VitomirDragan/TemperatureManagement-IOT-/Documentatie/DiplomaProject/interfata utilizator.tex

\chapter{Ghidul utilizatorului}\label{ch:5interfataUtilizator}

	În acest capitol voi descrie felul în care utilizatorul poate să interacționeze cu aplicația web și cu macheta ce simulează circuitul de încălzire dintr-un imobil, iar în cele din urmă voi prezenta una dintre optimizările esențiale aduse sistemului.

\section{Interfața cu utilizatorul}

	Toate paginile au aceeasi structură: antet, meniu de navigare și secțiune pentru afișarea conținutului.
	Antetul conține o imagine și un logo.
	Bara de navigare se adaptează în funcție de rolul utilizatorului, unele butoane devin, sau nu, disponibile.
	Secțiunea de conținut este diferită la fiecare pagină în parte.
	
\vspace{0.5em}

	Pagina \textit{Login} – structura acestei pagini este diferită față de celelalte. Conține un div cu imagine de fundal și un formular care face posibilă conectarea la aplicația web. Se vor introduce credențialele în câmpurile puse la dispoziție, iar după validarea acestora, se face redirecționarea la pagina principală.

\begin{figure}[H]
   	\centering
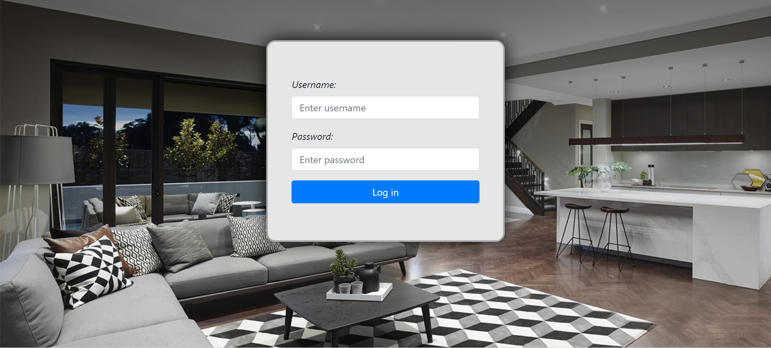
[picture p15: Documentatie/DiplomaProject/fig/Login.PNG]
    	
	\caption{Pagina de conectare}
\end{figure}

	Pagina \textit{Home} – este accesibilă pentru toți utilizatorii și permite monitorizarea si setarea temperaturii. Modificarea valorii temperaturii se face prin intermediul cursoarelor prezente pe pagină. Butonul \textit{Set temperature} va determina actualizarea valorilor în baza de date. Pentru a putea modifica modul de operare al sistemului, se actionează butonul din dreptul etichetei \textit{Switch intervals on/off}. Dacă modul de operare pe intervale orare este activat, alăturat butonului \textit{on/off}, va mai apărea un buton ce va permite redirecționarea la o nouă pagină unde se pot seta intervalele orare și temperaturile.

\begin{figure}[H]
   	\centering
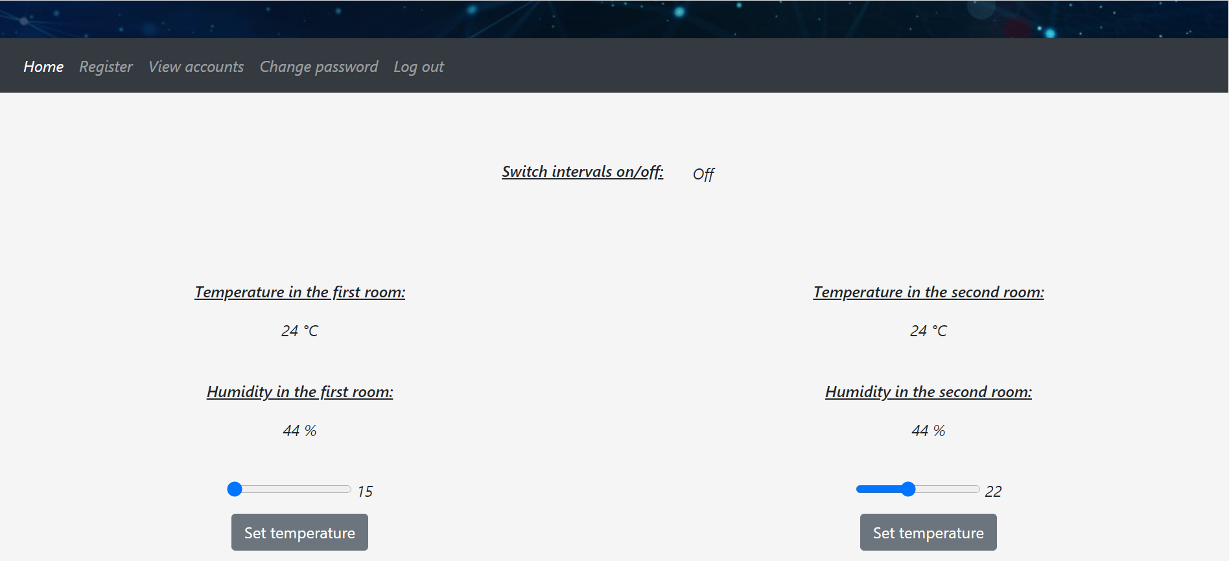
[picture p16: Documentatie/DiplomaProject/fig/Home.PNG]
    	
	\caption{Pagina de setare a temperaturilor}
\end{figure}

	Pagina pentru setarea unui program de funcționare este disponibilă doar în modul automat. Fiecare câmp creat pentru introducerea valorii temperaturii conține o etichetă ce indică intervalul pentru care este valabilă temperatura setată. De exemplu, câmpul cu eticheta \textit{Temperature 1} va conține valoarea temperaturii ce se aplică primului interval orar. Un interval orar are ca și capete două valori de timp setate în câmpuri consecutive.  

\begin{figure}[H]
   	\centering
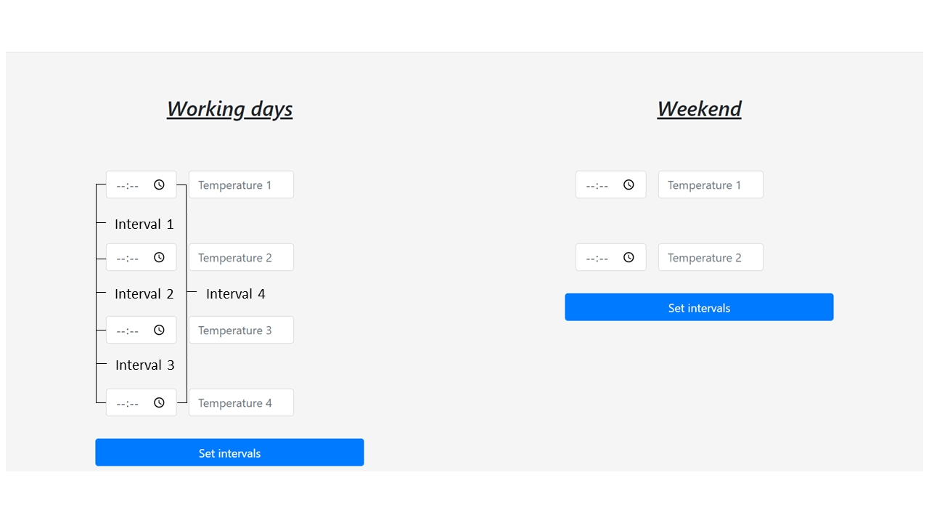
[picture p17: Documentatie/DiplomaProject/fig/SetIntervals.png]
    	
	\caption{Pagina de setare a programului de funcționare}
\end{figure}

	Pagina \textit{Register} – accesibilă doar pentru administrator și face posibilă crearea de noi conturi. Formularul permite introducerea credențialelor pentru contul creat, iar câmpul \textit{Give admin privileges?} este utilizat pentru setarea drepturilor.

\begin{figure}[H]
   	\centering
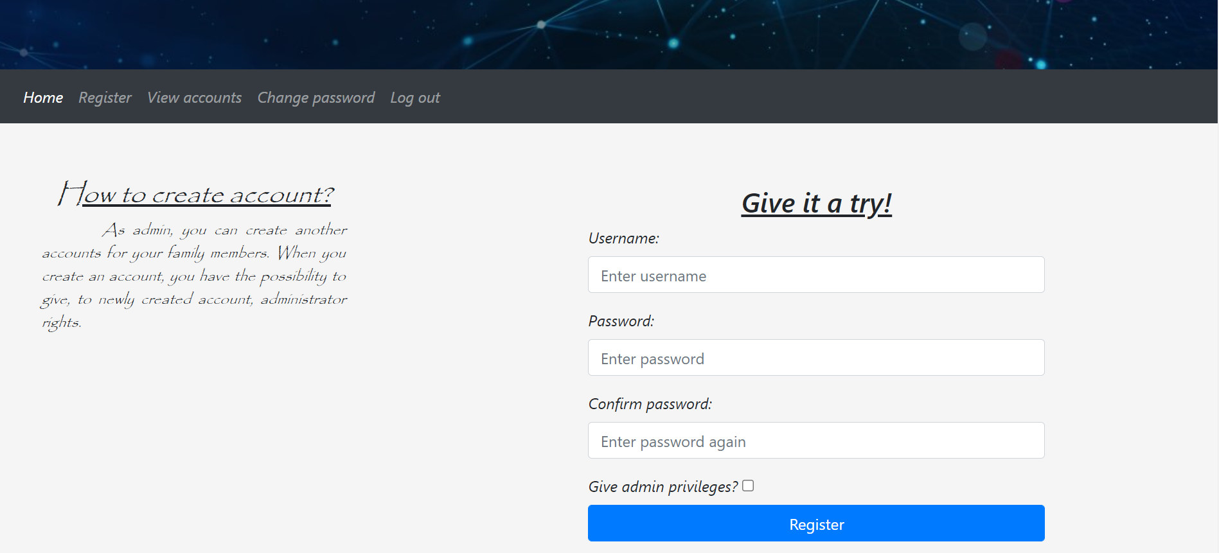
[picture p18: Documentatie/DiplomaProject/fig/Register.PNG]
    	
	\caption{Pagina creare cont}
\end{figure}

	Pagina \textit{View accounts} – este accesibilă doar de către administratori, oferind posibilitatea de a modifica drepturile utilizatorilor și de a șterge alte conturi. De asemenea, se afișează o listă cu toți utilizatorii, împreună cu drepturile acestora.

\begin{figure}[H]
   	\centering
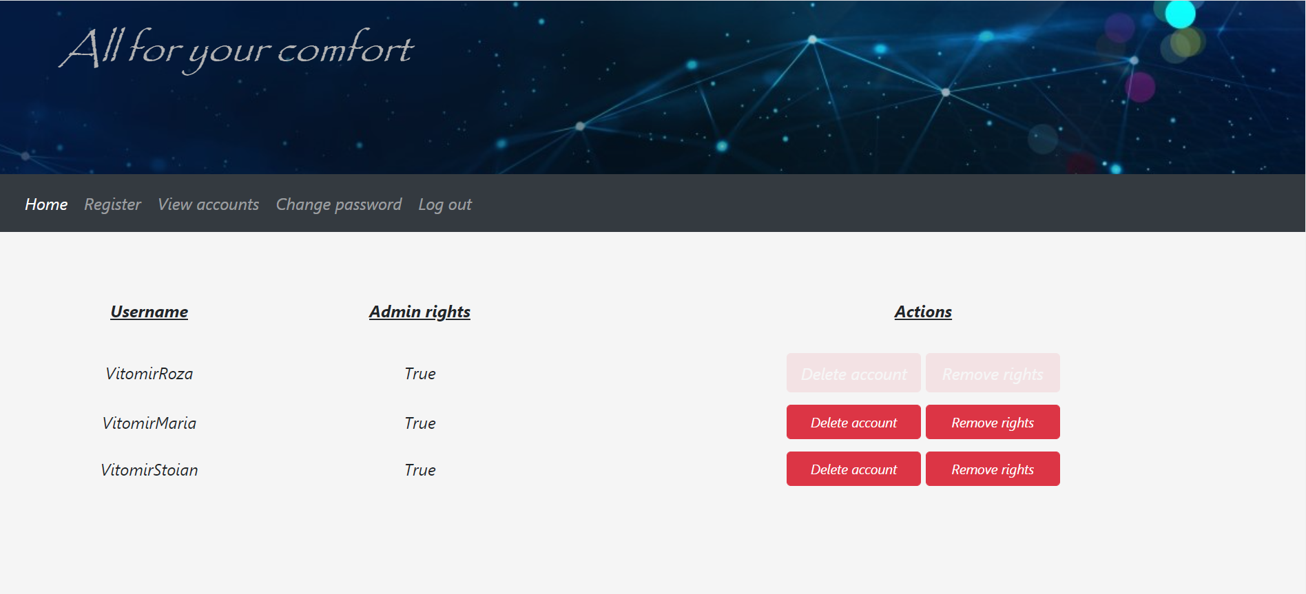
[picture p19: Documentatie/DiplomaProject/fig/ViewAccounts.PNG]
    	
	\caption{Pagina vizualizare conturi}
\end{figure}

	Pagina \textit{Change password} – permite modificarea parolei pentru fiecare utilizator. Câmpul \textit{Current password} trebuie completat cu parola actuală a contului curent, iar câmpurile \textit{New password} și \textit{Confirm new password} vor conține noua parolă, respectiv confirmarea noii parole.

\begin{figure}[H]
   	\centering
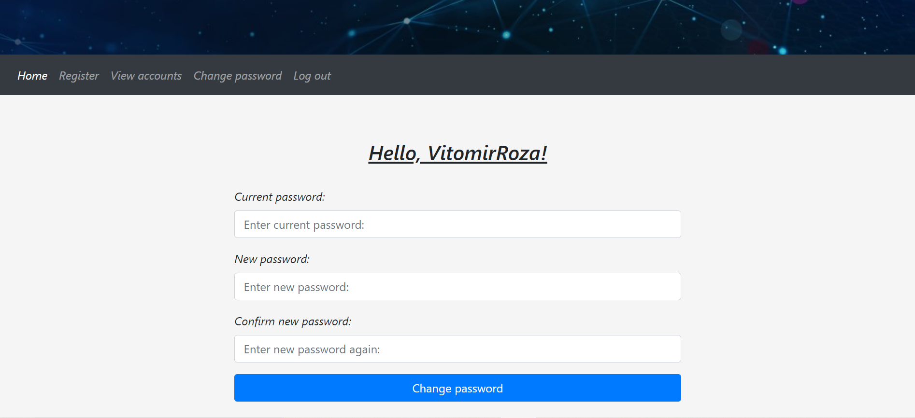
[picture p20: Documentatie/DiplomaProject/fig/changePassword.PNG]
    	
	\caption{Pagina schimbare parolă}
\end{figure}

\vspace{5em}

\section{Descriere și utilizare sistem}

	Pentru fiecare cameră în parte există un LCD ce va afișa, pe primul rând, temperatura ambientală, iar pe cel de-al doilea, temperatura setată de utilizator. Setarea temperaturii se face prin intermediul butoanelor situate în dreptul LCD-ului. Butonul poziționat în partea de sus este responsabil cu creșterea valorii temperaturii, pe când cel de jos va decrementa temperatura setată.

	Pompa de apă simulează funcționalitatea centralei termice, iar electrovalvele închid sau deschid circuitul de apă prin calorifer.
	
	Pentru a putea umple circuitul cu apă, se va utiliza aerisitorul. Acesta este montat în cel mai înalt punct al instalației.  

\begin{figure}[H]
   	\centering
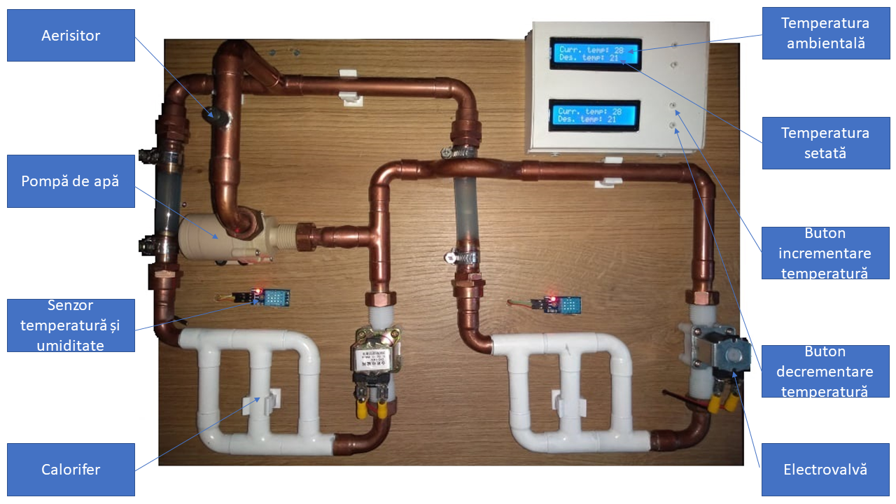
[picture p21: Documentatie/DiplomaProject/fig/Macheta-instalatie.png]
    	
	\caption{Circuitul de apă al machetei}
\end{figure}

	În interiorul machetei se află plăcuțele cu microcontroler. Acestea îndeplinesc diverse funcționalități și transmit informații între ele pentru a face posibil managementul temperaturii. 

	Transferul informațiilor cu baza de date se realizează prin intermediul modulului ESP8266. 
	
	Arduino Uno controlează pompa de apă în funcție de comenzile primite de la modulele wireless. Comunicația între modulele WiFi și plăcuța Arduino este posibilă datorită transmițătoarelor și receptorului ce funcționează prin radio - frecvență.

	Sunt utilizate transformatoare de 12 volți pentru alimentarea componentelor electronice.

\begin{figure}[H]
   	\centering
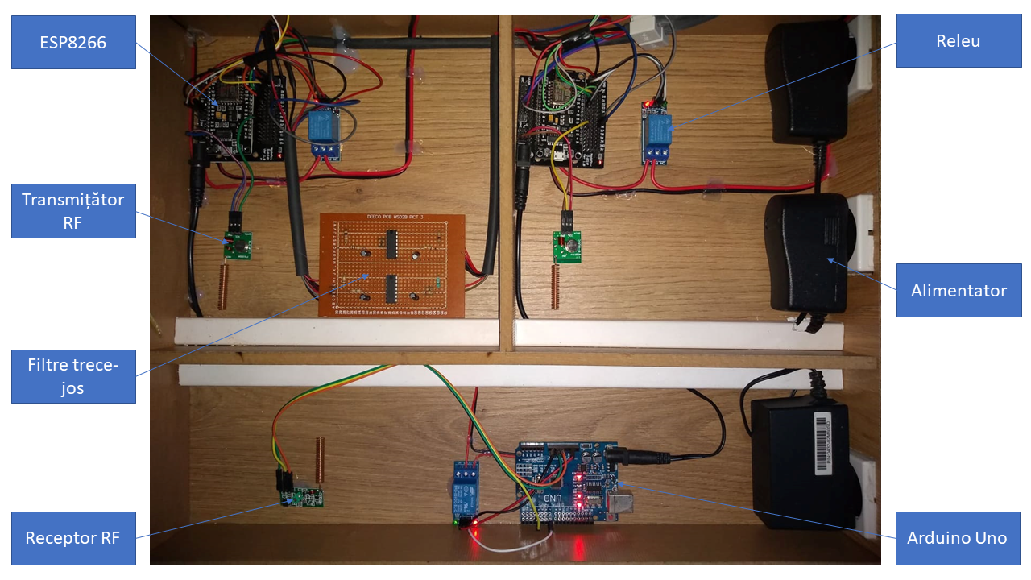
[picture p22: Documentatie/DiplomaProject/fig/Macheta-hardware.png]
    	
	\caption{Partea hardware a machetei}
\end{figure}

\section{Optimizare}

	În acest subcapitol voi prezenta una din optimizările pe care a fost necesar să o implementez pentru a reduce consumul de date. Resursele pe care baza de date le pune la dispoziție sunt limitate. Prin urmare, există și o limitare în ceea ce privește capacitatea datelor descărcate.

	Primele versiuni de cod pentru modulul WiFi făceau ca la fiecare iterație a instrucțiunii repetitive \textit{loop} să se citească valorile temperaturilor și intervalelor din baza de date. Motiv pentru care, consumul de date era mare.  În figura următoare, este ilustrată cantitatea de date citite în decursul a unei jumătăți de oră de funcționare.
 
\begin{figure}[H]
   	\centering
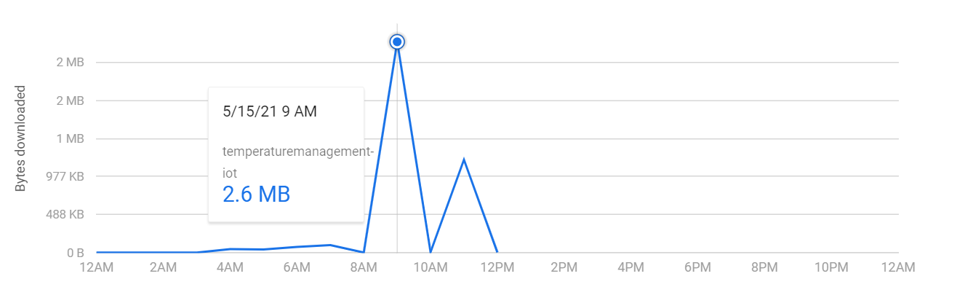
[picture p23: Documentatie/DiplomaProject/fig/FaraOptimizare.PNG]
    	
	\caption{Versiunea de cod neoptimizată}
\end{figure}

	Pentru a renunța la acest comportament, a fost necesară modificarea implementării codului. Astfel, citirile se vor realiza doar în momentul în care se modifică valorile din baza de date. În figura atașată, se ilustrează consumul de date în urma funcționării timp de jumătate de oră cu noul cod. În acest timp, pentru a face o simulare cât mai complexă, am setat diferite valori ale temperaturii prin intermediul aplicației web. 

\begin{figure}[H]
   	\centering
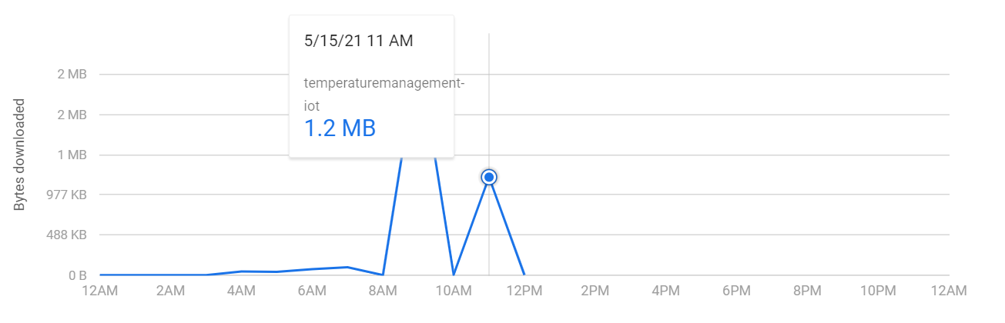
[picture p24: Documentatie/DiplomaProject/fig/CuOptimizare.png]
    	
	\caption{Versiunea de cod optimizată}
\end{figure}

	În urma acestui experiment, se poate observa o scădere considerabilă a consumului de date, fapt ce face posibilă funcționarea sistemului în mod continuu.
