VitomirDragan/TemperatureManagement-IOT-/Documentatie/DiplomaProject/state of the art.tex

\chapter{Prezentarea sistemelor similare}\label{ch:2sistemeSimilare}

	In momentul de față, acest subdomeniu se află la un nivel mare de răspândire. Există o serie de producători care comercializează sisteme ce permit controlul la distanță al temperaturii, însă au o deficență majoră și anume prețul ridicat. Voi prezenta mai multe astfel de sisteme, împreună cu detaliile tehnice ale acestora. 	

\section{Torelectric}
	Termostatul produs de firma Torelectric oferă mai multe modalități de reglare a temperaturii \cite{torelectric}:
	\begin{itemize}
  	\setlength{\itemindent}{2em}
		\itemsep0em
		\item Prin aplicație mobilă;
		\item Fizic, utilizând interfața termostatului;
		\item Prin comenzi vocale, utilizând Google Home și Alexa.
	\end{itemize}

	\begin{figure}[H]
    		\centering
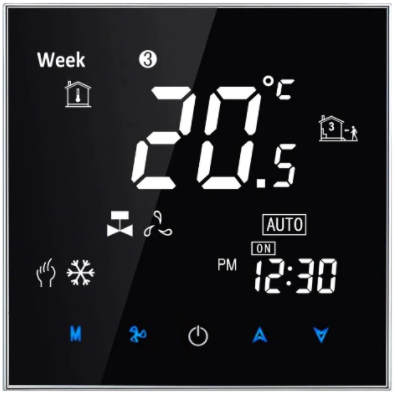
[picture p25: Documentatie/DiplomaProject/fig/Torelectric.PNG]
    		
		\caption{Termostat \textit{Torelectric} (sursa: \cite{torelectric})}
	\end{figure}

\vspace{2em}

	Ca și caracteristici principale se pot remarca \cite{torelectric}:
	\begin{itemize}
	\setlength{\itemindent}{2em}
		\itemsep0em
		\item Se conectează prin WiFi;
		\item Se alimentează la 220 de volți;
		\item Intervalul de setare al temperaturii este între 5 și 35 \textdegree{}C;
		\item Poate detecta valoarea temperaturii ambientale într-un interval între 0 și 45 \textdegree{}C.
	\end{itemize}

\section{Honeywell}

\begin{wrapfigure}{l}{0.55\textwidth} 
	\centering
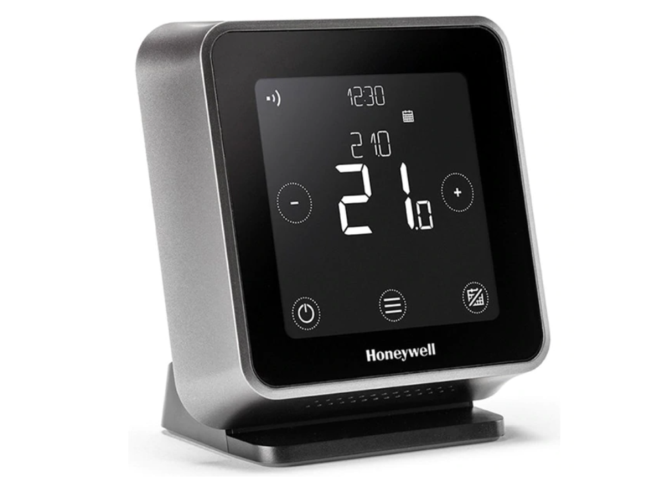
[picture p26: Documentatie/DiplomaProject/fig/Honeywell.PNG]
	
	\caption{Termostat \textit{Honeywell} (sursa: \cite{honeywell})}
\end{wrapfigure}

	Termostatul produs de Honeywell se diferențiază față de cel produs de Torelectric prin prezența unor funcționalități inovatoare. Printre particularitățile acestui dispozitiv se remarcă \cite{honeywell}:
	\begin{itemize}
	\setlength{\itemindent}{2em}
		\itemsep0em
		\item Adaptarea temperaturii în funcție de prezența sau absența unor persoane în locuință; 
		\item Programarea temperaturilor pentru șapte zile;
		\item Controlul de la distanță, oferit de aplicația mobilă;
		\item Setarea temperaturii prin comenzi vocale.
	\end{itemize}

	Comparativ cu primul sistem prezentat, cel de la Honeywell se deosebește prin tehnologia Geofencing. Acesta știe când imobilul nu este locuit, iar ca urmare, va dezactiva încălzirea. De asemenea, este capabil să detecteze momentul în care locuitorii sunt în apropierea casei, reușind să încălzească până la temperatura setată \cite{honeywell}.
	Un alt avantaj adus de cei de la Honeywell este posibilitatea de a seta temperatura pe decursul a șapte zile, fapt ce asigură un confort sporit, prin adaptarea temperaturii în funcție de diverse intervale orare \cite{honeywell}.

	Caracteristicile tehnice ale acestuia sunt \cite{honeywell}:
	\begin{itemize}
	\setlength{\itemindent}{2em}
		\itemsep0em
		\item Se folosește pentru centrale termice;
		\item Se alimentează la 220 de volți;
		\item Conexiunea la internet se realizează prin WiFi.
	\end{itemize}

	În continuare, voi prezenta două sisteme care reprezintă apogeul evoluției în acest domeniu. Acestea sunt produse de firme cunoscute precum: Google si Ecobee.

\section{Nest}
	Este un termostat inteligent produs de cei de la Google. Acesta oferă funcționalități avansate pentru un management cât mai eficient al temperaturii din imobil. 

	Spre deosebire de sistemele prezentate anterior, termostatele produse de Google Nest integrează tehnologii revoluționare pentru a obține un randament cât mai mare.

\vspace{2em}

	Principalele particularități ale acestuia sunt \cite{nest}:
	\begin{itemize}
	\setlength{\itemindent}{2em}
		\itemsep0em
		\item Capacitatea de a se programa automat, în funcție de rutina locuitorilor;
		\item Menține temperatura setată doar dacă există persoane în imobil, altfel trece automat la o temperatură ce asigură un consum cât mai mic de energie;
		\item Control de la distanță de pe laptop, tabletă și telefon;
		\item Salvarea unui istoric al consumului de energie;
		\item Tehnologie Geofencing;
		\item Se pot adăuga senzori pentru mai multe zone.
	\end{itemize}

\vspace{1em}

\begin{wrapfigure}[5]{l}{0.5\textwidth}
	\centering
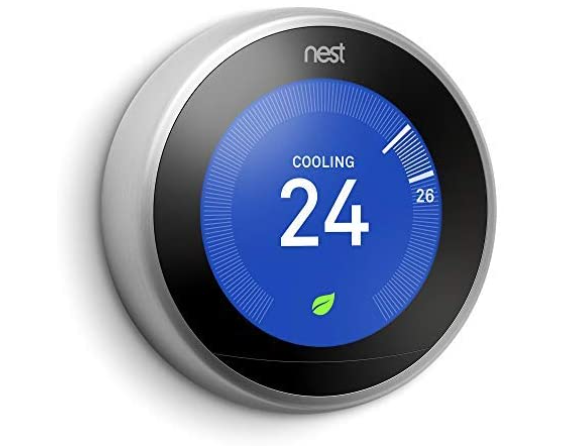
[picture p27: Documentatie/DiplomaProject/fig/Nest.PNG]
	
	\caption{Termostat \textit{Nest} (sursa: \cite{nest})}
\end{wrapfigure}

	Date tehnice \cite{nest}:
	\begin{itemize}
	\setlength{\itemindent}{2em}
		\itemsep0em
		\item Sursă de energie: baterii;
		\item Tensiune de funcționare: 24 volți;
		\item Afișaj digital;
		\item Conectivitate: WiFi.
	\end{itemize}

\vspace{3em}

\section{Ecobee}
	 Termostatul produs de firma Ecobee concurează cu Google Nest. Acesta oferă, pe lângă funcțiile complexe, posibilitatea de monitorizare detaliată a consumului de energie \cite{ecobee}.
	
\vspace{2em}

	Particularități \cite{ecobee}:
	\begin{itemize}
	\setlength{\itemindent}{2em}
		\itemsep0em
		\item Poate fi controlat prin intermediul unor aplicații precum: Apple HomeKit, Alexa built-in, Google Assistant și SmartThings. De asemenea, oferă posibilitatea de a seta temperatura de pe Android, dar si de pe iOS;
		\item Implementează un algoritm ce permite controlul temperaturii în diverse locuri din imobil. Se pot conecta mai mulți senzori de temperatura la termostat, iar în funcție de informațiile primite de la aceștia, menține o temperatură constantă în locuință;
		\item Ecranul se aprinde atunci când detectează o persoană în apropiere, iar pe lângă informațiile legate de temperatură si umiditate, se afișează și vremea pe decursul a cinci zile;
		\item Este prezentă tehnologia Geofencing.
	\end{itemize}

\vspace{2em}

\begin{wrapfigure}[5]{r}{0.5\textwidth}
	\centering
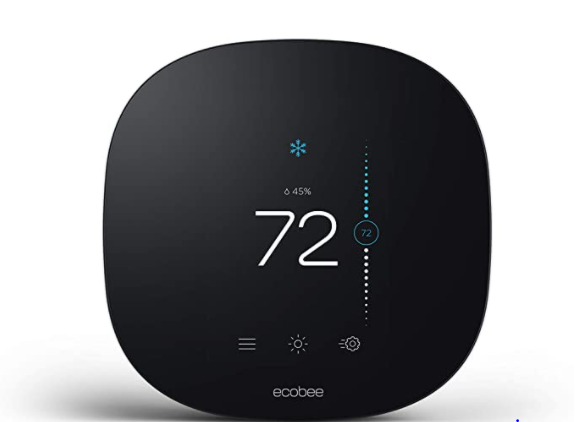
[picture p28: Documentatie/DiplomaProject/fig/Ecobee.PNG]
	
	\caption{Termostat \textit{Ecobee} (sursa: \cite{ecobee})}
\end{wrapfigure}

	Date tehnice \cite{ecobee}:
	\begin{itemize}
	\setlength{\itemindent}{2em}
		\itemsep0em
		\item Sursă de energie: baterii sau rețea;
		\item Tensiune de funcționare: 24 volți;
		\item Ecran tactil;
		\item Conectivitate: WiFi.
	\end{itemize}
\vspace{0.5em}

\section{Abordare comparativă a sistemelor prezentate}
	Dacă primele două sisteme prezentate reprezentau soluții mai ieftine, ultimele două sunt recunoscute ca fiind cele mai evoluate termostate existente pe piață. Diferențele esențiale sunt vizibile la nivelul funcționalităților oferite, dar și al calității.

	Lipsa posibilității de a programa în avans temperaturi pe mai multe intervale orare și zile, de a monitoriza temperatura în mai multe camere, de a stoca un istoric al consumului de energie și de a adapta temperaturile în funcție de rutina locuitorilor, sunt câteva din minusurile termostatelor Torelectric și Honeywell. Google Nest și Ecobee, pe lângă faptul că rezolvă aceste probleme, oferă și o experiență mult mai bună a utilizatorului. Interfețele sunt proiectate în așa fel încât să permită o navigare facilă prin meniurile sistemelor.  

	În continuare, cu ajutorul datelor preluate din \cite{ecobeeVSnest}, voi prezenta o analiză comparativă a sistemelor oferite de Google Nest și Ecobee. 

	Termostatul Nest înregistrează fiecare modificare de temperatură pe care utilizatorul o face. După o perioadă de timp, acesta va programa automat temperaturile din imobil în funcție de istoricul de temperaturi setate de utilizator. Ecobee nu prezintă această funcționalitate, dar oferă posibilitatea de a seta temperaturi diferite pe intervale orare diferite. 

	In ceea ce privește controlul prin comenzi vocale, Nest este compatibil cu un număr mai mic de asistenți virtuali(Google Assistant si Alexa). Ecobee este compatibil și cu Siri, fapt ce reprezintă un avantaj datorită numărului mai mare de potențiali clienți. 

	Tehnologia Geofencing constă în detecția momentului în care imobilul este gol și setarea unei temperaturi ce asigură un consum minim de energie. Totodată, poate detecta dacă locuitorii se apropie de imobil, pentru a ieși din modul economic și a asigura temperatura setată. Geofencing este prezent la ambele termostate, însă la Nest este mai avansat. Poate detecta mai multe telefoane, iar în cazul în care sunt persoane care rămân în locuință și nu au telefonul conectat la Geofencing, prezența acestora este sesizată prin senzorii de mișcare incorporați în detectoarele de fum Nest, iar modul eco nu va fi activat. Ecobee poate conecta un singur telefon la Geofencing, ceea ce poate reprezenta un dezavantaj.

	  Monitorizarea consumului de energie se face automat, dar cei de la Ecobee au pus mai mult accent pe această parte, iar raportul pe care termostatul îl face este mult mai detaliat. Se analizează datele în decursul a 18 luni și conține informații legate de: consumul total, influența vremii asupra consumului de energie și compară eficiența imobilului cu celelalte din zonă. Pe de altă parte, Nest poate înregistra doar cosumul în decursul a 10 zile. Acesta trimite mail-uri în fiecare lună cu un raport ce conține detalii de consum de energie și face comparație cu luna anterioară.

	Monitorizarea temperaturii se face în mai multe zone din imobil prin intermediul unor senzori adiționali. Cele două termostate încearcă să mențină o temperatură medie în locuință. Senzorii oferiți de Ecobee detectează și dacă se află cineva în încăperea respectivă. 

\section{Comparație cu sistemul prezentat în această lucrare}

	În urma analizei sistemelor existente pe piață, se pot observa două dezavantaje majore. În primul rând, menținerea unor temperaturi exacte în fiecare cameră din imobil este destul de greu de obținut. Chiar dacă se pot adăuga mai mulți senzori de temperatură, termostatele prezentate vor reuși să asigure o temperatură medie la nivel de imobil și nu o temperatură specifică la nivel de cameră. De asemenea, prețurile acestora sunt destul de ridicate. Prin proiectul de diplomă, am încercat să soluționez aceste probleme. Costurile pieselor pe care le-am utilizat sunt accesibile, iar electrovalvele montate pe returul caloriferelor au rolul de a asigura menținerea temperaturii setate în fiecare cameră.
