VitomirDragan/TemperatureManagement-IOT-/Documentatie/DiplomaProject/titlepage.tex

\newgeometry{centering}
\begin{titlepage}
    \begin{center}
        \begin{minipage}{0.3\textwidth}
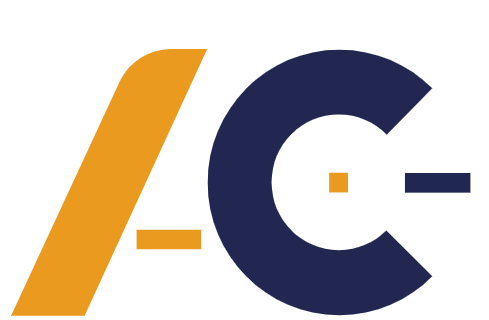
[picture p29: Documentatie/DiplomaProject/fig/ACLogo.jpg]
                \scalebox{0.25}{}
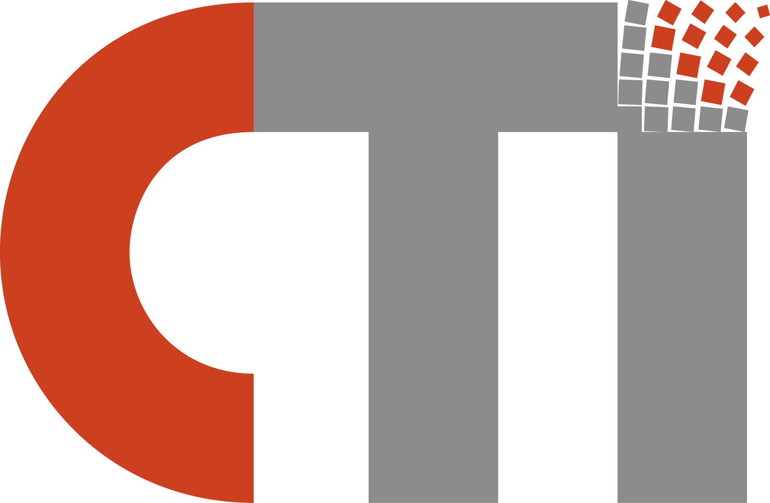
[picture p30: Documentatie/DiplomaProject/fig/DCTILogo.png]
                \scalebox{0.25}{}
        \end{minipage}%
        \begin{minipage}{0.4\textwidth}
            \centering
            \scriptsize
            Universitatea Politehnica Timișoara\\
            Facultatea de Automatică și Calculatoare\\
            Departamentul Calculatoare și \\Tehnologia Informației
        \end{minipage}%
        \begin{minipage}{0.3\textwidth}
            \begin{flushright}
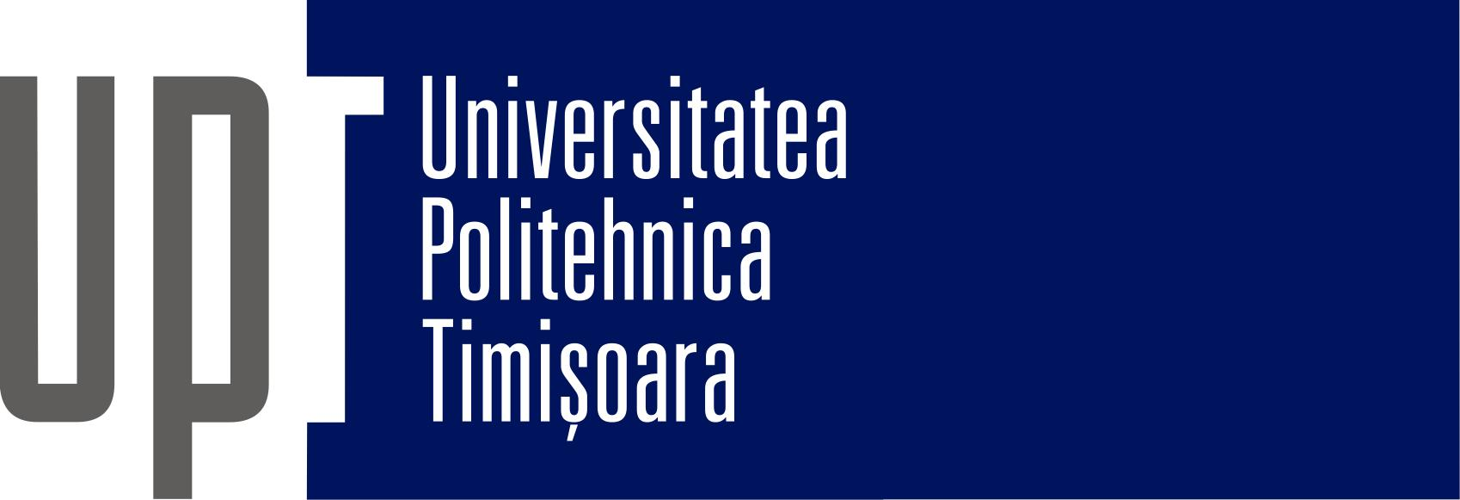
[picture p31: Documentatie/DiplomaProject/fig/UPTLogo.jpg]
                \scalebox{0.25}{}
            \end{flushright}
        \end{minipage}
    \end{center}
    
    \noindent\rule{\textwidth}{1pt}\\[4cm]
    
    \begin{center}
        \begin{doublespacing}
		{\huge \bfseries \textsc{Termostat inteligent controlat printr-o aplicație web}}\\[2.5cm]
	 \end{doublespacing}
        {\large \bfseries Proiect de Diplomă}\\[2cm]
        \begin{flushright}
            \large
            Autor:\\
	      Dragan VITOMIR\\[1cm]
        \end{flushright}
        \begin{flushleft}
            \large
            Conducător științific:\\
            Prof. Dr. Habil. Ing. Marius MARCU\\[2cm]
        \end{flushleft}
        {\small Timișoara \\Iunie, 2021}
    \end{center}
\end{titlepage}
\restoregeometry
\shipout\null
