VitomirDragan/TemperatureManagement-IOT-/Macheta-hardware.pptx

ESP8266

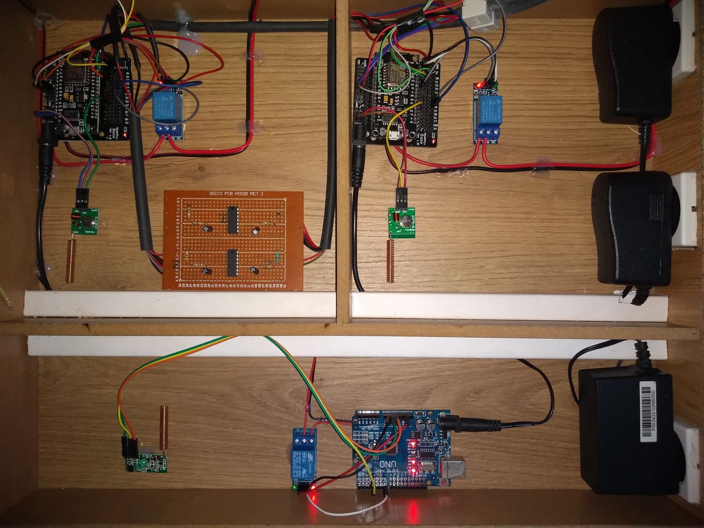
[picture p32: figure]

Releu

Transmițător RF

Alimentator

Filtre trece-jos

Receptor RF

Arduino Uno
