VitomirDragan/TemperatureManagement-IOT-/Macheta-instalatie.pptx

Aerisitor

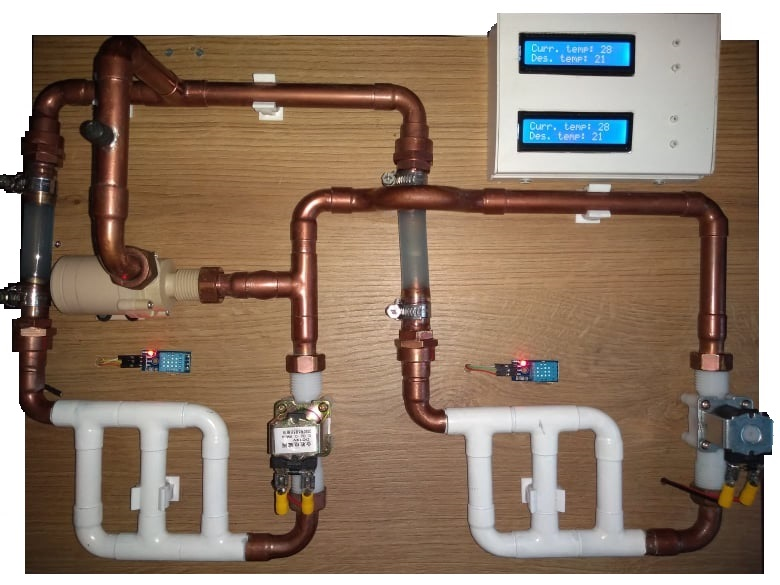
[picture p33: figure]
O imagine care conține text, interior Descriere generată automat

Temperatura ambientală

Temperatura setată

Pompă de apă

Buton incrementare temperatură

Senzor temperatură și umiditate

Buton decrementare temperatură

Calorifer

Electrovalvă
