VitomirDragan/TemperatureManagement-IOT-/Diagrame/Template etichete modul senzor.pptx

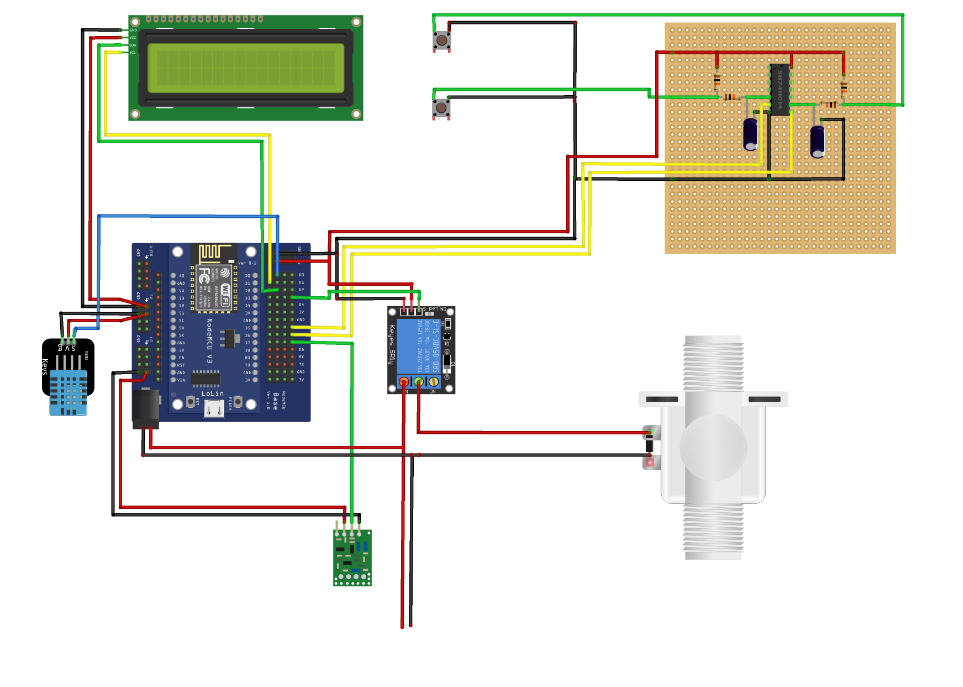
[picture p34: figure]

Inversor

LCD

Buton

Releu

DHT11

Diodă

ESP8266

Transmițător RF

Alimentator 12 V

Electrovalvă
