VitomirDragan/TemperatureManagement-IOT-/Diagrame/Template etichete modul control.pptx

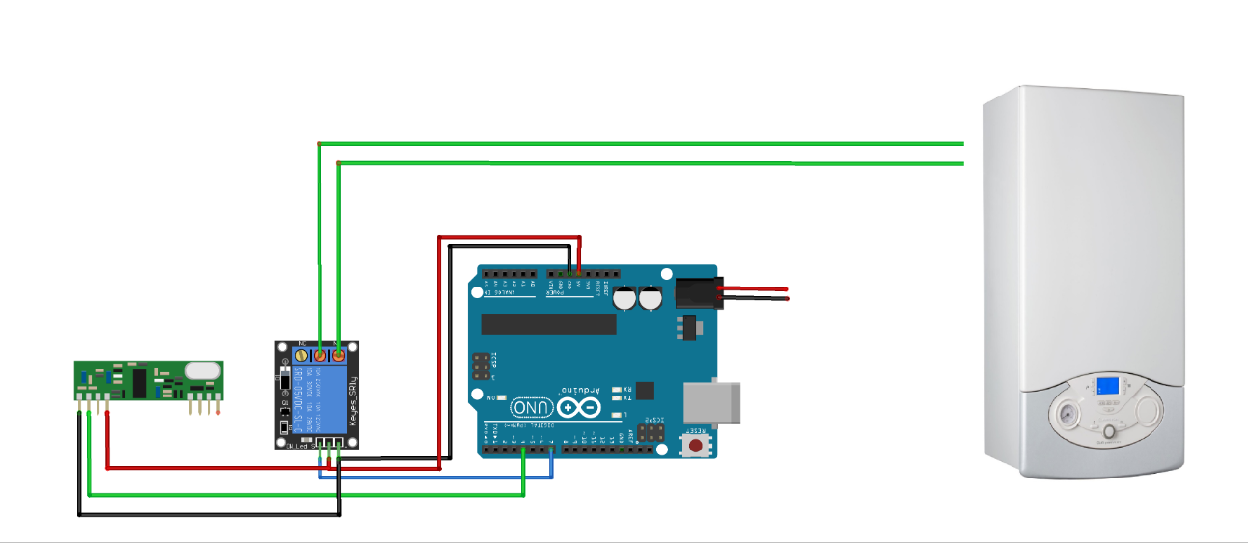
[picture p36: figure]

Releu

Receptor RF

Alimentator 12 V

Arduino

Centrala termică
