VitomirDragan/TemperatureManagement-IOT-/Documentatie/DiplomaProject/main.pdf

Universitatea Politehnica Timis,oara Facultatea de Automatica s ˘ ,
i Calculatoare
Departamentul Calculatoare s,

i
Tehnologia Informat,

iei

TERMOSTAT INTELIGENT,

# CONTROLAT PRINTR-O APLICAT

,

IE

# WEB

### Proiect de Diploma˘

### Autor: Vitomir Dragan

Conducator s ˘ ,
tiint,

### ific Prof. Dr. Habil. Ing. Marius Marcu

Timis, oara
Iunie, 2021

# Cuprins

1 Introducere | 3
2 Prezentarea sistemelor similare | 6
2.5 Abordare comparativa a sistemelor prezentate | ˘ | 9
2.6 Comparat,
ie cu sistemul prezentat în aceasta lucrare | ˘ | 10
3 Fundamente teoretice | 11
3.5.2 | Placa de baz ˘ | a pentru NodeMCU | ˘ | 13
3.5.6 | Modul radio frecvent,a | ˘ | 14
3.5.8 | Electrovalva | ˘ | | 15
3.5.9 | Pompa de ap ˘ | a | ˘ | 15
3.5.12 Rezistent,a | ˘ | 15

1

CUPRINS | 2
3.5.14 Dioda | ˘ | 15

4 Dezvoltarea solut,

iei | 20
4.1.1 | Cerint,ele funct,

ionale ale aplicat,
4.1.2 Cerint,e nefunct,

ionale ale aplicat,
4.1.3 | Cerint,e funct,
4.1.4 | Cerint,e nefunct,
4.3 Proiectare detaliata | ˘ | 28
4.3.1 | Diagrama de clase | ˘ | 29
4.3.2 | Diagrame de secvent,a | ˘ | 30
4.3.3 | Structura software | ˘ | 34
4.4 Implementarea solut,
4.4.2 | Programare placut ˘ ,a Arduino | ˘ | 42
4.4.3 | Realizarea aplicat,
4.4.4 | Probleme întâmpinate în timpul realizarii proiectului | ˘ | 50
4.5 Testarea solut,
5 Ghidul utilizatorului | 55

6 Concluzii s,

i direct,

ii de dezvoltare | 56

# Capitolul 1

# Introducere

## 1.1 Internet of things

Nivelul de evolut,

ie la care a ajuns tehnologia în zilele noastre, da nas ˘ , tere dorint,ei de
a spori confortul viet,

ii cotidiene prin cres,

terea gradului de interconectare al dispozitivelor inteligente.
Scopul primordial al conceptului de Internet Of Things este de a face posibila co- ˘
municarea între obiectele care prezinta utilitate în viat ˘ | ,a de zi cu zi. Acesta reprezinta o ˘
ret,ea vasta de dispozitive interconectate care sunt capabile s ˘ | a ia decizii f ˘ | ar˘ a intervent ˘ | ,
ie
din exterior. Prin intermediul senzorilor sunt preluate diverse date din mediul înconju-
rator, date care, în urma prelucr ˘ | arilor, determin ˘ | a execut ˘ | ,
ia anumitor act,

iuni.
Contrar as,
teptarilor, ideea de Internet of Things nu a ap ˘ | arut recent. Primul dispozi- ˘
tiv care implementa conceptul de IoT a fost lansat în anul 1982, fiind reprezentat de un
tonomat de Coca-Cola care putea sa trimit ˘ | a informat ˘ | ,

ii pe internet referitoare la numarul ˘
de doze disponibile si temperatura bauturilor [1]. În anul 1990, invent ˘ | ,
ia lui John Romkey, toaster-ul controlat prin internet [2], stârnes,

te tot mai mult interesul asupra ideii de
control de la distant,a al dispozitivelor. În decursul anilor, tot mai multe firme produc ˘ | a-˘
toare de electronice au încercat sa ofere client ˘ | ,
ilor produse care pot transfera date prin intermediul internetutlui. De exemplu, în anii 2000, firma LG a produs un frigider care se putea conecta la internet prin WiFi [2].
Chiar daca dispozitivele care au marcat debutul IoT nu ofer ˘ | a funct ˘ | ,

ionalitat˘,
i mult
prea utile, în ultimii ani s-a dovedit ca transferul de date între dispozitive, f ˘ | ar˘ a a uti- ˘
liza conductori electrici, poate fi folositor chiar s,

i în domenii cheie. Astfel, medicina, armata, transporturile s,

i imobiliarele sunt doar câteva exemple de domenii care au fost influent,ate de acest concept.
Medicina - se urmares ˘ ,

te implementarea conceptului de monitorizare de la distant,a,˘ prin intermediul unor aparate care au rolul de a înregistra date legate de starea de sa-˘
natate a pacientului s ˘ | ,
i de a le trimite într-o baza de date accesibil ˘ | a de c ˘ | atre personalul ˘

3

1.1. INTERNET OF THINGS | 4

medical [3].
Armata - prezinta dispozitive de spionaj s ˘ | | ,
i de supreveghere de ultima generat ˘ | ,
| | | | ie, toate
acestea fiind posibile datorita ideii de Internet of Things [4]. ˘
Industria transporturilor - în acest domeniu, IoT poate fi ilustrat prin transferul de date între un autovehicul s,

i infrastructura, pietoni sau un alt autovehicul. Acest concept ˘ poarta denumirea de V2X, iar beneficiul major pe care îl poate aduce este reducerea
considerabila a num ˘ | arului de accidente [5]. ˘
Imobiliare - în zilele noastre, se întâlnes,

te din ce în ce mai des ideea de casa inteli- ˘
genta. Aceasta se rezum ˘ | a la faptul c ˘ | a, dispozitivele inteligente din cas ˘ | a comunic ˘ | a atât ˘
intre ele cât s,

i cu electrocasnicele, reus,

ind sa creeze un mediu cât mai confortabil pentru locuitori.
Faptul ca domeniul IoT prezint ˘ | a o utilitate care nu poate fi neglijat ˘ | a, explic ˘ | a cres ˘ | , terea
exponent,
iala a num ˘ | arului de dispozitive interconectate. Conform unei statistici publi- ˘
cate de catre Arne Holst, conduc ˘ | atorul echipei de cercetare din cadrul companiei Sta- ˘
tista, se aproximeaza ca în 2030 s ˘ | a se ajung ˘ | a la un num ˘ | ar mai mare de 25.4 miliarde de ˘
dispozitive IoT [6].

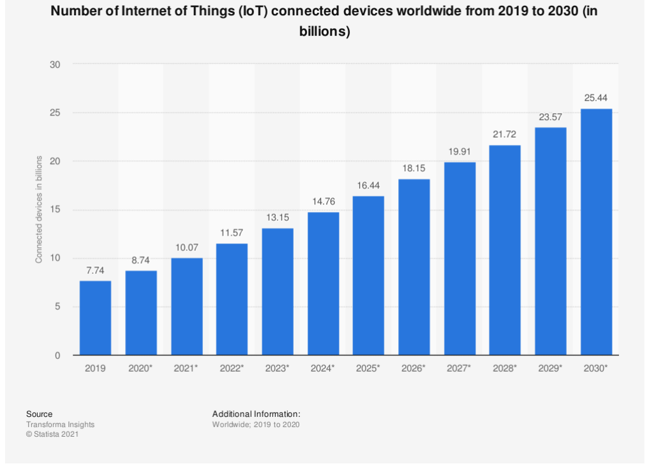
[picture p37: figure]

Figura 1.1: Evolut,

ia numarului de dispozitive IoT (sursa: [6]) ˘

1.2. CONTEXTUL DE REALIZARE | 5

## 1.2 Contextul de realizare

Doresc ca prin intermediul proiectului sa prezint beneficiile pe care automatizarea s ˘ | ,
i
conceptul de IoT le pot aduce. Sistemul creat abordeaza una dintre problemele care pot ˘ interveni la nivelul unei locuint,e s,

i se foloses,

te de transferul de date la distant,a, între ˘ diverse componente electronice, pentru a solut,

iona disconfortul termic.
Problema pe care încerc sa o rezolv, prin intermediul proiectului, am sesizat-o la ˘ apartamentul în care locuiesc. Acesta prezinta dou ˘ a camere de dimensiuni diferite, iar ˘ în sezonul rece ne confruntam cu un disconfort termic cauzat de diferent,ele de tempera-
tura între cele dou ˘ | a camere. Termostatul este montat în camera mare, fapt ce determina ˘
ca temperatura din camera mica sa fie mai mare decât cea setat ˘ | a. Nici mutarea termos- ˘
tatului in camera mica nu reprezenta o solut ˘ | ,
ie, din cauza c ˘ a timpul necesar înc ˘ | alzirii ˘
camerei mari este mai mare decât cel pentru camera mica, ajungându-se ca în camera ˘
mare sa fie tot timpul mai rece. Prin urmare, aceasta inconvenient ˘ | ,a m-a motivat s ˘ | a creez ˘
un sistem care sa reus ˘ | , easca s ˘ a ment ˘ | ,
ina o temperatur ˘ | a constant ˘ | a în apartament. ˘
La nivel non-tehnic, solut,
ia consta în montarea în fiecare camer ˘ | a a unor module ˘
ce monitorizeaza temperatura, iar în funct ˘ | ,

ie de aceasta, comanda atât electrovalvele ˘ montate pe returul caloriferelor, cât s,

i centrala. Rolul electrovalvei este de a închide
sau deschide circuitul de apa din calorifer. De asemenea, este necesar ca lâng ˘ | a centrala ˘
termica s ˘ a se monteze un modul care are rolul de a porni sau de a opri centrala în funct ˘ | ,
ie
de comanda primita de la modulele montate în camere. Acest modul se conecteaz ˘ | a la ˘
centrala prin intermediul unor fire, iar transferul de date între modulele din camere s ˘ | ,
i
modulul de control al centralei se face prin radio frecvent,a. Pot fi setate temperaturi ˘ diferite pentru fiecare camera în parte. Setarea se poate face fizic, prin intermediul unor ˘
butoane, sau de la distant,a, prin intermediul unei aplicat ˘ | ,
ii web sau prin comenzi vocale
interpretate de Google Assistant. Sistemul prezinta dou ˘ | a moduri de funct ˘ | ,
ionare. Primul
mod consta în ment ˘ | ,

inerea temperaturii setate, far˘ a a t ˘ ,

ine cont de ora sau de faptul c ˘ | a ziua ˘
curenta este lucr ˘ | atoare sau nu. Cel de-al doilea mod, ofer ˘ | a posibilitatea utilizatorului de ˘
a seta, prin intermediul aplicat,

iei web, temperaturi diferite pe anumite intervale orare ale zilei. Sistemul permite setarea a patru intervale orare în timpul zilelor lucratoare ale ˘
sapt ˘ amânii, iar pentru weekend pot fi setate dou ˘ | a intervale. ˘

# Capitolul 2

# Prezentarea sistemelor similare

In momentul de fat,a, acest subdomeniu se afl ˘ | a la un nivel mare de r ˘ | aspândire. Exist ˘ | a˘
o serie de producatori care comercializeaz ˘ | a sisteme ce permit controlul la distant ˘ | ,a al ˘
temperaturii, însa au o deficent ˘ | ,a major ˘ | a, s ˘ ,
i anume, pret,ul ridicat. Voi prezenta mai multe astfel de sisteme, împreuna cu detaliile tehnice ale acestora. ˘

## 2.1 Torelectric

Termostatul produs de firma Torelectric ofera mai multe modalit ˘ | at˘,
i de reglare a temperaturii [7]:
- Prin aplicat,

ie mobila˘

- Fizic, utilizând interfat,a termostatului
- Prin comenzi vocale, utilizând Google Home s,

i Alexa

Ca s,

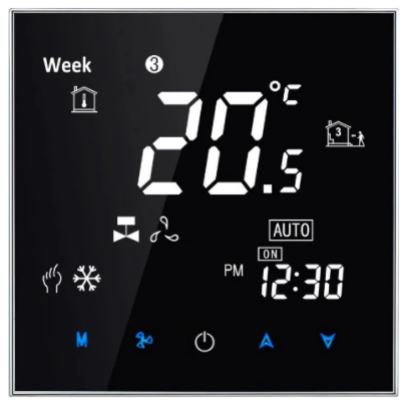
[picture p38: figure]

i caracteristici principale se pot remarca [7]:

- Conectivitate: Wi-Fi

6

2.2. HONEYWELL | 7
- Tip alimentare: la retea
- Precizie: ±2 °C sau ±1 °C
- Setare temperatura intre: 5 - 35 °C ˘
- Temperatura ambiental ˘ | a: 0 - 45 °C ˘

## 2.2 Honeywell

Termostatul produs de Honeywell se diferent,

iaza˘
fat,a de cel produs de Torelectric prin prezent ˘ | ,a unor
funct,


ionalitat˘,

i inovatoare. Printre particularitat˘, ile
acestui dispozitiv se remarca [8]: ˘
- Adaptarea temperaturii în funct,

ie de
prezent,a sau absent,a unor persoane în locuint,a˘
- Programarea temperaturilor pentru s, apte zile
- Controlul de la distant,a, oferit de ˘ aplicat,

ia mobila˘

- Setarea temperaturii prin comenzi vocale

Comparativ cu primul sistem prezentat, cel de la Honeywell se deosebes,

te prin tehnologia Geofencing. Acesta s,

tie când imobilul nu este locuit, iar ca urmare, va dezactiva
încalzirea. De asemenea, este capabil s ˘ | a detecteze momentul în care locuitorii sunt în ˘
apropierea casei, reus,
ind sa înc ˘ | alzeasc ˘ | a pân ˘ | a la temperatura setat ˘ | a [8]. Un alt avantaj ˘
adus de cei de la Honeywell este posibilitatea de a seta temperatura pe decursul a s, apte
zile, fapt ce asigura un confort sporit, prin adaptarea temperaturii în funct ˘ | ,
ie de diverse
intervale orare [8].
Caracteristicile tehnice ale acestuia sunt [8]:
- Destinat: centrale termice
- Suprafata de montare: masa˘
- Tip alimentare: la ret,ea
- Conectivitate: Wi-Fi
În continuare, voi prezenta doua sisteme care reprezint ˘ | a apogeul evolut ˘ | ,
iei în acest
domeniu. Acestea sunt produse de firme cunoscute precum: Google si Ecobee.

2.3. NEST | 8

## 2.3 Nest

Este un termostat inteligent produs de cei de la Google. Acesta ofera funct ˘ ,

ionalitat˘,
i
avansate pentru un management, cât mai eficient, al temperaturii din imobil.
Spre deosebire de sistemele prezentate anterior, termostatele produse de Google
Nest integreaza tehnologii revolut ˘ | ,
ionare pentru a obt,

ine un randament cât mai mare.

Principalele particularitat˘,
i ale acestuia sunt [9]:
- Capacitatea de a se programa automat, în funct,

ie de rutina locuitorilor

- Ment,
ine temperatura setata doar dac ˘ | a exist ˘ | a persoane în imobil, altfel trece ˘
automat la o temperatura ce asigur ˘ | a un consum cât mai mic de energie ˘
- Control de la distant,a de pe laptop, tablet ˘ | | a s ˘ , i telefon
- Salvarea unui istoric al consumului de energie
- Tehnologie Geofencing
- Se pot adauga senzori pentru mai multe zone ˘

Date tehnice [9]:

| • Sursa de energie: baterii ˘
- Tensiune de funct,

ionare: 24 volt,

i

- Afis, aj digital
- Conectivitate: WiFi


## 2.4 Ecobee

Termostatul produs de firma Ecobee concureaza cu Google Nest. Acesta ofer ˘ | a, pe ˘
lânga funct ˘ | ,

iile complexe, posibilitatea de monitorizare detaliata a consumului de energie ˘ [10].

Particularitat˘,
i [10]:
- Poate fi controlat prin intermediul unor aplicat,

ii precum: Apple HomeKit,
Alexa built-in, Google Assistant s,

i SmartThings. De asemenea, ofera posibilitatea ˘ de a seta temperatura de pe Android, dar si de pe iOS.

2.5. ABORDARE COMPARATIVA A SISTEMELOR PREZENTATE | 9 ˘
- Implementeaza un algoritm ce permite controlul temperaturii în diverse lo- ˘ curi din imobil. Se pot conecta mai mult,

i senzori de temperatura la termostat, iar în funct,

ie de informat,

iile primite de la aces,

tia, ment,

ine o temperatura constant ˘ | a˘
în locuint,a.˘
- Ecranul se aprinde atunci când detecteaza o persoan ˘ | a în apropiere, iar pe ˘
lânga informat ˘ | ,
iile legate de temperatura si umiditate, se afis ˘ | , eaza si vremea pe ˘
decursul a cinci zile.
- Este prezenta tehnologia Geofencing ˘

Date tehnice [10]:

- Sursa de energie: baterii sau ret ˘ | ,ea
- Tensiune de funct, | ionare: 24 volt, i
- Ecran tactil
- Conectivitate: WiFi

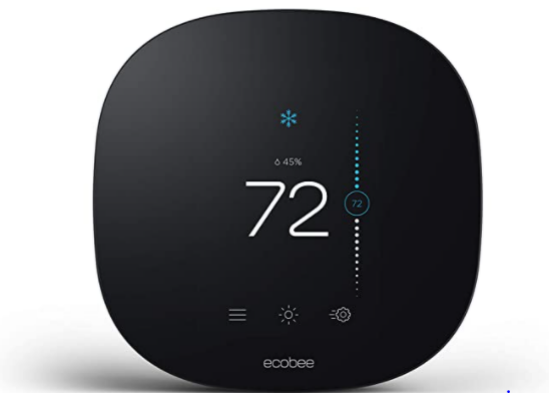
[picture p39: figure]

## 2.5 Abordare comparativa a sistemelor prezentate ˘

Daca primele dou ˘ | a sisteme prezentate reprezentau solut ˘ | ,

ii mai ieftine, ultimele doua˘
sunt recunoscute ca fiind cele mai evoluate termostate existente pe piat,a. Diferent ˘ | ,ele
esent,

iale sunt vizibile la nivelul funct,

ionalitat˘,
ilor oferite, dar s,

i al calitat˘,
ii.
Lipsa posibilitat˘,
ii de a programa în avans temperaturi pe mai multe intervale orare s,

i
zile, de a monitoriza temperatura în mai multe camere, de a stoca un istoric al consumului de energie s,

i de a adapta temperaturile în funct,

ie de rutina locuitorilor, sunt câteva din minusurile termostatelor Torelectric s,

i Honeywell. Google Nest s,

i Ecobee, pe lânga˘
faptul ca rezolv ˘ | a aceste probleme, ofer ˘ | a s ˘ ,
i o experient,a mult mai bun ˘ | a a utilizatorului. ˘
Interfet,ele sunt proiectate în as, a fel încât sa permit ˘ | a o navigare facil ˘ | a prin meniurile ˘
sistemelor.
În continuare, cu ajutorul datelor preluate din [11], voi prezenta o analiza compara- ˘
tiva a sistemelor oferite de Google Nest s ˘ | ,
i Ecobee.
Termostatul Nest înregistreaza fiecare modificare de temperatur ˘ | a pe care utilizatorul ˘
o face. Dupa o perioad ˘ | a de timp, acesta va programa automat temperaturile din imobil ˘
în funct,
ie de istoricul de temperaturi setate de utilizator. Ecobee nu prezinta aceast ˘ | a˘
funct,

ionalitate, dar ofera posibilitatea de a seta temperaturi diferite pe intervale orare ˘ diferite.

2.6. COMPARAT, IE CU SISTEMUL PREZENTAT ÎN ACEASTA LUCRARE | 10 ˘

In ceea ce prives,

te controlul prin comenzi vocale, Nest este compatibil cu un numar˘ mai mic de asistent,

i virtuali(Google Assistant si Alexa). Ecobee este compatibil s,

i cu
Siri, fapt ce reprezinta un avantaj datorit ˘ | a num ˘ | arului mai mare de potent ˘ | , iali client, i.
Tehnologia Geofencing consta în detect ˘ | ,
ia momentului în care imobilul este gol s,
| | | i
setarea unei temperaturi ce asigura un consum minim de energie. Totodat ˘ | | | a, poate detecta ˘
daca locuitorii se apropie de imobil, pentru a ies ˘ | | ,
i din modul economic s,
| | | i a asigura
temperatura setata. Geofencing este prezent la ambele termostate, îns ˘ | a la Nest este mai ˘
avansat. Poate detecta mai multe telefoane, iar în cazul în care sunt persoane care ramân ˘ în locuint,a s ˘ ,

i nu au telefonul conectat la Geofencing, prezent,a acestora este sesizata prin ˘ detectoarele de fum Nest, iar modul eco nu va fi activat. Ecobee poate conecta un singur telefon la Geofencing, ceea ce poate reprezenta un dezavantaj.
Monitorizarea consumului de energie se face automat, dar cei de la Ecobee au pus mai mult accent pe aceasta parte, iar raportul pe care termostatul îl face este mult mai ˘
detaliat. Se analizeaza datele în decursul a 18 luni s ˘ | | , i cont,
ine informat,
| | | ii legate de: consu-
mul total, influent,a vremii asupra consumului de energie s,
i compara eficient ˘ | ,a imobilului
cu celelalte din zona. Pe de alt ˘ | a parte, Nest poate înregistra doar cosumul în decursul a ˘
10 zile. Acesta trimite mail-uri în fiecare luna cu un raport ce cont ˘ | ,
| | | ine detalii de consum
de energie s,

i face comparat,

ie cu luna anterioara.˘
Monitorizarea temperaturii se face în mai multe zone din imobil prin intermediul unor senzori adit,
ionali. Cele doua termostate încearc ˘ | a s ˘ a ment ˘ | ,
ina o temperatur ˘ | a medie ˘
în locuint,a. Senzorii oferit ˘ | ,

i de Ecobee detecteaza s ˘ ,

i daca se afl ˘ | a cineva în înc ˘ | aperea ˘
respectiva.˘

2.6 Comparat,

## ie cu sistemul prezentat în aceasta lucrare ˘

În urma analizei sistemelor existente pe piat,a, se pot observa dou ˘ | a dezavantaje ma- ˘
jore. În primul rând, ment,
inerea unor temperaturi exacte în fiecare camera din imobil ˘ este destul de greu de obt,
inut. Chiar daca se pot ad ˘ | auga mai mult ˘ | ,
| | | i senzori de tem-
peratura, termostatele prezentate vor reus ˘ | ,
i sa asigure o temperatur ˘ | a medie la nivel de ˘
imobil, s,
i nu o temperatura specific ˘ | a la nivel de camer ˘ | a. De asemenea, pret ˘ | ,urile aces-
tora sunt destul de ridicate. Prin proiectul de diploma, am încercat s ˘ | a solut ˘ | ,
| | | ionez aceste
probleme. Costurile pieselor pe care le-am utilizat sunt abordabile, iar electrovalvele montate pe returul caloriferelor au rolul de a asigura ment,
| | | inerea temperaturii setate în
fiecare camera.˘

# Capitolul 3

# Fundamente teoretice

În acest capitol voi prezenta principalele concepte teoretice utilizate în realizarea
proiectului, împreuna cu limbajele de programare s ˘ | ,
i framework-urile folosite.

## 3.1 Python

Python este un limbaj de programare ce a aparut în anul 1991, fiind realizat de ˘
catre Guido van Rossum [12]. Se bucur ˘ | a de o evolut ˘ | ,
ie fulminanta, ajungând s ˘ | a fie ˘
unul din cele mai utilizate limbaje de programare în anul 2020. Cres,

terea numarului de ˘
programatori care aleg sa foloseasc ˘ | a Python, este datorat ˘ | a caracteristicilor precum [12]: ˘
- Flexibilitatea, poate fi utilizat într-un numar vast de domenii, de la progra- ˘
mare web, pâna la programare pe pl ˘ | acut ˘ ,e. Funct,

ioneaza pe o multitudine de plat- ˘
forme, printre care se enumera: Windows, Mac, Linux s ˘ | ,
i Raspberry Pi.
- În ceea ce prives,
te sintaxa acestui limbaj de programare, este una simpla,˘ care permite scrierea de programe utilizând un numar mai mic de linii de cod. ˘
- Poate fi folosit atât pentru programare procedurala, funct ˘ | ,
ionala, dar s ˘ | ,
i orientata pe obiecte. ˘

## 3.2 Flask

Este un framework construit pe baza limbajului de programare Python, ce ofera˘ posibilitatea de a dezvolta aplicat,

ii web. Faptul ca este proiectat ca s ˘ | a fie extins, ofer ˘ | a˘
posibilitatea programatorului de a avea control total asupra aplicat,

iei pe care o creeaza.˘
Prezinta un nucleu robust, care include toate funct ˘ | ,

ionalitat˘,

ile de baza pe care o aplicat ˘ | ,
ie
web le necesita, nucleu ce poate fi extins de diverse p ˘ | art ˘ ,
i tert,e [13].

11

3.3. C++ | 12

Pentru a crea aplicat,

ii web complexe, utilizarea doar a framework-ului nu este suficienta. Motiv pentru care, flask permite îmbinarea cu limbaje de programare precum ˘ javascript, CSS s,

i HTML.

## 3.3 C++

C++ este un limbaj de programare bazat pe C. Motivele pentru care creatorul acestui
limbaj de programare, Bjarne Stroustrup, a decis sa foloseasc ˘ | a limbajul C ca punct ˘
de plecare sunt: flexibilitatea si faptul ca este un limbaj apropiat de partea hardware, ˘
ruleaza pe multe platforme s ˘ | ,
i se potrives,

te cu mediul de programare UNIX [14]. Ceea ce aduce nou este posibilitatea de a programa orientat pe obiecte, o programare de tip generic s,

i face posibil conceptul de abstractizare al datelor [14]. Numarul de ˘ domenii în care C++ poate fi aplicat cres,

te considerabil datorita introducerii not ˘ | ,unii de
programare orientata pe obiecte. Aceasta implic ˘ | a modelarea unor entit ˘ | at˘,
i din lumea
reala, s ˘ ,
i interact,

iunile acestora, prin intermediul claselor.

## 3.4 Arduino IDE

Pentru programarea placut ˘ ,elor Arduino, se foloses,
| | te un mediu de dezvoltare numit
Arduino Integrated Development Environment. Acesta suporta limbajele de programare ˘ C si C++ [15].
Poate rula pe mai multe platforme precum: Windows, Linux, MAC s,

i Java [15].
De asemenea, este important de ment,
ionat faptul ca este compatibil cu o serie larg ˘ | a de ˘
modele de placut ˘ ,e, câteva exemple fiind [15]:
- Arduino Uno
- Arduino Mega
- Arduino Leonardo
- Arduino Micro
Arduino IDE îndeplines, | te atât rolul de editor de text, cât s, | i rolul de compilator.
Editorul de text reprezinta un suport pentru redactarea codului, iar compilatorul este ˘
responsabil de transformarea codului sursa în cod obiect s ˘ | ,

i încarcarea acestuia pe mi- ˘ crocontroler [15].

3.5. COMPONENTE UTILIZATE | 13

## 3.5 Componente utilizate

### 3.5.1 ESP8266

NodeMCU ESP8266 este o placa ce se poate conecta prin WiFi la o ret ˘ | ,ea de internet.
Prezinta o anten ˘ | a esp8266 ce accept ˘ | a standardele 802.11b/g/n s ˘ | ,
i protocolul de securitate
WPA/WPA2 [16]. Integreaza un modul ADC pe 10 bit ˘ | ,
| | | i, microcontroler pe 32 de bit,

i,
ce are un consum redus de energie, s,

i se bazeaza pe protocolul TCP/IP pentru a face ˘ transferul de date [16].

3.5.2 Placa de baz ˘ | a pentru NodeMCU ˘

Are rolul de a alimenta modulul wireless ESP8266 s,
| | | i de a oferi o extensie pentru
pinii pe care acesta îi pune la dispozit,

ie. In ceea ce prives,

| | | te alimentarea, se face printr-
un conector de tip jack s,
i accepta valori între 6 s ˘ | ,
i 24 de volt,
i. De asemenea, placa de
baza integreaz ˘ | a un regulator de tensiune ce convertes ˘ | ,
| | | te valoarea tensiunii de intrare la 5
volt,

i.

### 3.5.3 Arduino Uno

Arduino aduce pe piat,a o serie de pl ˘ | acut ˘ ,e cu microcontroler, ce pot fi programate
pentru diverse aplicat,

ii. De asemenea, bibliotecile puse la dispozit,

ie pentru acest tip de
sisteme sunt menite sa faciliteze procesul de programare al acestora [17]. ˘
Programarea placut ˘ ,ei se face prin intermediul conectorului USB. Aceasta prezinta˘ s,
i un conector separat pentru alimentare care suporta tensiuni în intervalul 7 - 12 volt ˘ | ,
i
[17], tensiuni ce vor trece prin regulatorul de tensiune integrat în placut ˘ ,a.˘
În ceea ce prives,
| | te pinii prezent,
i pe placa Arduino Uno, exista 6 intr ˘ | ari analogice ˘
[17], 14 terminale care pot fi configurate fie ca intrari, fie ca ies ˘ | ,
iri [17] s,

i o serie de pini
ce furnizeaza tensiune, 3.3 sau 5 volt ˘ | | ,
i.

### 3.5.4 LCD 1602

Ofera posibilitatea de a afis ˘ | , a text pe doua rânduri, fiecare rând cont ˘ | ,
inând 16 caractere. Transferul de date se face prin protocolul I
| | | 2C, fapt ce reduce considerabil numarul ˘
de pini necesari pentru a conecta LCD-ul la Arduino [18].

Printre caracteristici se remarca [18]: ˘

- Tensiune de alimentare: 5 volt,
i
- Luminozitatea ecranului se poate regla printr-un potent,

iometru integrat

3.5. COMPONENTE UTILIZATE | 14

### 3.5.5 Senzor DHT11

Prezinta dou ˘ a p ˘ art ˘ ,

i componente. Prima componenta are rolul de a citi umiditatea ˘
ambientala. Este alcatuit ˘ | a din doi electrozi care se suprapun peste un substrat. În mo- ˘
mentul în care umiditatea substratului se modifica, determin ˘ | a o modificare a rezistent ˘ | ,ei
dintre cei doi electrozi, iar microcontrolerul detecteaza s ˘ ,
i interpreteaza aceast ˘ | a valoare. ˘
Componenta termica este format ˘ | a dintr-un termistor. Termistorul este un rezistor a c ˘ | arui ˘
rezistent,a este invers proport,
ionala cu variat ˘ | ,
ia temperaturii. Pe baza valorii rezistent,ei
date de termistor, se vor face prelucrari ajungându-se la o valoare valid ˘ | a a temperaturii. ˘

### 3.5.6 Modul radio frecvent,a˘

Pereche formata dintr-un transmit ˘ | ,ator s ˘ | ,
i receptor. Construite pentru a facilita trans-
ferul de date prin radio-frecvent,a. Acestea funct ˘ | ,
ioneaza la o frecvent ˘ | ,a de 433Mhz [19], ˘
iar distant,a de transmisie difera în funct ˘ | ,
ie de tensiunea de alimentare a transmit,atorului ˘ s,

i de calitatea antenelor.
Conform [19], se pot evident,

ia urmatoarele caracteristici: ˘

- Distant,a de transfer: 20 - 200 metri
- Tensiune de alimentare transmit,ator: 3.5 - 12 volt ˘ | ,
i
- Rata de transfer: 4 KB/S ˘
- Tensiune de alimentare a receptorului: 5 volt,
i

### 3.5.7 Releu

Funct,

ioneaza ca un întrerup ˘ | ator într-un circuit electric. Principiul de baz ˘ | a al unui ˘
releu consta în al ˘ | aturarea unui solenoid s ˘ | ,

i a unor contacte metalice. În momentul în care solenoidul este alimentat, acesta produce un câmp electromagnetic ce va act,

iona
contactele metalice, deschizând sau închizând circuitul. Releele pe care le utilizez funct,
ioneaza la 5 volt ˘ | ,
i s,
i au o structura put ˘ | ,
in mai complexa, structur ˘ | a pe care intent ˘ | ,
ionez
sa o detaliez. Prezint ˘ | a trei intr ˘ | ari: VCC, GND s ˘ | ,
i IN, unde pinii de VCC si GND sunt alimentat,

i permanent, iar IN este pinul de semnal. Acesta este legat la baza unui tranzistor, iar în funct,

ie de tensiunea pe care o furnizeaza, tranzistorul trece în regim saturat ˘ sau blocat, funct,

ionând ca un întrerupator pentru solenoid. De asemenea, în paralel cu ˘
bobina este montata o diod ˘ | a ce are ca s ˘ | ,
| | | i scop protejarea tranzistorului de s,ocurile de
tensiune ce pot aparea la deconectarea aliment ˘ | arii bobinei. Este necesar ˘ | a utilizarea re- ˘
leului pentru a putea controla, prin semnale de putere mica, dispozitive ce funct ˘ | ,

ioneaza˘
la tensiuni s,

i curent,

| i mari.

3.5. COMPONENTE UTILIZATE | 15

### 3.5.8 Electrovalva˘

Este un mecanism ce are ca rol deschiderea circuitului de apa în momentul în care ˘
este conectat la o sursa de tensiune. Acesta este format dintr-un solenoid s ˘ | ,
i un obturator.
Electrovalvele pe care le folosesc sunt de tip normal închis, ceea ce înseamna c ˘ a atunci ˘
când solenoidul nu este alimentat, obturatorul sta în pozit ˘ | ,

ie închis, iar circuitul de apa˘
prin electrovalva este blocat. În momentul aliment ˘ | arii solenoidului, câmpul magnetic ˘
produs de acesta va act,
iona obturatorul, facând posibil ˘ | a trecerea apei prin electrovalv ˘ | a.˘
3.5.9 Pompa de ap ˘ | a˘
Este alcatuit ˘ | a dintr-un motor electric ce funct ˘ | ,
ioneaza la 12 volt ˘ | ,
i, curent continuu s,

i
act,
ioneaza o palet ˘ | a ce pune în mis ˘ | , care apa din circuit.

### 3.5.10 Push buton

Este un intrerupator, f ˘ | ar˘ a ret ˘ | ,

inere, ce are rolul de a trimite semnale catre micro- ˘ controler. Prezinta dou ˘ a contacte metalice care închid circuitul în momentul în care se ˘ ating.

### 3.5.11 Condensator

Este o componenta electric ˘ | a pasiv ˘ | a ce are rolul de a înmagazina tensiune. Acesta se ˘
utilizeaza în circuitele electrice pentru a reduce fluctuat ˘ | ,

iile de tensiune ce pot aparea. ˘

### 3.5.12 Rezistent,a˘

Asemenea condensatorului, rezistent,a se încadreaza în categoria componentelor elec- ˘ trice pasive. Aceasta are rolul de a se opune trecerii curentului electric.

### 3.5.13 Circuit integrat Schmitt-Trigger

Acesta este utilizat pentru a transforma un semnal analog într-un semnal digital, dar prezinta s ˘ ,

i rolul de inversor. Daca se aplic ˘ | a la intrare un semnal cu nivel logic 1, la ˘
ies,

irea din circuitul integrat va avea nivelul logic 0.

### 3.5.14 Dioda˘

Limiteaza trecerea curentului electric într-un singur sens, de la anod la catod. Pre- ˘
zinta multe utili ˘ | at˘,
i în circuitele electrice, un exemplu practic fiind conversia curentului alternativ în curent continuu.

3.6. FILTRAREA SEMNALELOR | | 16

## 3.6 Filtrarea semnalelor

Butoanele pe care le-am folosit, pentru setarea temperaturii dorite, sunt formate din contacte metalice. În momentul în care acestea se ating, produc o vibrat,
| | ie pe care mi-
crocontrolerul o percepe ca o apasare multipl ˘ | a a butonului. Pentru a rezolva aceast ˘ | a˘
problema este necesar ˘ | a crearea unor filtre trece jos [20] pentru fiecare buton în parte. ˘
Rolul acestor filtre este de a permite trecerea semnalelor cu frecvent,a mic ˘ | a si de a opri ˘
semnalele cu frecvent,e mari. Pentru aceasta, am utilizat circuite RC serie, iar valorile rezistent,ei si condesatorului au fost calculate utilizând ecuat,

ia de încarcare s ˘ ,

i de descar- ˘
care a condensatorului. De asemenea, pentru a obt,

ine o filtrare cât mai buna, am utilizat ˘
un circuit integrat Schmitt-Trigger. Caracteristica datorita c ˘ areia acesta îmbun ˘ | at˘ at˘,es,
| | te
filtrarea semnalului este histereza pe care o are între pragul superior, declans, eaza trece- ˘ rea pe nivel logic 0, s,

i pragul inferior, declans, eaza trecerea pe nivel logic 1. ˘

Conform [20], ecuat,

ia de încarcare a condensatorului este: ˘

Vcap = Vin(1−e

−t
RC ) | (3.1)

Conform [20], ecuat,

ia de descarcare a condensatorului este: ˘

Vcap = Vin(e

−t
RC ) | (3.2)

Vcap - tensiunea stocata în condensator la momentul t ˘

Vin - tensiune de alimentare a circuitului

t - timpul masurat din momentul aplic ˘ | arii tensiunii de alimentare la bornele circuitului, ˘
în cazul ecuat,
iei de încarcare a condensatorului. Pentru ecuat ˘ | ,

ia de descarcare a conden- ˘
satorului, reprezinta timpul m ˘ | asurat din momentul întreruperii aliment ˘ | arii circuitului ˘

R - valoarea în ohmi a rezistent,ei utilizate

C - valoarea în farazi a condensatorului utilizat

În continuare, pentru a putea aplica formulele, este necesara aflarea timpului cât du- ˘
reaza oscilat ˘ | ,
ia semnalului. Pentru aceasta, am utilizat un osciloscop ce permite analiza semnalului provenit de la buton.

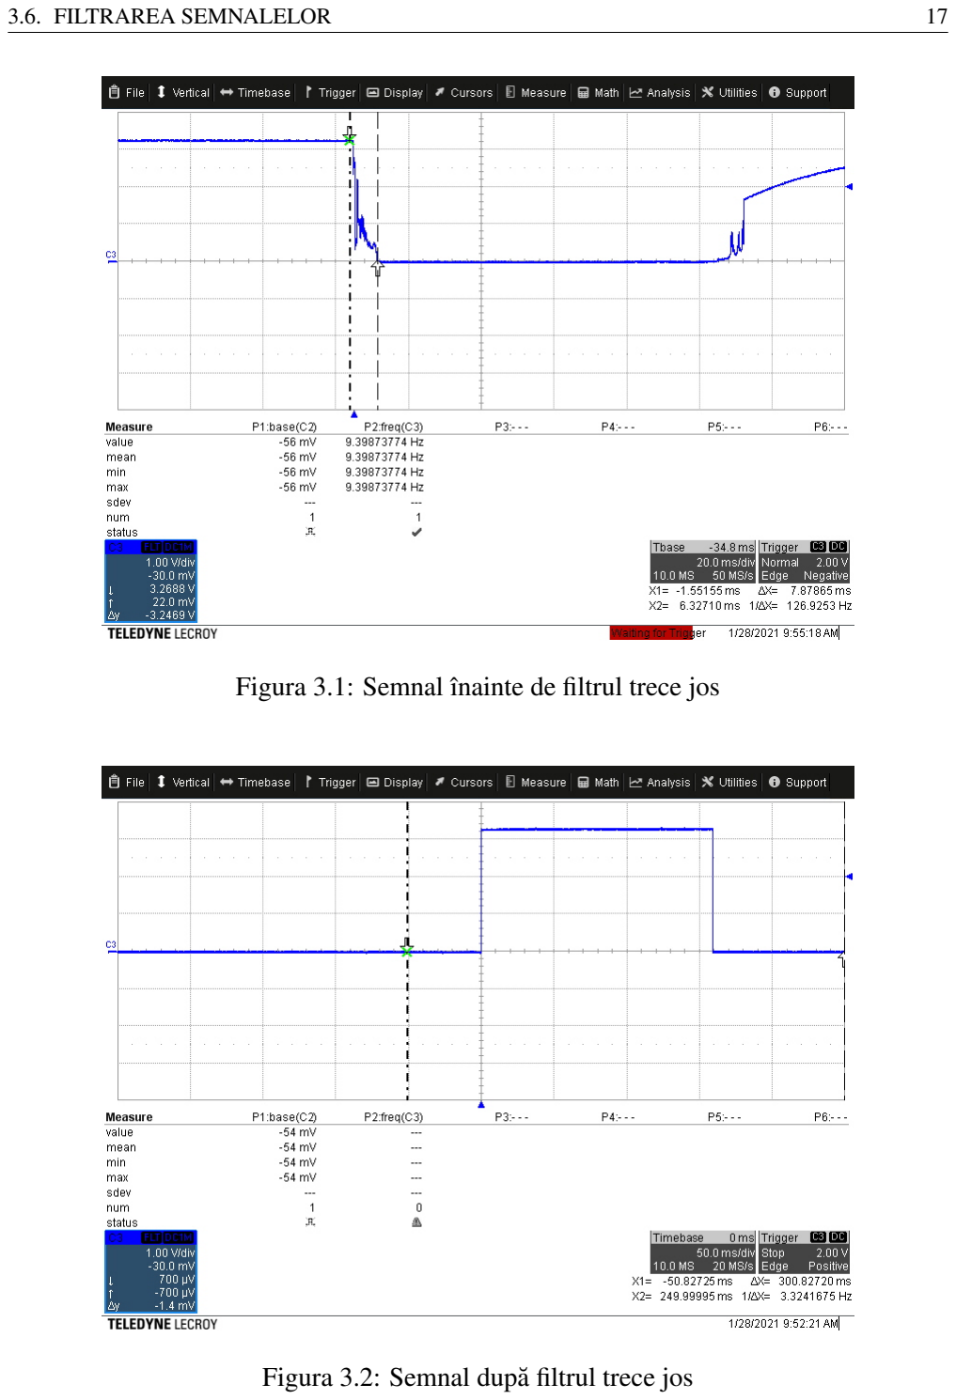
[picture p40: page 19]

3.6. FILTRAREA SEMNALELOR | 17

Figura 3.1: Semnal înainte de filtrul trece jos

Figura 3.2: Semnal dupa filtrul trece jos ˘

3.6. FILTRAREA SEMNALELOR | 18

În urma analizei mai multor semnale de la push buton, cea mai mare perturbat, ie a
durat aproximativ 8 ms. În calculul valorii rezistent,elor si condensatorului care trebuie folosite în filtrele trece jos, voi folosi un timp de 10 ms. Cele 2 ms în plus reprezinta o ˘
marja de sigurant ˘ | ,a pentru situat ˘ | ,
iile în care apar perturbat, ii mai mari decât cele masurate. ˘

În cele ce urmeaza, voi prezenta schema filtrului trece jos, iar pe baza acesteia voi ˘ detalia calculele realizate pentru a determina valorile componentelor electrice utilizate.

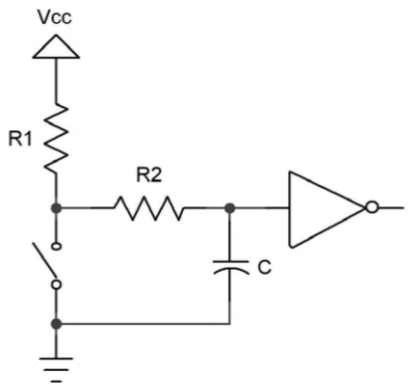
[picture p41: figure]

Figura 3.3: Schema filtru trece-jos (sursa: [20]) ˘

În momentul în care întrerupatorul se închide, condensatorul începe s ˘ | a se descarce ˘
prin intermediul rezistent,ei R2. Cunoscând acest aspect, voi putea calcula valoarea R2 utilizând ecuat,
ia de descarcare a condensatorului. Valoarea lui t va fi de 10 ms, ˘ | Vin este
echivalent cu 3.3 volt,

i(tensiunea la care funct,

ioneaza modulul WiFi), ˘ | Vcap este egal cu
valoarea pragului inferior al inversorului Schmitt-Trigger, iar valoarea condensatorului
o aleg de 1 µF. Mai exact, se calculeaza rezistent ˘ | ,a astfel încât, dupa t = 10 ms de la ˘
începerea descarc ˘ arii, tensiunea stocat ˘ | a în condensator s ˘ | a ajung ˘ | a la valoarea de prag a ˘
circuitului integrat.

R2 =

−t

Cln(

Vcap

Vin

)

=

−10 · 10⁻³
10⁻⁶
ln(

1
3.3

)

=

−10
ln(0.3)
- 10³ =

−10
−1.2
- 10³ = 8.33 · 10³ = 8.33KΩ
Când se deschide întrerupatorul, condensatorul începe s ˘ | a se încarce prin intermediul ˘
rezistent,elor R1 s,
i R2. Pornind de la aceasta informat ˘ | ,

ie, voi calcula valoarea R1 + R2 utilizând ecuat,

ia de încarcare a condensatorului. Doar valoarea parametrului ˘ | Vcap se
modifica, va fi echivalent ˘ | a cu pragul superior al inversorului. ˘

3.7. HISTEREZA | 19

R1+R2 =

−t

Cln(1−

Vcap

Vin

)

=

−10 · 10⁻³

10⁻⁶
ln(1−

1.5
3.3

)

=

−10
ln(0.54)

·10³ =

−10
−0.61

·10³ = 16.39·10³

= 16.39KΩ

R1 +R2 = 16.39KΩ,R2 = 8.33KΩ ⇒ R1 = 8.06KΩ

## 3.7 Histereza

Pentru a evita crearea unui lant, de porniri si opriri repetate, pe perioade scurte de timp, cauzate de fluctuat,

iile rapide de temperatura, este necesar ˘ | a implementarea con- ˘
ceptului de histereza. Acesta const ˘ | a în stabilirea unei valori de tolerant ˘ | ,a la temperatura ˘
setata, astfel încât diferent ˘ | ,a de temperatura din momentul în care se trimite comand ˘ | a˘
pentru oprirea sistemului de încalzire, pân ˘ | a la urm ˘ | atoarea pornire a acestuia, s ˘ | a fie egal ˘ | a˘
cu dublul valorii histerezei. Cu alte cuvinte, comanda de pornire a încalzirii se va da
când temperatura în camera ajunge s ˘ | a fie mai mic ˘ | a sau egal ˘ | a cu valoare temperaturii ˘
setate, din care se sustrage valoarea histerezei, iar comanda de oprire va fi declans, ata˘
când temperatura ambientala este mai mare sau egal ˘ | a cu valoarea temperaturii setate, la ˘
care se adauga valoare histerezei. În acest fel, timpul între comenzi este mai mare s ˘ | ,
| | | | i nu-
marul de cicluri pornit/oprit este mai mic, m ˘ | asur ˘ | a ce este menit ˘ | a s ˘ a protejeze sistemele ˘
de încalzire. ˘

# Capitolul 4

# Dezvoltarea solut

,

# iei

Acest capitol cont,

ine o prezentarea detaliata a modului în care a fost implementat ˘ proiectul. Voi face referiri atât la partea hardware, cât s,

i la partea software.

## 4.1 Specificarea cerint,elor

Redactarea cerint,elor sistemului reprezinta o etap ˘ | a esent ˘ | ,
iala în crearea oric ˘ | arui pro- ˘
iect. Acestea dicteaza comportamentul produsului final, fiind necesare atât în faza de ˘ dezvoltare, cât s,

i în cea de testare. Cu ajutorul diagramelor cazurilor de utilizare, voi detalia cerint,ele sistemului descris în aceasta lucrare. ˘

20

4.1. SPECIFICAREA CERINT, ELOR | 21

4.1.1 Cerint,ele funct,

ionale ale aplicat,

### iei web


Figura 4.1: Cazurile de utilizare pentru aplicat,

ia web

Prima cerint,a pe care aplicat ˘ | ,
ia trebuie sa o îndeplineasc ˘ | a este de a permite utiliza- ˘
torilor sa se autentifice cu ajutorul credent ˘ | ,
ialelor, indiferent de rolul utilizatorului. De asemenea, trebuie tratate situat,

iile în care parola este gres,

ita sau contul nu exist ˘ | a în baza ˘
de date.
Prin intermediul aplicat,

iei web, orice utilizator trebuie sa poat ˘ a monitoriza valoarea ˘ temperaturii s,

i umiditat˘,
ii din imobil.
Setarea temperaturii trebuie sa fie posibil ˘ | a prin intermediul aplicat ˘ | ,

iei web, iar aceasta˘
act,

iune nu depinde de rolul utilizatorului.

4.1. SPECIFICAREA CERINT, ELOR | | | | | 22
O cerint,a esent ˘ | ,
iala a sistemului este de a oferi posibilitatea setarii, de la distant ˘ | ,a, a ˘
unui program de funct,
ionare. Aceasta funct ˘ | ,
ionalitate trebuie sa fie accesibil ˘ | a atât pentru ˘
conturile cu drepturi de administrator, cât s, i pentru cele far˘ a. Este necesar ca datele in- ˘
troduse de utilizator sa fie verificate s ˘ | ,
i semnalate cazurile în care valorile temperaturilor nu sunt valide sau intervalele nu sunt setate în ordine cronologica.˘ Pentru a putea gestiona accesul la aplicat,
ie, aceasta trebuie sa permit ˘ | a administra- ˘
torilor sa creeze, s ˘ | a s ˘ ,
tearga conturi pentru alte persoane s ˘ | | | , i sa modifice drepturile de ˘
acces ale tuturor conturilor salvate în baza de date. Prin urmare, apare nevoia de noi funct,

ionalitat˘,
i, precum: creare cont, s, tergere cont s,

i modificare drepturi de acces. La
crearea unui cont, se va verifica daca parola introdus ˘ | a este una sigur ˘ | a. Validarea se face ˘
pe baza a trei criterii: parola trebuie sa cont ˘ | ,
ina cel put ˘ | ,
in 6 caractere, cel put,
| | | | | in o litera˘
mare s,

i cel put,

in o cifra. În cazul în care nu se respect ˘ | a condit ˘ | ,
iile, utilizatorul trebuie sa˘ fie avertizat, iar contul nu va fi creat. Cele 3 cerint,e ment,

ionate mai sus duc la aparit,

ia unei noi cerint,e. Pentru a facilita stergerea conturilor s,

i modificarea drepturilor de acces, aplicat,

| | | | ia web trebuie sa pun ˘ | a˘
la dispozit,
ie o pagina care s ˘ | a afis ˘ | , eze toate conturile existente în baza de date. Aceasta
trebuie sa fie accesibil ˘ | a doar administratorilor. ˘
De asemenea, din motive de securitate, trebuie ca fiecare utilizator sa poat ˘ | a s ˘ a is ˘ ,
i
modifice parola. Acest caz de utilizare implica mai multe valid ˘ | ari. Este necesar s ˘ | a˘
se verifice daca parola actual ˘ | a introdus ˘ | a este cea corect ˘ | a. Dup ˘ | a aceea, identic cazului ˘
de utilizare modificare parola, se verific ˘ | a dac ˘ | a noua parol ˘ | a introdus ˘ | a este una sigur ˘ | a.˘
În cele din urma, trebuie verificat dac ˘ | a parola noua s ˘ | ,
i confirmarea acesteia coincid. Nerespectarea condit,

iilor duce la afis, area unui mesaj de eroare s,

| | | | i la nefinalizarea act, | iunii
de schimbare a parolei.
Dupa finalizarea act ˘ | ,
iunilor dorite, utilizatorii trebuie sa se poat ˘ | a deconecta de la ˘
aplicat,

ie.

4.1.2 Cerint,e nefunct,

ionale ale aplicat,

### iei web

În continuare, voi enumera cerint,ele legate de securitate:

- Permisiunile de acces pot fi modificate doar de administratori.
- Toate parolele trebuie sa fie criptate. ˘
- Parolele trebuie sa fie complexe. ˘

De asemenea, pe partea de performant,a:˘

- Aplicat,
ia web trebuie sa poat ˘ | a monitoriza parametrii ambientali s ˘ | ,
| | | | | i seta tem-
peratura într-un imobil cu doua camere. ˘

4.1. SPECIFICAREA CERINT, ELOR | 23
- Valorile afis, ate pe pagina principala trebuie actualizate doar în momentul în ˘
care acestea se modifica în baza de date. Nu se accept ˘ | a ca actualiz ˘ | arile s ˘ | a se ˘
execute la anumite intervale de timp prestabilite.

4.1.3 Cerint,e funct,

### ionale pentru componentele electronice

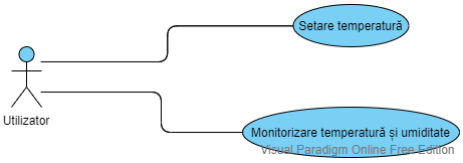
[picture p42: figure]

Figura 4.2: Cazurile de utilizare pentru ansamblul de componente electronice

Ansamblul componentelor electronice trebuie sa permita modificarea temperaturii ˘
setate. Pentru aceasta, se utilizeaza butoane, iar modific ˘ | arile de temperatur ˘ | a se afis ˘ | , eaza˘
pe LCD.
Pentru a face posibila monitorizarea parametrilor ambientali, modulele WiFi trebuie ˘
sa afis ˘ | , eze pe LCD valorile citite de senzorul de temperatura s ˘ ,
| i umiditate.
Daca nu exist ˘ | a o conexiune la internet în momentul în care sistemul este pornit, este ˘
necesar sa se considere valoarea prestabilit ˘ | a de 21 °C ca fiind temperatura ce trebuie ˘
ment,
inuta în imobil. În cazul întreruperii conexiunii la internet în timpul funct ˘ | | , | ionarii, ˘
trebuie ca ultima valoare a temperaturii dorite, citita din baza de date, s ˘ | a r ˘ amân ˘ | a salvat ˘ | a˘
în sistem.

4.1.4 Cerint,e nefunct,

### ionale pentru componentele electronice

O serie de cerint,e arhitecturale ale sistemului sunt:

- Sistemul trebuie sa ruleze într-un regim continuu, zi s ˘ | , i noapte.
- Pentru a facilita montajul sistemului, trebuie ca transferul comenzilor între modulele senzor s,
i modulul de control sa se fac ˘ | a prin radio-frecvent ˘ | ,a.˘
- Distant,a maxima de transfer între modulele senzor s ˘ | ,
i modulul de control
trebuie sa fie de 200 de metri, în spat ˘ | ,
iu deschis.

Pe partea de sigurant,a, este necesar ca: ˘

4.2. ARHITECTURA SISTEMULUI | | | 24
- Centrala termica s ˘ a fie oprit ˘ | a dac ˘ | a transferul de date intre modulele senzor s ˘ | ,
i
modulul de control este întrerupt mai mult de 5 secunde.

În ceea ce prives,
te fiabilitate:
- Sistemul trebuie sa poat ˘ | a funct ˘ | ,
| | iona s, | i în cazul întreruperii conexiunii la in-
ternet.
- Pentru a evita situat,
iile în care o comanda nu este recept ˘ | ,

ionata, transferul ˘
datelor între modulele senzor s,

i modulul de control trebuie sa se fac ˘ a ciclic. ˘

## 4.2 Arhitectura sistemului


Figura 4.3: Arhitectura sistemului

Sistemul a fost conceput pentru un apartament cu doua camere, îns ˘ | a poate fi extins ˘
pentru un numar mai mare de înc ˘ | aperi. La nivel macro, este format din trei module, câte ˘
un modul senzor pentru fiecare camera s ˘ ,
i un modul de control, montat în apropierea centralei termice.
Modulul senzor prezinta o complexitate mai mare, este alc ˘ | atuit din mai multe com- ˘
ponente s,

i îndeplines,

te o serie de funct,

ionalitat˘,
i. Preia informat,

ii precum: temperatura

4.2. ARHITECTURA SISTEMULUI | 25

s,

i umiditatea s,

i le trimite în baza de date. În continuare, aceste valori sunt afis, ate utilizând aplicat,

ia web, facând posibil ˘ | a monitorizarea parametrilor ambientali. De ase- ˘
menea, are acces la temperatura setata, iar in funct ˘ | ,
ie de aceasta, dar s,

i de temperatura
curenta din camer ˘ | a, controleaz ˘ | a electrovalva s ˘ | ,

i trimite comanda de oprire sau pornire ˘ a centralei. Un alt rol esent,

ial pe care îl îndeplines, te modulul este de a face posibila˘
setarea unei valori a temperaturii ce urmeaza s ˘ a fie ment ˘ | ,
inuta în camer ˘ | a.˘
Modulul de control este de o complexitate redusa. Primes ˘ | ,
te comenzi de la modulele
senzor, le interpreteaza, iar pe baza acestora controleaz ˘ | a centrala. Modulul se foloses ˘ | ,
te
de logica de tip "SAU", dac ˘ | a cel put ˘ | ,

in un modul senzor trimite comanda de pornire, ˘
atunci centrala termica trebuie s ˘ | a înceap ˘ | a ciclul de înc ˘ | alzire. ˘
Transferul de date între modulele senzor s,

i modulul de control se face prin intermediul undelor radio, 433 MHz. Placut,ele ESP8266 se folosesc de unde Wi-Fi, 2.4 GHz, pentru a se conecta la router.

### 4.2.1 Modulul senzor

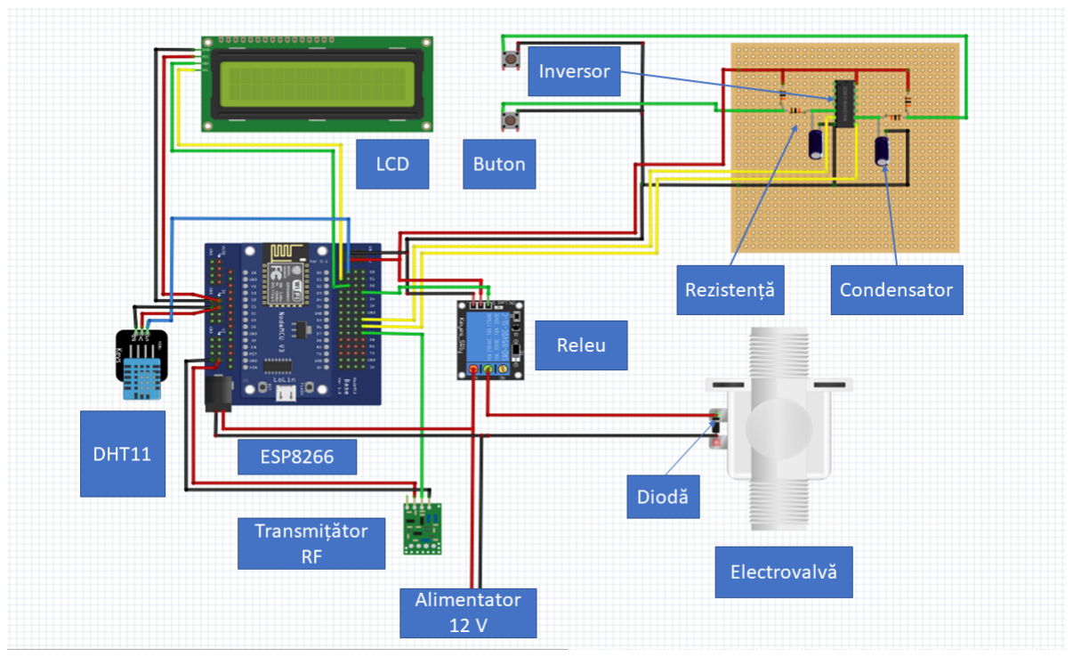
[picture p43: figure]

Figura 4.4: Arhitectura modulului senzor

Este format din urmatoarele componente: ˘

- Modul WiFi NodeMCU
- Placa de baz ˘ | a pentru NodeMCU ˘
- LCD

4.2. ARHITECTURA SISTEMULUI | 26
- Senzor de temperatura s ˘ , i umiditate
- Releu
- Butoane
- Transmit,ator RF ˘
- Electrovalva˘
- Circuit integrat Schmitt-Trigger
- Rezistent,a˘
- Condensator
- Alimentator 12 volt,

i

Componenta principala din acest ansamblu este modulul wireless. Se conecteaz ˘ | a˘
prin WiFi la un punct de acces al ret,elei, router-ul în cazul proiectului prezentat, s,

i face
transfer de date cu baza de date utilizata. Acesta pune la dispozit ˘ | ,
ie o serie de pini pentru
a putea conecta diverse componente auxiliare.
Pinul D0 este utilizat pentru a conecta pinul de date de la senzorul de temperatura s ˘ , i
umiditate.
Pinii D1 s,
i D2 se conecteaza la pinii SCL s ˘ | ,
i SDA pentru a face posibil transferul de date prin protocolul de comunicat,

ie I

2C.
Pinul D3 se conecteaza la pinul IN al releului s ˘ | ,
i are rolul de a controla închiderea sau deschiderea releului, iar pinii D5 s,
i D6 sunt rezervat,
i pentru butoane.
Pinul D7 transfera date la pinul de date al transmit ˘ | ,atorului RF. ˘
Placa de baza pentru modulul WiFi are dou ˘ | a roluri esent ˘ | ,
iale în crearea circuitului.
Acesta faciliteaza felul în care se poate alimenta pl ˘ | | acut ˘ ,a wireless, punând la dispozit,
ie
un conector de alimentare care este compatibil cu alimentatoare ce furnizeaza tensiuni ˘ între 6 s,
i 24 de volt,
i. Prin intermediul unui regulator de tensiune, va aduce tensiunea
de alimentare a modulului WiFi pâna la 5 volt ˘ | ,
i, prevenind orice posibilitate de supra-
alimentare. Astfel, placa de baza pune la dispozit ˘ | ,
ie pini ce ofera tensiuni de ies ˘ | ,
ire de
3.3 volti, 5 volt,
i s, | i o serie de pini ce sunt conectat, | i direct la conectorul de alimentare s,

i
furnizeaza voltaj egal cu cel dat de alimentator. De asemenea, ofer ˘ | a pentru fiecare pin al ˘
modulului ESP8266 înca 4 pini corespondent ˘ | ,

i, fapt ce reprezinta un avantaj când vine ˘ vorba de conectarea unor componente auxiliare.

Pentru a putea afis, a temperatura curenta din camer ˘ | a s˘ ,
i temperatura setata, se foloses ˘ | ,
te
un display. Transferul de date între LCD s,

i modulul WiFi, la care este conectat, se face prin intermediul protocolului de comunicat,

ie I

2C. S-a ales acest protocol deoarece re-
duce considerabil numarul de fire necesare pentru conectarea s ˘ | ,
i alimentarea LCD-ului,
în acest caz fiind necesare doar 4. Prin urmare, display-ul pune la dispozit,

ie urmatorii ˘
pini: VCC, GND, SDA s,

i SCL.

4.2. ARHITECTURA SISTEMULUI | 27

Senzorul de temperatura s ˘ ,

i umiditate pe care îl utilizez prezinta 3 pini. Doi sunt ˘ utilizati pentru alimentare, VCC s,

i GND, iar cel de-al treilea este pinul de date, utilizat pentru transferul de informat,

ii între senzor s,

i placut ˘ ,a cu microcontroler la care este conectat.

Releul este conectat la modulul wireless s,

i este controlat de acesta prin pinul IN.
Rolul releului este de întrerupator în circuitul electric format din electrovalv ˘ | a s ˘ ,
i alimentator.

Sunt prezente doua butoane ce permit modificarea temperaturii setate. Butonul de ˘
sus incrementeaza temperatura s ˘ | ,

i se conecteaza la pinul D5 al modului WiFi, iar butonul ˘
de jos decrementeaza valoarea temperaturii s ˘ | ,

i se conecteaza la pinul D6. ˘

Transmit,atorul RF prezint ˘ | a 3 pini: VCC, GND s ˘ | ,
i DATA. Pinii VCC s,

i GND se
conecteaza la o surs ˘ | a de tensiune, ies ˘ | , irile de 12 volt, i oferite de placa de baza NodeMCU. ˘
Pinul de date se conecteaza la pinul digital D7 al modulului wireless s ˘ | ,
i face posibil
transferul de date între acestea. În continuare, datele vor fi transferate la receptorul de tip RF, montat pe modulul de control.
Electrovlava se monteaza pe returul caloriferelor s ˘ | ,

i este responsabila de închiderea ˘ sau deschiderea circuitului de apa din calorifer. Releul este cel care întrerupe, sau nu, ˘ alimentarea electrica a electrovalvei. ˘

Circuitul integrat Schmitt-Trigger, rezistent,a s,

| | i condensatorul sunt componente elec-
trice pe care le-am utilizat pentru a filtra semnalul provenit de la buton.

4.3. PROIECTARE DETALIATA | 28 ˘

### 4.2.2 Modulul de control

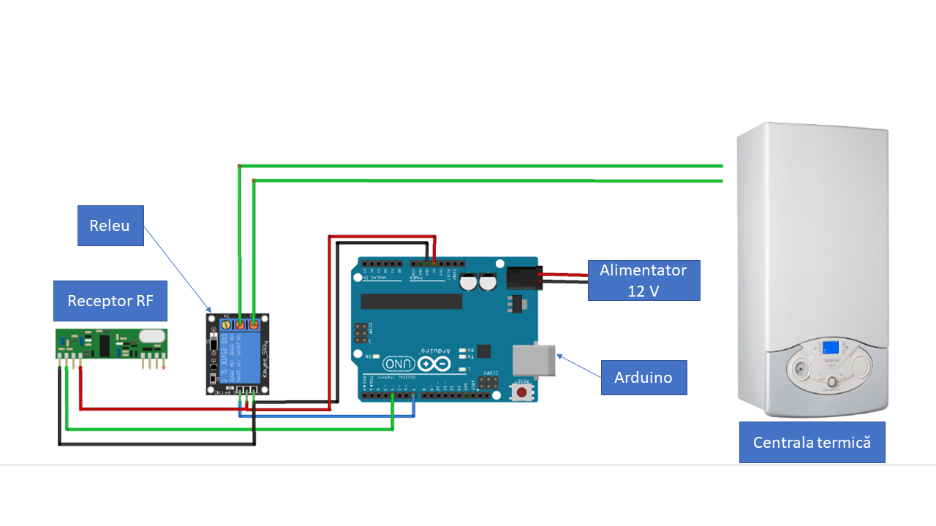
[picture p44: figure]

Figura 4.5: Arhitectura modulului de control

Acesta nu prezinta conexiune la internet. Modulul wireless este înlocuit cu o pl ˘ | acut ˘ ,a˘
Arduino Uno, care se ocupa de partea de procesare a datelor primite de la modulele din ˘
camere. Prezinta o serie de intr ˘ | ari s ˘ ,
i ies,

iri analogice, dar si digitale.
Pinul digital 4 se conecteaza la pinul de date al receptorului, f ˘ | acând posibil transferul ˘
de informat,

ii între acestea.
Pinul digital 7 se conecteaza la pinul IN al releului s ˘ | ,
i transmite comanda de închidere sau deschidere a acestuia.
Releul se alimenteaza la o tensiune de 5 volt ˘ | ,

i, tensiune provenita de la Arduino. În ˘ momentul în care releul este pe pozit,

ie închis, centrala termica va porni. ˘

Receptorul, asemenea releului, se alimenteaza cu 5 volti de la pl ˘ | acut ˘ ,a Arduino s,
i are
rolul de a prelua datele de la transmit,atoarele din camere. ˘

## 4.3 Proiectare detaliata˘

Prin intermediul diagramelor UML voi detalia anumite aspecte ce t,

in de proiectarea sistemului. De asemenea, voi prezenta structura aplicat,

iei s,

i codului aferent part ˘ , ii
electronice.

4.3. PROIECTARE DETALIATA | 29 ˘

### 4.3.1 Diagrama de clase ˘

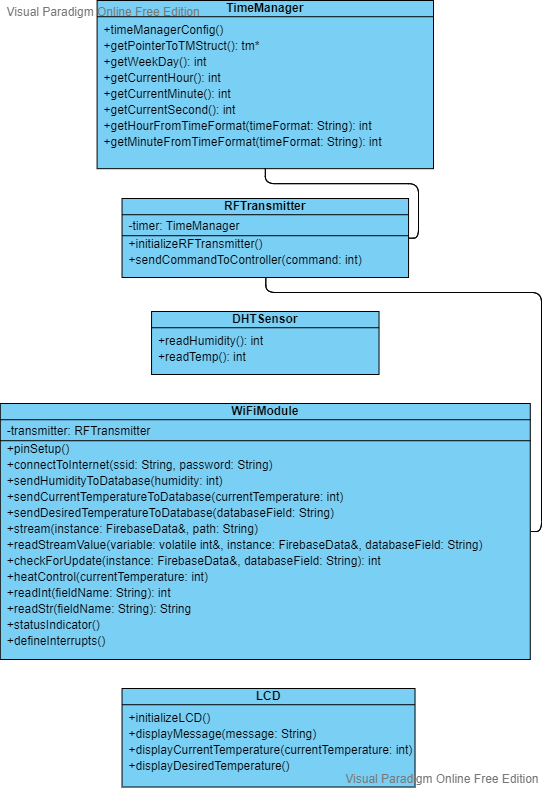
[picture p45: figure]

Figura 4.6: Diagrama de clase ˘

Pentru fiecare componenta electronic ˘ | a, ce prezint ˘ | a funct ˘ | ,

ionalitat˘,
i mai complexe, am
creat câte o clasa diferit ˘ | a. Acestea cont ˘ | ,
in metode ce implementeaza funct ˘ | ,
iile pe care
componenta trebuie sa le îndeplineasc ˘ | a. Cea mai complex ˘ | a clas ˘ | a este cea aferent ˘ | a mo- ˘
dulului WiFi, deoarece acesta îndeplines,

te un rol esent,

ial în cadrul sistemului.
Metoda heatControl, din clasa WiFiModule, prezinta o instant ˘ | ,a a clasei ˘ | RFTrans-
mitter pentru a putea apela sendCommandToController. De asemenea, pentru a evita
conflictele de date ce pot aparea la transferul comenzilor prin radio-frecvent ˘ | ,a, metoda ˘
sendCommandToController va apela getCurrentSecond din cadrul clasei TimeManager.

4.3. PROIECTARE DETALIATA | 30 ˘

### 4.3.2 Diagrame de secvent,a˘

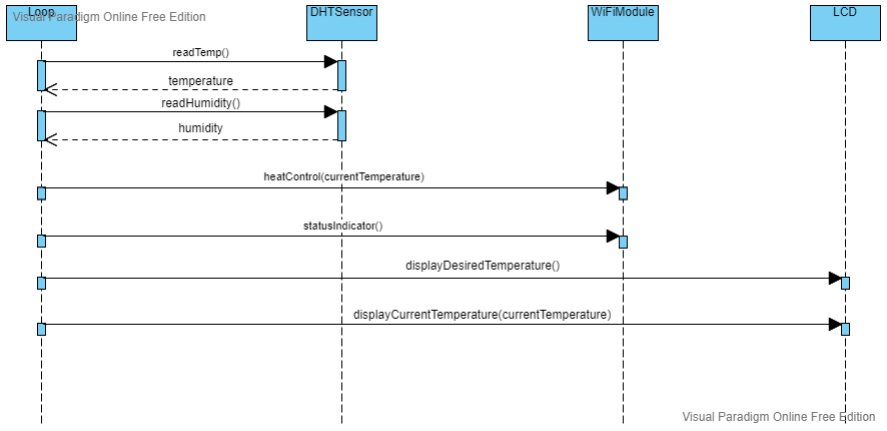
[picture p46: figure]

Figura 4.7: Mod de operare far˘ a conexiune la internet ˘

Sistemul trebuie sa poat ˘ | a funct ˘ | ,
iona s,

i în cazul în care are loc o întrerupere la cone-
xiunea de internet. Electronica este proiectata în as ˘ | , a fel încât sa poat ˘ | a prelua funct ˘ | ,

ionalitat˘,
ile
de baza ale aplicat ˘ | ,
iei, si anume: monitorizarea s,

i setarea temperaturii.
Pentru a obt,

ine acest comportament, se produc o serie de interact,

| | | iuni între obiecte.
Temperatura s,

i umiditatea sunt returnate în urma apelului metodelor readTemp s,

i rea-
dHumidity pe o instant,a a clasei ˘ | DHTSensor. În continuare, utilizând un obiect de tip
WiFiModule, se vor apela metodele responsabile pentru controlul sistemului de încal- ˘ zire s,
i indicarea statusului placut ˘ ,ei. Daca aceasta este conectat ˘ | a la internet, se va aprinde ˘
un led incorporat, altfel va ramâne stins. În cele din urm ˘ | a, se apeleaz ˘ | a metodele din ca- ˘
drul clasei LCD pentru a afis, a valorile temperaturilor.

4.3. PROIECTARE DETALIATA | 31 ˘


Figura 4.8: Mod de operare pe intervale orare

4.3. PROIECTARE DETALIATA | 32 ˘
Diagrama de secvent,a prezentat ˘ | a este aferent ˘ | a modului de funct ˘ | ,
ionare pe intervale
orare, în timpul zilelor din weekend. Sistemul permite setarea unor temperaturi diferite
pe durata a doua perioade, valabile doar sâmb ˘ | ata s ˘ | ,
i duminica. Aceast ˘ | a funct ˘ | ,
ionalitate
este valabila dac ˘ | a modul automat este activat s ˘ | ,
| | i poate fi utila, deoarece permite setarea ˘
unei temperaturi mai mici pe timpul nopt,
| | ii, având ca s, | i efect un consum redus. Pentru
zilele lucratoare, modul de operare este identic, cu ment ˘ | ,
iunea ca sistemul va citi s ˘ | ,
i
gestiona patru intervale orare.
Din punct de vedere funct, | ional, prezinta o complexitate mai mare, fapt ilustrat in- ˘
clusiv de numarul de interact ˘ | ,
iuni între instant,ele claselor. Asemenea modului de operare prezentat anterior, apare interact,

iunea cu clasa DHTSensor pentru a obt,

ine valorile
umiditat˘,
ii s,

i temperaturii ambientale. Deoarece exista o conexiune la internet, aceste ˘ valori vor fi stocate în baza de date. Motiv pentru care, este necesar apelul metodelor sendCurrentTemperatureToDatabase s,

i sendHumidityToDatabase pe un obiect al clasei
WiFiModule. Apelul urmator este necesar pentru a actualiza variabila care ret ˘ | ,
ine modul
actual de funct,

ionare al sistemului.
Pentru a putea stabili în ce interval orar se încadreaza sistemul, este necesar s ˘ | a se ˘
cunoasca ziua, ora s ˘ | ,
i minutul curent. Apelurile metodelor, din clasa TimeManager, getWeekDay, getCurrentHour s,
i getCurrentMinute satisfac aceasta necesitate. Dac ˘ | a exist ˘ | a˘
modificari în baza de date, sau dac ˘ | a s-a f ˘ | acut o comutare de la modul clasic de ope- ˘
rare la cel automat, este necesar sa se reciteasc ˘ | a valorile intervalelor. De aceea, se ˘
apeleaza˘ readStr("Intervals/Weekend/A") s,
i readStr("Intervals/Weekend/B") pe instant,a clasei WiFiModule. În continuare, apelurile metodelor din clasa TimeManager au rolul de a prelucra intervalele, returnate ca s,

ir de caractere de apelul readStr. În urma blocului condit,

ional, se va citi temperatura setata pentru intervalul curent. ˘
Interact,

iunile urmatoare, cu obiecte de tip WiFiModule, au rolul de a îndeplini ˘ funct,

ii precum reglarea temperaturii s,

i setarea statusului placut ˘ ,ei ESP8266. Identic
modului de operare far˘ a conexiune la internet, metodele din clasa ˘ | LCD sunt utilizate
pentru a afis, a valorile pe ecran.

4.3. PROIECTARE DETALIATA | 33 ˘


Figura 4.9: Mod operare clasic

Acest mod de operare ment,

ine temperatura setata de utilizator, f ˘ | ar˘ a a fi influent ˘ | ,at de
timp sau data. Spre deosebire de modul de operare f ˘ | ar˘ a conexiune la internet, acesta ˘
face transfer de informat,

ii cu baza de date. Prin urmare, apar noi interact,

iuni cu instant,e
ale clasei WiFiModule pentru: salvarea temperaturii s,

i umiditat˘,
ii în baza de date, actualizarea variabilei switchIntervalsOn s,

i actualizarea temperaturii setate. Apelul metodei readStreamValue(desiredTemperature, streamDesiredTemperature, "/DesiredTempRoom1/Zapier/Value") va actualiza temperatura dorita doar când apar ˘
modificari. Îns ˘ | a, când se face o comutare de la modul automat la cel clasic, se foloses ˘ | ,
te
apelulreadDesiredTemperatureFromDatabase("DesiredTempRoom1/Zapier/Value"), deoarece este posibil ca datele din baza de date sa nu fie modificate. Situat,

ie în care funct,

ia
readStreamValue nu ar returna nicio valoare.

4.4. IMPLEMENTAREA SOLUT, IEI | 34

### 4.3.3 Structura software ˘

Structura aplicat,
iei web

Din punct de vedere structural, aplicat,

ia web cont,

ine doua directoare cu implemen- ˘
tari specifice p ˘ | art ˘ ,
ii de interfat,a cu utilizatorul. Acestea sunt: ˘
- templates - alcatuit din fis ˘ | ,
iere de tip html.
- static - format din poze ce vor fi afis, ate în cadrul aplicat,

iei, fis,

iere javascript
s,

i css.

A fost necesara ad ˘ | augarea directorului ˘ | functions. Acesta este impart ˘ ,
it în module
python, care implementeaza funct ˘ ,

ionalitat˘,
| | i precum: conversii de tipuri de date, validarea
parolei, citirea orei s, | i minutului curent s, | i restrict, ionarea accesului utilizatorilor, care nu
sunt administratori, la anumite servicii ale aplicat,
| | iei.
Codul ce implementeaza logica programului este împ ˘ | art ˘ ,
| | it în 3 module python. Fie-
care modul încapsuleaza funct ˘ | ,
| | ii specifice categoriei în care se încadreaza. De exemplu, ˘
modulul accounts.py va cont,

ine funct,

| | iile pentru gestiunea conturilor din baza de date.
Setarea temperaturilor, intervalelor orare s,
| | i al modului de funct, ionare al sistemului sunt
implementate în cadrul modului controls.py. În cele din urma, funct ˘ | ,
| | iile de baza,˘ login
s,

i logout, sunt cont,

inute în main.py.

Structura cod aferent componentei electronice ˘

Modulele de cod ce implementeaza serviciile oferite de componenta electronic ˘ | a˘
sunt:
- softwareForESP8266 - cont,
| | ine implementarea tuturor funct, ionalitat˘,
ilor oferite de modulul WiFi.
- softwareForArduino - prezinta logica din spatele modulului de control al cen- ˘ tralei termice.

De asemenea, codul prezent în modulul softwareForESP8266 este divizat în mai multe clase, conform 4.6

4.4 Implementarea solut,

## iei

În acest subcapitol voi prezenta secvent,e de cod folosite pentru programarea part ˘ , ii
hardware, dar s,

i cod aferent aplicat,

iei web.

4.4. IMPLEMENTAREA SOLUT, IEI | 35

### 4.4.1 Programare modul ESP8266

Init,

ializari ˘

Modulul prezinta o serie vast ˘ | a de funct ˘ | ,

ionalitat˘,
i s,

i se conecteaza cu mai multe com- ˘ ponente auxiliare. Pentru programarea acestuia am utilizat ArduinoIDE, iar ca s,

i limbaj
de programare, C++.
Codul este împart ˘ ,
it în trei fis,

iere cu extensii diferite: .ino, .cpp s,

i .h. În fis,
ierul
cu extensia .h se afla prototipurile claselor s ˘ | ,
i al metodelor, iar fis,

ierul .cpp cont,

ine im-
plementarile acestor metode. Fis ˘ | ,
ierul .ino este alcatuit din dou ˘ | a funct ˘ | ,
ii: setup s,

i loop.
Prima este utilizata pentru init ˘ | ,

ializari s ˘ ,

i se executa o singur ˘ | a dat ˘ | a, la pornirea modulu- ˘
lui. În ceea ce prives,
te cea de-a doua funct,
ie, se executa în mod repetitiv pân ˘ | a la oprirea ˘
alimentarii pl ˘ | acut ˘ ,ei WiFi.

În continuare, voi prezenta funct, ia setup din fis,

ierul .ino s,

i voi explica rolul apelurilor din cadrul acesteia.

#include "WiFiModule.h"

WiFiModule wifiModule;
LCD lcd;
TimeManager timeManager;
RFTransmitter rfTransmitter; DHTSensor dhtSensor;

FirebaseData streamDesiredTemperature; FirebaseData streamSwitchIntervalsOn; FirebaseData streamIntervals;

void setup() {
timeManager.timeManagerConfig(); lcd.initializeLCD();
rfTransmitter.initializeRFTransmitter(); wifiModule.pinSetup();
wifiModule.connectToInternet("Asus", "vitomir10"); Firebase.begin(FIREBASE_HOST, FIREBASE_AUTH); wifiModule.defineInterrupts(); wifiModule.stream(streamDesiredTemperature, "/DesiredTempRoom2/Zapier/Value"); wifiModule.stream(streamSwitchIntervalsOn, "/SwitchIntervalsOn/Value"); wifiModule.stream(streamIntervals, "/Intervals"); delay(500);

4.4. IMPLEMENTAREA SOLUT, IEI | 36

}

Pentru început, se creeaza instant ˘ | ,e pentru clasele ale caror funct ˘ | ,

ionalitat˘,

i urmeaza˘
sa fie utilizate, iar în corpul funct ˘ | ,
iei setup se vor apela funct,

ii ce t,

in de init,

ializare.
Din clasa TimeManager se apeleaza metoda ˘ | timeManagerConfig, fiind responsabila˘
de setarea fusului orar. Timpul curent este folosit în modul de funct,

ionare automat, mod
în care se t,

ine cont de temperaturile setate de utilizator pe anumite intervale orare.
Pâna se execut ˘ | a toate funct ˘ | ,
iile de init,

ializare, LCD-ul va fi pornit s,

i va afis, a mesajul
"Initializing...". Pentru ca acest comportament sa fie posibil, este necesar apelul metodei ˘ lcd.initializeLCD().
Apelarea metodei initializeRFTransmitter din cadrul clasei RFTransmitter are ca s,

i scop declans, area procesului de init,

ializare al transmit,atorului. Acesta reprezint ˘ | a o ˘
precondit,

ie pentru transferul de date între modulele senzor s,

i modulul de control.
Pinii disponibili pe aceasta component ˘ | a electronic ˘ | a pot funct ˘ | ,

iona fie ca intrari, fie ˘ ca ies,

iri, insa este responsabilitatea programatorului s ˘ | a seteze modul de funct ˘ | ,
ionare a
fiecarui pin în parte. Toate aceste configurat ˘ | ,

ii le-am grupat în metoda pinSetup, al carei ˘ cod îl voi face disponibil.

void WiFiModule::pinSetup(){ pinMode(RELAY_PIN, OUTPUT); pinMode(INCREASE_TEMPERATURE_PIN, INPUT); pinMode(DECREASE_TEMPERATURE_PIN, INPUT); pinMode(LED_BUILTIN, OUTPUT);
}

Pentru identificarea pinilor am definit macrouri, cu nume sugestive, iar cuvintele cheie INPUT s,

i OUTPUT au fost predefinite în bibliotecile utilizate. Majoritatea funct,

ionalitat˘,

ilor îndeplinite de acest modul necesita o conexiune valid ˘ | a˘
la internet. Primul pas în acest sens se face prin apelul metodei connectToInternet. În cadrul funct,

iei WiFi.begin() trebuie ment, ionat numele ret,elei la care se conecteaza s ˘ , i
parola. Modulul este programat în as, a fel încât timpul alocat conectarii la internet s ˘ | a˘
fie de maximum 15 secunde. Daca acesta este dep ˘ | as˘ ,
it, este posibil sa fie o problem ˘ | a în ˘
ceea ce prives,

te conexiunea la internet, iar modulul va funct,

iona deconectat de la baza de date.
Dupa ce pl ˘ | acut ˘ ,a WiFi a reus,
it sa se conecteze la internet, urm ˘ | atorul pas este identi- ˘
ficarea bazei de date. Apelul metodei Firebase.begin necesita doi parametri, s ˘ | ,
i anume:
adresa bazei de date s,

i cheia secreta. Aces ˘ ,
tia sunt utilizat,

i pentru a localiza baza de date,

4.4. IMPLEMENTAREA SOLUT, IEI | | 37

respectiv pentru a oferi acces la aceasta.
Setarea temperaturii se realizeaza prin întreruperi. Trebuie definit pinul s ˘ | | , i frontul
semnalului pe care se declans, eaza întreruperea, dar s ˘ | ,
i numele rutinei de tratare. Toate
acestea se realizeaza în metoda ˘ | defineInterrupts.
Ultimele apeluri din funct,

ia setup, stream(instance, path), au rolul de a seta instant,a s,

i câmpul din baza de date pentru care se vor monitoriza schimbarile de valoare. Modu- ˘ lul face citiri din baza de date doar când sunt date actualizate, astfel reus,

| | ind sa econo- ˘
miseasca din resursele disponibile. ˘

Întreruperile s,
i tratarea acestora

În continuare, voi prezenta rutinele de tratare a întreruperilor. Acestea sunt sim-
ple, nu consuma multe resurse s ˘ | ,
i, ceea ce este esent,

ial în crearea unor astfel de rutine, execut,

ia lor nu dureaza mult. De asemenea, utilizez dou ˘ | a variabile globale, ˘ | increaseDe-
siredTemperature s,
i decreaseDesiredTemperature, pentru a marca faptul ca o procedur ˘ | a˘
de tratare a întreruperii a fost accesata.˘

ICACHE_RAM_ATTR void increaseTemperature() { increaseDesiredTemperature = true;
}

ICACHE_RAM_ATTR void decreaseTemperature() { decreaseDesiredTemperature = true;
}

În momentul în care este act,
ionat unul din cele doua butoane responsabile cu mo- ˘
dificarea temperaturii setate, se declanseaza execut ˘ | ,
ia unei serii de instruct,

iuni. Acestea
sunt consumatoare de resurse, motiv pentru care, se executa în interiorul funct ˘ | ,
iei loop.

if(increaseDesiredTemperature || decreaseDesiredTemperature){ if(increaseDesiredTemperature){
if(desiredTemperature < MAX_TEMP){
desiredTemperature++;
lcd.displayDesiredTemperature(); if (WiFi.status() == WL_CONNECTED && (!switchIntervalsOn))
{
wifiModule.sendDesiredTemperatureToDatabase ("DesiredTempRoom2/Zapier/Value");

4.4. IMPLEMENTAREA SOLUT, IEI | 38

}
}
increaseDesiredTemperature = false; }else{
if(desiredTemperature > MIN_TEMP){ desiredTemperature--;
lcd.displayDesiredTemperature(); if (WiFi.status() == WL_CONNECTED && (!switchIntervalsOn))
{
wifiModule.sendDesiredTemperatureToDatabase ("DesiredTempRoom2/Zapier/Value");
}
}
decreaseDesiredTemperature = false; }
}
Pentru început, se verifica dac ˘ | a de la ultima iterat ˘ | ,
ie a fost modificata variabila ˘ | in-
creaseDesiredTemperature sau decreaseDesiredTemperature. În caz afirmativ, se face o incrementare sau decrementare a valorii temperaturii setate. Pentru ca rezultatul sa se ˘
afis, eze pe LCD cât mai repede, dupa ajustarea valorii, se face apelul funct ˘ | ,
iei display-DesiredTemperature, din cadrul clasei LCD. Astfel, se obt,

ine un timp mic de actualizare s,

i o experient,a mai bun ˘ | a cu utilizatorul. De asemenea, se examineaz ˘ | a modul de ˘
funct,

ionare a modulului wireless, conectat, sau nu, la o ret,ea de internet. In cazul în
care exista o conexiune valid ˘ | a, valoarea actualizat ˘ | a a temperaturii va fi trimis ˘ | a în baza ˘
de date. O alta condit ˘ | ,
ie necesara este ca modul de funct ˘ | ,
| | | ionare pe intervale orare sa fie ˘
dezactivat !switchIntervalsOn.

Mod de operare presetat de utilizator

Sistemul este setat asfel încât sa ofere posibilitatea utilizatorului de a alege patru ˘
intervale orare, cu temperaturi diferite, în timpul zilelor lucratoare. În ceea ce prives ˘ | ,
te
ultimele zile ale sapt ˘ amânii, sâmb ˘ | at˘ a s ˘ ,
i duminica, se pot seta doar dou ˘ | a intervale orare ˘
pe zi, cu temperaturi diferite.

if (WiFi.status() == WL_CONNECTED) { wifiModule.sendCurrentTemperatureToDatabase(currentTemperature); wifiModule.sendHumidityToDatabase(humidity); wifiModule.readStreamValue(switchIntervalsOn,

4.4. IMPLEMENTAREA SOLUT, IEI | 39

streamSwitchIntervalsOn, "SwitchIntervalsOn/Value");
if (switchIntervalsOn) {
int weekDay = timeManager.getWeekDay();
int currentHour = timeManager.getCurrentHour(); int currentMinute = timeManager.getCurrentMinute(); if(wifiModule.checkForUpdate(streamIntervals, "/Intervals") || (!timeIntervalsOperatingMode))
{
if (weekDay == 6 || weekDay == 0) {
String A = wifiModule.readStr("Intervals/Weekend/A"); String B = wifiModule.readStr("Intervals/Weekend/B");

int hourA = timeManager.getHourFromTimeFormat(A); int minuteA = timeManager.getMinuteFromTimeFormat(A); int hourB = timeManager.getHourFromTimeFormat(B); int minuteB = timeManager.getMinuteFromTimeFormat(B);

if ((hourA < currentHour && currentHour < hourB) || (hourA == currentHour && currentMinute >= minuteA) ||
(hourB == currentHour && currentMinute < minuteB)) {
wifiModule.readDesiredTemperatureFromDatabase ("Intervals/Weekend/TemperatureAB"); endHour = hourB;
endMinute = minuteB;
} else {
wifiModule.readDesiredTemperatureFromDatabase ("Intervals/Weekend/TemperatureBA"); endHour = hourA;
endMinute = minuteA;
}
}
Primele doua instruct ˘ | ,

iuni au rolul de a încarca în baza de date valoarea temperaturii ˘
si a umiditatii. Modul de funct ˘ | ,
ionare a sistemului este salvat într-un câmp al bazei de date, numit SwitchIntervalsOn/Value. Acesta este monitorizat prin instalarea unui observator pe câmpul bazei de date.
Instruct,
iunile ce urmeaza au rolul de a încadra sistemul în ora, minutul s ˘ | ,
i ziua cu-
renta, iar cu ajutorul acestora, sistemul poate urm ˘ | ari programul de temperaturi setat de ˘
catre utilizator. Secvent ˘ | ,a de cod prezentata anterior este utilizat ˘ | a pentru încadrarea zi- ˘

4.4. IMPLEMENTAREA SOLUT, IEI | | | 40

lelor de la sfârs,

itul sapt ˘ amânii, sâmb ˘ | at˘ a si duminic ˘ | a. In cazul în care nu se respect ˘ | a˘
condit,
ita, se executa secvent ˘ | ,ele condit,
ionale urmatoare, împreun ˘ | a cu citirile capetelor ˘
intervalelor s,

i valorile temperaturilor corespunzatoare. ˘

{
String A = wifiModule.readStr("Intervals/WorkingDay/A"); String B = wifiModule.readStr("Intervals/WorkingDay/B"); String C = wifiModule.readStr("Intervals/WorkingDay/C"); String D = wifiModule.readStr("Intervals/WorkingDay/D");

int hourA = timeManager.getHourFromTimeFormat(A);
int minuteA = timeManager.getMinuteFromTimeFormat(A); int hourB = timeManager.getHourFromTimeFormat(B); int minuteB = timeManager.getMinuteFromTimeFormat(B); int hourC = timeManager.getHourFromTimeFormat(C); int minuteC = timeManager.getMinuteFromTimeFormat(C); int hourD = timeManager.getHourFromTimeFormat(D); int minuteD = timeManager.getMinuteFromTimeFormat(D);

if ((hourA < currentHour && currentHour < hourB) || (hourA == hourB && currentHour == hourA && currentMinute >= minuteA && currentMinute < minuteB) || (hourA == currentHour && hourB != currentHour && currentMinute >= minuteA) || (hourA != currentHour && hourB == currentHour && currentMinute < minuteB)) { wifiModule.readDesiredTemperatureFromDatabase ("Intervals/WorkingDay/TemperatureAB"); endHour = hourB;
endMinute = minuteB;
} else if ((hourB < currentHour && currentHour < hourC) || (hourB == hourC && currentHour == hourB && currentMinute >= minuteB && currentMinute < minuteC) || (hourB == currentHour && hourC != currentHour && currentMinute >= minuteB) || (hourB != currentHour && hourC == currentHour && currentMinute < minuteC)){ wifiModule.readDesiredTemperatureFromDatabase ("Intervals/WorkingDay/TemperatureBC"); endHour = hourC;
endMinute = minuteC;
} else if ((hourC < currentHour && currentHour < hourD) || (hourC == hourD && currentHour == hourC &&

4.4. IMPLEMENTAREA SOLUT, IEI | 41

currentMinute >= minuteC && currentMinute < minuteD) || (hourC == currentHour && hourD != currentHour && currentMinute >= minuteC) || (hourC != currentHour && hourD == currentHour && currentMinute < minuteD)) { wifiModule.readDesiredTemperatureFromDatabase ("Intervals/WorkingDay/TemperatureCD"); endHour = hourD;
endMinute = minuteD;
} else {
wifiModule.readDesiredTemperatureFromDatabase ("Intervals/WorkingDay/TemperatureDA"); endHour = hourA;
endMinute = minuteA;
}
}

Mod clasic de operare

Pe lânga modul automat de funct ˘ | ,
ionare, sistemul este proiectat sa poat ˘ | a rula s ˘ | ,
i în
mod manual. Acesta presupune ment,

inerea unei temperaturi constante, setate de utilizator, prin butoane, comenzi vocale sau prin intermediul aplicat,

iei web. Este important de ment,

ionat faptul ca acesta consum ˘ | a mai put ˘ | ,
ine resurse comparativ cu modul de funct,
ionare pe intervale, însa nu ofer ˘ | a acelas ˘ | ,

i grad de confort. În continuare, voi prezenta o serie de instruct,

iuni de cod specifice implementarii modului manual. ˘

int currentTemperature = dhtSensor.readTemp(); int humidity = dhtSensor.readHumidity();

Prima etapa ce se execut ˘ | a în acest mod este citirea umidit ˘ | at˘,
ii s,

i a temperaturii de la
senzorul DHT11. Iar funct,

iile responsabile pentru aceste funct,

ionalitat˘,
i sunt apelate la
începutul funct,

iei loop.

wifiModule.heatControl(currentTemperature); wifiModule.statusIndicator(); lcd.displayDesiredTemperature(); lcd.displayCurrentTemperature(currentTemperature);

4.4. IMPLEMENTAREA SOLUT, IEI | | 42
Pentru a face posibila pornirea/oprirea sistemului de înc ˘ | alzire, este necesar apelul ˘
funct,
iei heatControl. Acesta trimite comanda atât la electrovalva montat ˘ | a pe calorifer, ˘
cât s,
i la centrala termica. De asemenea, este necesar apelul ˘ | displayDesiredTemperature
s,

i displayCurrentTemperature pentru a afis, a temperatura setata s ˘ ,

i temperatura dorita din ˘ camera. Scopul final este de a permite monitorizarea temperaturii ambientale. ˘

4.4.2 Programare placut ˘ | ,a Arduino ˘
Este montata în modulul de control s ˘ | ,

i se conecteaza la componente auxiliare pre- ˘ cum: receptor RF s,

i releu, iar prin intermediul acestora face posibil controlul centralei
termice. Codul sursa care face posibil tot acest comportament se afl ˘ | a pe pl ˘ | acut ˘ ,a Ardu-
ino.

unsigned char dataPackage[3];
uint8_t dataPackageLength = sizeof(dataPackage); if (driver.recv(dataPackage, &dataPackageLength)) {
dataPackage[2] = ’\0’;
Serial.println((char *) dataPackage);
int dataPackageInt = atoi((char *) dataPackage);

if((dataPackageInt/10) == 1){
commandModule1 = dataPackageInt%10; timeFirstModuleSent = millis()/1000; }
else{
commandModule2 = dataPackageInt%10; timeSecondModuleSent = millis()/1000; }

Serial.print("Module1:");
Serial.println(commandModule1); Serial.print("Module2:");
Serial.println(commandModule2); if(commandModule1 || commandModule2){ digitalWrite(7, LOW);
Serial.println("On");
}else{
digitalWrite(7, HIGH);
Serial.println("Off");
}
}

4.4. IMPLEMENTAREA SOLUT, IEI | 43

if((((millis()/1000) - timeFirstModuleSent) >= TIMEOUT && ((millis()/1000) - timeSecondModuleSent) >= TIMEOUT)) {
digitalWrite(7, HIGH);
commandModule1 = 0;
commandModule2 = 0;
}
else if(((millis()/1000) - timeFirstModuleSent) >= TIMEOUT && commandModule2 == 0)
{
digitalWrite(7, HIGH);
commandModule1 = 0;
}
else if(((millis()/1000) - timeSecondModuleSent) >= TIMEOUT && commandModule1 == 0) {
digitalWrite(7, HIGH);
commandModule2 = 0;
}
Mesajul pe care modulul receptor îl intercepteaza este format din doi octet ˘ | ,
i, din care
octetul cel mai semnificativ cont,

ine numarul de identificare al modulului care a trimis ˘ mesajul, iar octetul cel mai put,

in semnificativ det,

ine informat,

ii legate de natura comenzii. Mesajul recept,

ionat este convertit în întreg datorita faptului c ˘ | a se poate prelucra mai ˘
us,or aplicând operat,

ii, precum: modulo s,

i div.
Întotdeauna se salveaza momentul în care s-au recept ˘ | ,
ionat informat,

ii de la fiecare
modul în parte. Este importanta ment ˘ ,
inerea evident,ei, pentru a evita situat,

iile în care
apar întreruperi de transfer prin radio - frecvent,a. Ca s ˘ | ,
i o masur ˘ | a de prevent ˘ | ,

ie, daca˘
modulul de control nu primes,

te comenzi de la modulele senzor un timp mai mare sau
egal cu 5 secunde, centrala termica va fi oprit ˘ | a.˘
Dupa ce au fost primite comenzi de la ambele module senzor, se execut ˘ | a operat ˘ | ,
ie
logica de tip SAU, iar în funct ˘ | ,
ie de rezultatul acesteia, va cupla sau decupla releul,
ce în continuare controleaza centrala termic ˘ | a. Un octet cu valoarea 1 indic ˘ | a pornirea, ˘
iar un octet cu valoarea 0 indica oprirea centralei din imobil. De asemenea, ultimele ˘ instruct,

iuni condit,

ionale din secvent,a de cod afis, ata anterior, au rolul de a implementa ˘
oprirea de sigurant,a a sistemului de înc ˘ | alzire. ˘
Init,
ial, se verifica dac ˘ | a ambele module senzor nu au trimis comenzi de mai mult de 5 ˘
secunde. Daca nu se respect ˘ | a prima condit ˘ | ,

ie, se examineaza cazul în care primul modul ˘
are conexiunea întrerupta, iar cel de-al doilea trimite comand ˘ | a de oprire a sistemului de ˘
încalzire. Iar ultima situat ˘ | ,

ie care poate aparea este cea în care conexiunea prin radio ˘
frecvent,a la al doilea modul este inactiv ˘ | a de peste 5 secunde, iar primul modul trimite ˘

4.4. IMPLEMENTAREA SOLUT, IEI | 44
comanda de întrerupere a funct ˘ | ,
ionarii centralei. Toate aceste situat ˘ | ,
ii apar în cazuri de
avarie, iar principala cauza este comunicat ˘ | ,
ia precara între modulele senzor s ˘ | ,
i modulul
de control. Pentru a preveni defectarea centralei termice, este conceputa o m ˘ | asur ˘ | a de ˘
sigurant,a ce const ˘ | a în oprirea acesteia. ˘

4.4.3 Realizarea aplicat,

### iei web

Aplicat,

ia web face transferul de date cu partea electronica prin intermediul bazei ˘ de date Firebase. Valorile umiditat˘, ii s,

i a temperaturii se actualizeaza în aplicat ˘ | ,
ia web
doar atunci când apar modificari în baza de date. Astfel, se evit ˘ | a citirile repetate s ˘ | ,
i
consumatoare de resurse.
În ceea ce prives,
te partea de acces a aplicat,
iei, aceasta este gazduit ˘ | a pe un server, ˘
la distant,a, prin intermediul platformei ˘ | Heroku. Oricine det,
ine adresa aplicat,

iei o poate
accesa, însa prima pagin ˘ | a care apare la accesare este cea de conectare, iar navigarea ˘
poate fi continuata doar în cazul în care utilizatorul det ˘ | ,
ine un cont valid.

Secvent,e de cod esent,

iale din cadrul implementarii aplicat ˘ | ,
iei web

Pentru a asigura accesul la aplicat,

ie doar a persoanelor privilegiate, trebuie creata˘
o pagina de conectare ce s ˘ | a permit ˘ | a verificarea concordant ˘ | ,ei credent,
ialelor introduse
în formular cu cele salvate în baza de date. În cazul unei potriviri, utilizatorul este redirect,

ionat la calea /home, aceasta apart,

| | | inând paginii principale s, i permite monitori-
zarea parametrilor ambientali s,

i setarea temperaturii dorite. Situat,

| | | ia în care se introduc
credent,

iale gres,

ite este tratata printr-un mesaj de avertizare, iar utilizatorului i se ofer ˘ | a˘
posibilitatea reintroducerii datelor de conectare. Init,

ial, se preiau informat,

| | iile din interfat,a s ˘ ,
i se verifica existent ˘ | ,a utilizatorului cu
numele introdus, instruct,
iunea ce realizeaza acest aspect este: ˘ | user_to_login =
Users.query.filter_by(username=username).first(). Daca numele ˘
utilizatorului a fost gasit, urm ˘ | atorul pas ce trebuie inspectat este potrivirea parolei intro- ˘
duse cu cea salvata în baza de date. Este esent ˘ | ,
| | | ial de luat în considerare faptul ca parolele ˘
sunt salvate criptate în baza de date, iar înainte de a face comparat,
| | | ia cu parola introdusa,˘
este obligatorie s,

i criptarea parolei tastate de utilizator în formularul de conectare.
Logica din spatele criptarii s ˘ | ,
| | i verificarii ulterioare a parolei o voi prezenta în rându- ˘
rile ce urmeaza.˘

if user_to_login:
if bcrypt.check_password_hash(user_to_login.password, password):

4.4. IMPLEMENTAREA SOLUT, IEI | 45

login_user(user_to_login)
return redirect(url_for(’home’))

Funct,

ia bcrypt.check_password_hash cripteaza parola din formular s ˘ | ,
i face
si o comparat,

ie cu parola din baza de date. În cazul în care corespondent,a este verificata,˘ utilizatorul devine înregistrat în aplicat,

ia web s,

i dobândes,

te drepturi de acces.

Prin intermediul paginii home din cadrul aplicat,

iei web, utilizatorul are posibilitatea
sa salveze în baza de date diverse valori ale temperaturilor ce urmeaz ˘ | a a fi ment ˘ | ,
inute
în imobil. În continuare, voi prezenta funct,
ia care se apeleaza în aceast ˘ | a situat ˘ | , ie. Este
implementata în ˘ | flask s,
i se executa în momentul în care se ajunge la calea ˘ | | /home.

@app.route(’/home’, methods=[’POST’, ’GET’]) @login_required
def home():
status = firebase.get(’SwitchIntervalsOn’, ’Value’) if request.method == ’POST’:
variable = request.form.get(’outputValue1’)
if variable is not None:
firebase.put(’DesiredTempRoom1/Zapier’, ’Value’, int(variable))
else:
variable = request.form.get(’outputValue2’) firebase.put(’DesiredTempRoom2/Zapier’, ’Value’, int(variable))
return render_template(’controlPage.html’, status=status)
Se utilizeaza la setarea temperaturii în baza de date, dar s ˘ | ,
i la citirea câmpului SwitchInvtervalsOn/Value, ce cont,

ine informat,

ii referitoare la modul de programare al temperaturilor dorite.
Reprezinta o leg ˘ | atur ˘ | a între partea de interfat ˘ | ,a s ˘ ,
i logica din spatele aplicat,

iei web.
Cu alte cuvinte, valoarea introdusa de c ˘ | atre utilizator prin intermediul elementelor de ˘
intrare din html, este transferata în partea responsabil ˘ | a cu procesarea informat ˘ | ,
iilor. Prin
intermediul funct,

iilor puse la dispozit,

| | | ie de un modul implementat în python, valorile
introduse se transmit mai departe în baza de date.
Apelul render_template este util pentru a prelucra paginile html. Acestea pot cont,

ine diverse variabile trimise ca si parametri s,

| | | i pot executa structuri de control, toate
acestea pentru a facilita felul în care se construies,
| | | te interfat,a cu utilizatorul. Variabila

4.4. IMPLEMENTAREA SOLUT, IEI | 46
status este transmisa mai departe paginii intitulate ˘ | | controlPage s,

i este utilizata pentru a ˘ seta pozit,

ia butonului ce indica modul de funct ˘ | ,
| | ionare al sistemului.

În cele ce urmeaza, voi ilustra modul în care se face o programare a temperaturi- ˘ lor pentru mai multe zile. Voi prezenta traseul pe care informat,

iile il parcurg, de la
introducerea acestora de catre utilizator, pân ˘ | a la prelucrarea s ˘ | ,
i salvarea lor în baza de
date.
Voi începe prin a expune codul ce face posibila crearea formularelor utilizate pen- ˘ tru introducerea valorilor temperaturilor s,

i a intervalelor orare. Acestea sunt esent,

iale
pentru interact,

iunea între sistem s,

i utilizator.

<div class="form-group">
<input type="time" class="form-control" name="firstWorkingDayInterval" id="firstWorkingDayInterval" required> </div>
<div class="form-group">
<input type="number" class="form-control" name="temperatureFirstWDInterval" id="temperatureFirstWDInterval" placeholder="Temperature 1" required> </div>

Primul tip de intrare html utilizat este cel pentru formatul timp. Este un câmp predefinit, împart ˘ ,

it în doua sect ˘ ,

iuni, una pentru alegerea orei, iar cealalta pentru selectarea ˘ minutului.

4.4. IMPLEMENTAREA SOLUT, IEI | 47

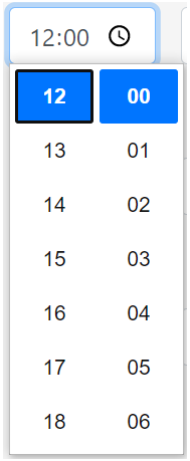
[picture p47: figure]

Figura 4.10: Intrare HTML pentru formatul timp

Cel de-al doilea tip de intrare prezentat, cel de tip numeric, este utilizat pentru se-
tarea valorii temperaturii. Formatul intrarii este creat în as, a natura încât s ˘ | a permit ˘ | a un ˘
reglaj al valorii, la nivel de unitate.

Figura 4.11: Intrare HTML pentru formatul numeric

4.4. IMPLEMENTAREA SOLUT, IEI | 48
Dupa ce utilizatorul completeaz ˘ | a toate câmpurile, aceste valori urmeaz ˘ | a s ˘ a fie trans- ˘
mise mai departe part,
| ii, din cadrul aplicat, | iei web, responsabile cu procesarea informat,

iilor.
Transferul datelor se face prin metode de tip POST.
Înainte de salvarea informat,
| iilor în baza de date, este necesara o verificare a acestora. ˘
Valorile temperaturilor trebuie sa se încadreze în intervalul 15 °C s ˘ | ,
| | i 32 °C, iar orice
depas˘ ,

ire a acestor limite nu poate fi stocata. De asemenea, ordinea intervalelor orare ˘
trebuie sa fie setat ˘ | a într-un mod cronologic. În cazul în care aceste condit ˘ | , ii nu sunt
respectate, se va afis, a un mesaj de eroare adaptat contextului, iar utilizatorului i se ofera˘ posibilitatea reintroducerii datelor.

MIN = 15
MAX = 32

timeObjectA = getTime(a)
timeObjectB = getTime(b)
timeObjectC = getTime(c)
timeObjectD = getTime(d)

if int(temperatureAB) < MIN or int(temperatureAB) > MAX or int(temperatureBC) < MIN or int(temperatureBC) > MAX or int(temperatureCD) < MIN or int(temperatureCD) > MAX or int(temperatureDA) < MIN or int(temperatureDA) > MAX: flash(’The values of temperatures should be between 15 and 32 degrees!’, ’warning’)
else:
if timeObjectA < timeObjectB < timeObjectC < timeObjectD: try:
firebase.put(’Intervals/WorkingDay’, ’A’, a) firebase.put(’Intervals/WorkingDay’, ’B’, b) firebase.put(’Intervals/WorkingDay’, ’C’, c) firebase.put(’Intervals/WorkingDay’, ’D’, d)

firebase.put(’Intervals/WorkingDay’, ’TemperatureAB’, int(temperatureAB)) firebase.put(’Intervals/WorkingDay’, ’TemperatureBC’, int(temperatureBC)) firebase.put(’Intervals/WorkingDay’, ’TemperatureCD’, int(temperatureCD)) firebase.put(’Intervals/WorkingDay’, ’TemperatureDA’, int(temperatureDA))
except Exception as err:
flash(’An error ocurred while setting intervals:

4.4. IMPLEMENTAREA SOLUT, IEI | 49

{0}’.format(err), ’warning’) else:
flash(’Time intervals must be set chronologically!’, ’warning’)
return render_template(’schedulingPage.html’)

Prima instruct,

iune condit,

ionala utilizat ˘ | a în codul prezentat anterior, are rolul de a ˘
determina daca valorile temperaturilor introduse se încadreaz ˘ | a în intervalul acceptat de ˘
sistem s,

i de aplicat,

ia web.
Pe de alta parte, pentru a putea stabili dac ˘ | a exist ˘ | a o ordine cronologic ˘ | a, se apeleaz ˘ | a˘
funct,

ia getTime cu datele pe care le citim de la intrarea pentru formatul de tip timp.
Se creeaza obiecte ce cont ˘ | ,
in data, ora s,

i minutul curent pentru fiecare interval în parte.
Datorita faptului c ˘ | a aceste obiecte sunt predefinite in ˘ | python, se pot aplica operat,
| | | | ii de
comparat,

ie asupra lor.
Implementarea funct,

iei de încapsulare a valorilor intervalelor o voi prezenta în rân-
durile ce urmeaza, împreun ˘ | a cu explicat ˘ | ,
iile de cod aferente.

def getTime(timeFormat):
hour = getHourFromTimeFormat(timeFormat)
minute = getMinuteFromTimeFormat(timeFormat)

now = datetime.now(pytz.timezone(’Europe/Bucharest’)) dateTimeObject = datetime(now.year, now.month, now.day, hour, minute)

return dateTimeObject

Apelul getHourFromTimeFormat s,

i getMinuteFromTimeFormat sunt utilizate pentru a despart ˘ ,
i s,

irul de caractere ce cont,

ine ora s,

i minutul setat de catre utilizator. Obiectele ˘ predefinite în python pentru stocarea datei s, i timpului prezinta ca s ˘ ,
i câmpuri obligatorii:
anul, luna, ziua, ora s,

i minutul. Ca s,

i intrare de la utilizator primim doar ora s,

i minutul,
iar pentru crearea obiectului, restul valorilor ne sunt puse la dispozit,

ie prin intermediul
unui modul python, ce are setat fusul orar actual. În urma apelului funct, iei datetime sunt
returnate obiecte ce cont,

in data curenta, ora s ˘ , i minutul capetelor intervalelor introduse de utilizator. Pe aceste obiecte se vor executa operat,

ii de comparat,

ie pentru a determina
daca ordinea este una cronologic ˘ | a.˘
Intr-un final, dupa ce datele au fost validate, urmeaz ˘ | a salvarea acestora în baza de ˘
date. Pentru a implementa acest aspect, se utilizeaza suita de apeluri ˘ | firebase.put, care

4.4. IMPLEMENTAREA SOLUT, IEI | | 50

primesc ca s,

i parametrii: numele câmpului unde urmeaza s ˘ a se fac ˘ | a stocarea, împreun ˘ | a˘
cu informat,

iile aferente.


Figura 4.12: Stocare program intervale orare

### 4.4.4 Probleme întâmpinate în timpul realizarii proiectului ˘

Fort,a contraelectromotoare a bobinei

Electrovalvele sunt formate dintr-un solenoid. Aplicarea tensiunii la bornele acestuia duce la generarea unui câmp electromagnetic, care la rândul sau act ˘ ,

ioneaza un ˘
obturator. Astfel, se realizeaza închiderea/deschiderea circuitului de ap ˘ | a. Este impor- ˘
tant de ment,
ionat faptul ca solenoidul înmagazineaz ˘ | a curent, iar întreruperea alimentarii ˘
electrice a acestuia produce o descarcare, ce se manifest ˘ | a prin aparit ˘ | , ia unor fluctuat,
ii de
tensiune în circuit. Prezent,a acestor fluctuat,

ii poate duce la arderea celorlalte componente electronice, dar s,

i la o uzura accentuat ˘ | a a releelor de comand ˘ | a. De asemenea, ˘

4.4. IMPLEMENTAREA SOLUT, IEI | 51
descarcarea solenoidului produce aparit ˘ | ,
ia unor scântei între contactele releului, determinând perturbat,

ii în intreg sistemul. Un exemplu de disfunct,

ionalitate cu care m-am
confruntat din aceasa cauz ˘ a, a fost dereglarea temperaturii setate, în momentul în care ˘ modulul ESP8266 trimitea comanda de inchidere a elevtrovalvei. ˘

Vibrat,

iile contactelor metalice ale întrerupatoarelor ˘

Pentru a putea modifica valoarea temperaturii setate a fi ment,

inute în imobil, se
utilizeaza butoane fizice, legate prin conductori eletrici la modulele WiFi. Din punct ˘ de vedere funct,

ional, acestea pot avea comportament neas,

teptat, cauzat de vibrat,

iile
fine care se produc între contactele metalice ale întrerupatorului. Frecvent ˘ | ,a cu care
microcontrolerul cites,

te semnalul provenit de la buton este suficient de mare, astfel
încât, sa poat ˘ | a sesiza inclusiv o vibrat ˘ | ,
ie ca fiind o apasare distinct ˘ | a. Prin urmare, se ˘
întâmpla ocazional ca intent,

ia utilizatorului de a incrementa sau decrementa cu o unitate
temperatura setata, s ˘ a se traduc ˘ | a în modificarea acesteia cu mai multe unit ˘ | at˘,
i. Solut,

ia
pe care am implementat-o în aceasta situat ˘ ,
ie, a fost realizarea s,

i montarea unor filtre
trece jos pentru fiecare buton în parte. Rolul acestora este de a permite trecerea doar a semnalelor cu frecvent,e mici, iar cele de frecvent,e mari, perturbat,

iile, fiind oprite.
Capturile de ecran din cadrul capitolului 3, prezinta semnalul înainte de filtrare 3.1, dar ˘ s,

i dupa aceasta 3.2. ˘

Amorsarea instalat,

iei cu apa˘

Pompa de apa pe care am utilizat-o în circuit, nu prezint ˘ | a funct ˘ | ,
ionalitate de autoa-
morsare. Prin urmare, prima tentativa de umplere a circuitului cu ap ˘ | a, a constat în ˘
desfacerea unei îmbinari a circuitului s ˘ | ,

i introducerea apei cu o seringa prin aceasta. Din ˘
cauza faptului ca instalat ˘ | ,

ia prezinta multe coturi, iar introducerea apei nu o faceam din ˘
punctul cel mai înalt, procentajul de umplere al circuitului nu era satisfac˘ ator. Ca s ˘ | ,
i
disfunct,
ionalitate, se manifesta prin faptul ca pompa de ap ˘ | a de dezamorsa în timpul ˘
funct,
ionarii. Într-un final, am decis s ˘ | a montez un aerisitor în punctul cel mai înalt al ˘
instalat,

iei, iar introducerea apei sa se fac ˘ a prin acesta. Astfel, volumul de aer din circuit ˘ a fost redus considerabil, ducând la eliminarea situat,

iilor de dezamorsare a pompei.

Conflict de date aparut la transferul prin radio - frecvent ˘ | ,a˘
Ambele transmit,atoare utilizate în cadrul machetei funct ˘ | ,
ioneaza la aceeas ˘ | ,

i frecvent,a,˘
433 Mhz. Transferul datelor se face catre un singur receptor, montat pe modulul de ˘
comanda al centralei termice. Din punct de vedere funct ˘ | ,

ional, apareau probleme în ˘
momentul în care ambele transmit,atoare f ˘ | aceau transfer simultan. Datele nu mai ajun- ˘
geau sa fie recept ˘ | ,

ionate de catre receptor, ajungând la pierderea comenzilor. Modulele ˘
wireless sunt conectate la un server prin intermediul caruia citesc data s ˘ | ,

i ora curenta.˘

4.5. TESTAREA SOLUT, IEI | 52
Utilizând acest aspect, am programat modulele astfel încât sa fac ˘ | a transferul de date ˘
concurent. Un modul va transfera la secunda par ˘ | a, pe când cel ˘ | alalt la secund ˘ | a impar ˘ | a.˘

4.5 Testarea solut,

## iei

În orice proces ce implica dezvoltare de proiecte de o complexitate mai mare, etapa ˘ de testare este una esent,

iala. Aceasta presupune identificarea erorilor sistemului, înainte ˘ de a fi pus în product,

ie. Cazurile de test trebuie proiectate astfel încât sa cuprind ˘ | a toate ˘
situat,

iile care pot produce abateri de la comportamentul standard. În ceea ce prives,
te proiectul prezentat, testarea a vizat doua mari componente: aplicat ˘ | ,
ia
web s,

i instalat,

ia pentru circuitul de apa.˘ Flask ofera posibilitatea de creare de teste uni- ˘
tare pentru proiectele realizate prin intermediul lui. Pe lânga aceasta, permite s ˘ | ,
| | | | i analiza
procentului de acoperire al întregii aplicat,

ii prin testele scrise.
Voi începe prin a prezenta partea de validare a aplicat, iei web. Am realizat o suita de ˘ 50 de teste, pe care am împart ˘ ,
it-o în 3 mari categorii. Prima categorie cont,

ine cazurile de
test comune pentru tot,

i utilizatorii, funct,

ionalitat˘,
i care sunt valabile indiferent de rolul persoanei autentificate aplicat,
iei. Am încercat sa abordez o manier ˘ | a exhaustiv ˘ | a, prin ˘
simularea tuturor situat,

iilor de eroare, dar s,

i de reus,

ita. Printre cazurile mai importante ˘
de test care se încadreaza în aceast ˘ | a categorie sunt: ˘
- Verificarea faptului ca pentru a putea realiza orice funct ˘ | ,
ionalitate din aplicat,

ia
web, trebuie sa existe un utilizator conectat. Altfel, accesul este obligatoriu s ˘ | a fie ˘
interzis.
- Încercarea de conectare utilizând un cont inexistent, trebuie interzisa s ˘ ,
| | | | i aver-
tizata printr-un mesaj de eroare. ˘
- Verificarea funct,

iei de criptare a parolei utilizatorului.

- Verificarea posibilitat˘,
ii de conectare la aplicat,
| | ia web.
- Introducerea parolei gres, ite în momentul conectarii. ˘
- Testarea funct,

ionalitat˘,
ii de deconectare.
- Acitvare/Dezactivare mod de lucru cu intervale orare
- Controlul posibilitat˘,

ii de setare a intervalelor pentru zile lucratoare, dar si ˘ pentru cele de la sfârs,

itul sapt ˘ amânii. De asemenea, cazurile acestea de test se ˘ împart în mai multe. Situat, ia în care acestea nu sunt setate în ordine cronologica˘ s,

i situat,

ia în care vreo valoare a temperaturii nu se încadreaza în intervalul 15 °C ˘
- 32 °C.
- Funct,
ia de schimbare a parolei, implica verificarea situat ˘ | ,
iilor în care: parola
curenta nu este valid ˘ | a, parolele introduse nu se potrivesc, noua parol ˘ | a este prea ˘

4.5. TESTAREA SOLUT, IEI | 53
scurta, noua parol ˘ | a nu cont ˘ | ,

ine majuscula s ˘ ,
i situat,
ia în care noua parola nu cont ˘ | ,
ine
cifra.˘
- Verificarea funct,
| | iei de setare a temperaturii pentru ambele camere.

Cea de-a doua categorie este dedicata testelor unitare pentru utilizatorii care nu au ˘
drepturi de administrator. În principiu, aici se verifica faptul c ˘ | a doar aministratorii au ˘
acces la funct,

ionalitat˘,
ile privilegiate. Sunt validate cazurile de test precum:
- Un cont far˘ a drept de aministrator nu este autorizat pentru crearea de alte ˘ conturi.
- Nu este permis accesul pentru a vedea lista de conturi, a s,
terge un cont, a
oferi drepturi de administrator sau a s,

terge drepturi de aministrator.

În cele din urma, ultima categorie cuprinde testarea doar a funct ˘ | ,
ionalitat˘,
ilor dedicate
administratorilor. Se verifica:˘
- Posibilitatea de creare de conturi noi.
- Interzicerea accesului de a crea un cont nou daca: parolele nu se potrivesc, ˘
parola introdusa este prea scurt ˘ | a, nu cont ˘ | ,
ine majuscula sau nu cont ˘ | ,
ine cel put,

in o
cifra.˘
- S,

tergerea unui cont.

- Incercarea de s,

tergere a unui cont inexistent.

- Acordarea drepturilor de administrator unui anumit cont.
- Acordarea drepturilor de administrator unui cont inexistent.
- Retragerea drepturilor de administrator.
- Retragerea drepturilor de administrator pentru un cont inexistent.

Este important ca prin testele create sa acoperim un procent cât mai mare din în- ˘ treaga aplicat,

ie. Cu toate acestea, trebuie ment,

| | ionat faptul ca, procentul de acoperire nu ˘
este un indicator al calitat˘,
ii testelor, ci doar reprezinta cât de multe funct ˘ | ,

ionalitat˘,
i sunt
acoperite prin cazurile de test.

4.5. TESTAREA SOLUT, IEI | 54

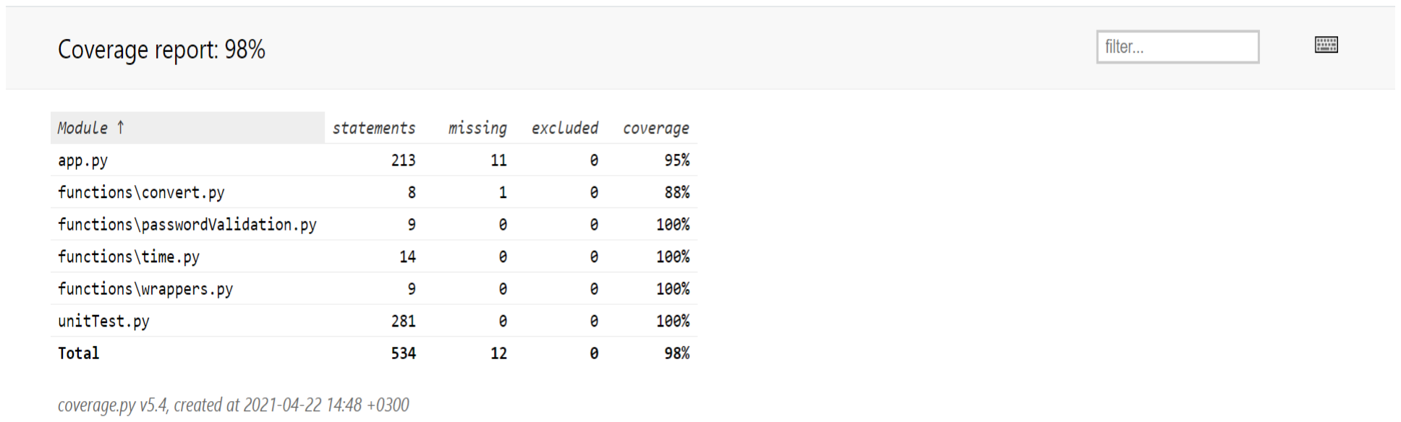
[picture p48: figure]

Figura 4.13: Procent de acoperire

Partea de verificare a instalat,

iei de apa a fost una mai simpl ˘ | a. Dup ˘ | a finalizarea lipi- ˘
turilor conductelor de cupru s,

i montarea garniturilor la fiecare îmbinare, a fost necesara˘ o verificare a faptului ca etans ˘ , eitatea este asigurata. Procesul a constat în introduce- ˘ rea unei presiuni de 2 bari, pe care am ment,

inut-o în circuit un timp de 10 minute. În
toata aceast ˘ | a perioad ˘ | a, am monitorizat, cu ajutorul manometrului pompei de aer, faptul ˘
ca presiunea r ˘ | amâne constant ˘ | a. Pentru a m ˘ | a asigura c ˘ | a pompa de ap ˘ | a s ˘ ,
i electrovalvele
funct,
ioneaza corespunz ˘ | ator, am folosit o surs ˘ | a de tensiune de 12 volt ˘ | ,
| | | | | i s,

i am alimentat
fiecare componenta electric ˘ | a în parte. ˘

# Capitolul 5

# Ghidul utilizatorului

În acest capitol voi descrie felul în care utilizatorul poate sa interact ˘ | ,
ioneze cu aplicat,

ia
web, iar în cele din urma voi prezenta una dintre optimiz ˘ | arile esent ˘ | ,
iale aduse sistemului.

## 5.1 Interfat,a cu utilizatorul

Toate paginile au aceeasi structura: antet, meniu de navigare s ˘ | ,
i sect,

iune pentru
afis, area cont,

inutului.
Antet-ul cont,

ine o imagine s,

i un logo.
Bara de navigare se adapteaza in funct,

ie de rolul utilizatorului. Unele butoane devin, sau nu, disponibile.
Sect,

iunea de cont,

inut, aceasta este diferita la fiecare pagina in parte. ˘

Pagina Home – este accesibila pentru tot ˘ | ,
| i utilizatorii s, | i permite monitorizarea si
setarea temperaturii.
Pagina Change password – permite modificarea parolei pentru fiecare utilizator

55

# Capitolul 6

# Concluzii s

,

# i direct

,

# ii de dezvoltare

Intent,

ia pe care am avut-o în momentul în care am început sa lucrez la acest proiect, ˘
a fost sa creez un sistem IoT, care s ˘ | a eficientizeze felul în care energia termic ˘ | a poate ˘
fi gestionata în cadrul imobilului. Funct ˘ | ,

ionalitatea de baza a sistemului este aceea de ˘ a permite setarea temperaturilor diferite pentru fiecare camera în parte. Comparativ cu ˘
celelalte sisteme existente pe piat,a, acest aspect reprezint ˘ | a un plus. De asemenea, sunt ˘
puse la dispozit,

ie o serie de modalitat˘,
i prin care se pot seta temperaturile din cadrul imobilului:
- Metoda standard, prin intermediul butoanelor fizice atas, ate de modulul WiFi.
- Prin utilizarea aplicat,

iei web.

- Utilizând comenzi vocale, interpretate de Google Assistant.

Am reus,

it sa implemetez majoritatea funct ˘ | ,

ionalitat˘,

ilor propuse, însa modul de ope- ˘ rare al unora poate fi îmbunat˘ at˘,
it. Un exemplu sugestiv în acest sens este partea de control prin comenzi vocale a sistemului. Prin intermediul acestora se poate seta o anumita˘
temperatura, îns ˘ | a nu se poate ajusta temperatura setat ˘ | a prin increment sau decrement de ˘
un °C. Setul de comenzi nu este unul complex, iar timpul de raspuns al sistemului este ˘ destul de mare.

În ceea ce prives,
te partea de dezvoltare ulterioara a proiectului, t ˘ | ,
in sa ment ˘ | ,

ionez ca˘
sunt o serie de aspecte a caror implementare poate cres ˘ | ,
te gradul de utilitate s,

i eficient,a
sistemului.
În varianta actuala, întarzierea între momentul în care se trimite o comand ˘ | a vocal ˘ | a s ˘ ,
i
momentul în care se primes,
te un raspuns, ajunge s ˘ | a fie de aproximativ un minut. Acest ˘
timp poate fi redus daca se utilizeaz ˘ | a servicii puse la dispozit ˘ | ,
ie de Google, contracost, ce
interpreteaza comenzile primite de Google Assistant s ˘ | ,
i trimite informat,

iile interpretate
în Firebase.

56

57

Pentru a putea modifica datele de conectare la ret,ea ale modulului wireless, trebuie
sa se modifice credent ˘ | ,
ialele în codul sursa. O imbun ˘ | at˘ at˘,

ire ar consta în adaugarea unei ˘ tastaturi s,

i posibilitatea de a modifica credent,

ialele prin intermediul acesteia.
O alta funct ˘ | ,
ionalitate ce poate fi adaugat ˘ | a este posibilitatea detect ˘ | arii telefoanelor ˘
mobile ale locatarilor, iar temperatura din imobil sa se adapteze în funct ˘ | ,
ie de prezent,a
sau absent,a acestora.

# Lista de figuri ˘

1.1 Evolut,

ia numarului de dispozitive IoT (sursa: [6]) | ˘ | 4
3.1 Semnal înainte de filtrul trece jos | | 17
3.2 Semnal dupa filtrul trece jos | ˘ | 17
3.3 Schema filtru trece-jos (sursa: [20]) | ˘ | 18

4.1 Cazurile de utilizare pentru aplicat,

ia web | | 21
4.2 Cazurile de utilizare pentru ansamblul de componente electronice . . . | 23
4.3 Arhitectura sistemului | | 24
4.4 Arhitectura modulului senzor | | 25
4.5 Arhitectura modulului de control | | 28
4.6 Diagrama de clase | ˘ | 29
4.7 Mod de operare far˘ a conexiune la internet | ˘ | 30
4.8 Mod de operare pe intervale orare | | 31
4.9 Mod operare clasic | | 33
4.10 Intrare HTML pentru formatul timp | | 47
4.11 Intrare HTML pentru formatul numeric | | 47
4.12 Stocare program intervale orare | | 50
4.13 Procent de acoperire | | 54

58

# Lista de tabele ˘

59

# Bibliografie

[1] Stephen Ornes. Core concept: The internet of things and the explosion of interconnectivity. Proceedings of the National Academy of Sciences, 113(40):11059– 11060, 2016.
[2] simoniot. https://www.simoniot.com/history-of-iot/. [Data accesarii: 01.03.2021]. ˘
[3] Cristiano André da Costa, Cristian F. Pasluosta, Björn Eskofier, Denise Bandeira da Silva, and Rodrigo da Rosa Righi. Internet of health things: Toward intelligent vital signs monitoring in hospital wards. Artificial Intelligence in Medicine, 89:61– 69, 2018.
[4] L. Yushi, J. Fei, and Y. Hui. Study on application modes of military internet of things (miot). In 2012 IEEE International Conference on Computer Science and Automation Engineering (CSAE), volume 3, pages 630–634, 2012.
[5] K. Abboud, H. A. Omar, and W. Zhuang. Interworking of dsrc and cellular network technologies for v2x communications: A survey. IEEE Transactions on Vehicular Technology, 65(12):9457–9470, 2016.
[6] Arne Holst. https://www.statista.com/statistics/1183457/iot-connected-devicesworldwide/. (https://www.statista.com/statistics/1183457/iot-connected-devices-worldwide/) [Data accesarii: 01.03.2021]. ˘
[7] Emag. https://www.emag.ro/termostat-inteligent-universal-pentru-centrala-gazwifi-comandat-de-pe-smartphone-internet-compatibil-google-home-si-alexator2000gclw/pd/D0BN1LBBM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. (https://www.emag.ro/termostat-inteligent-universal-pentru-centrala-gaz-wifi-comandat-de-pe-smartphone-internet-compatibil-google-home-si-alexa-tor2000gclw/pd/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) [Data accesarii: 03.03.2021]. ˘
[8] Emag. | https://www.emag.ro/termostat-smart-honeywell-lyric-t6r-
wireless-amplasat-pe-masa-comandat-de-pe-smartphone-y6h910rw4055/pd/ DP2V6SBBM/. (https://www.emag.ro/termostat-smart-honeywell-lyric-t6r-wireless-amplasat-pe-masa-comandat-de-pe-smartphone-y6h910rw4055/pd/DP2V6SBBM/) [Data accesarii: 03.03.2021]. ˘
[9] Amazon. https://www.amazon.com/Nest-T3007ES-Thermostat-Temperature-Generation/dp/B0131RG6VK/. (https://www.amazon.com/Nest-T3007ES-Thermostat-Temperature-Generation/dp/B0131RG6VK/) [Data accesarii: 03.03.2021]. ˘
[10] Amazon. https://www.amazon.com/ecobee3-lite-Smart-Thermostat-Black/dp/B06W56TBLN/. (https://www.amazon.com/ecobee3-lite-Smart-Thermostat-Black/dp/B06W56TBLN/) [Data accesarii: 03.03.2021]. ˘
| 60

BIBLIOGRAFIE | 61
[11] Eric Blank. | https://thesmartcave.com/ecobee-vs-nest/. | [Data accesarii: ˘
03.03.2021].
[12] Guido Van Rossum et al. | Python. | https://courses.minia.edu.eg/Attach/
16028python_lecture1.pdf, (https://courses.minia.edu.eg/Attach/16028python_lecture1.pdf) 1991. [Data accesarii: 15.03.2021]. ˘
[13] Miguel Grinberg. Flask web development: developing web applications with python. " O’Reilly Media, Inc.", 2018.
[14] Bjarne Stroustrup. The C++ programming language. Pearson Education India, 2000.
[15] Mohamed Fezari and Ali Al Dahoud. Integrated development environment “ide” for arduino. WSN applications, pages 1–12, 2018.
[16] Espressif | Systems. | https://components101.com/asset/sites/default/files/
component_datasheet/ESP8266-NodeMCU-Datasheet.pdf. (https://components101.com/asset/sites/default/files/component_datasheet/ESP8266-NodeMCU-Datasheet.pdf) | [Data accesarii: ˘
21.03.2021].
[17] Mircea Popa. Sisteme Încorporate. Curs Anul 3 CTI, Curs 9.
[18] Handson Technology. http://www.handsontec.com/dataspecs/module/I2C_1602_LCD.pdf. (http://www.handsontec.com/dataspecs/module/I2C_1602_LCD.pdf) [Data accesarii: 20.03.2021]. ˘
[19] Mantech. http://www.mantech.co.za/Datasheets/Products/433Mhz_RF-TX&RX. pdf. (http://www.mantech.co.za/Datasheets/Products/433Mhz_RF-TX&RX.pdf) [Data accesarii: 21.03.2021]. ˘
[20] Jack G Ganssle. A guide to debouncing. Guide to Debouncing, Ganssle Group, Baltimore, MD, US, pages 1–22, 2004.
