VitomirDragan/TemperatureManagement-IOT-/Documentatie/DiplomaProject/bin/main.pdf

Universitatea Politehnica Timis, oara Facultatea de Automatica s ˘ ,
i Calculatoare
Departamentul Calculatoare s,

i
Tehnologia Informat,
iei

## TITLU

Proiect de Diploma˘

### Autor

Conducator s ˘ ,tiint,

### ific

Conf. dr. ing. . . .

Timis, oara
Iunie, 2018

# Cuprins

1 Introducere | 3

1.2.1 Referire la un capitol / sect,

1

2 | CUPRINS

# Capitolul 1

# Introducere

## 1.1 Prima sectiune

Exemplu de citare [1].

## 1.2 Listing de cod

Exemplu de l i s t i n g de cod

### 1.2.1 Referire la un capitol / sect,iune

In capitolul 1.2 . . .

3

4 | CAPITOLUL 1. INTRODUCERE

# Lista figurilor

5

6 | LISTA FIGURILOR

# Lista tabelelor

7

8 | LISTA TABELELOR

# Bibliografie

[1] Erich Gamma, Richard Helm, Ralph Johnson, and John Vlissides. Design Patterns CD: Elements of Reusable Object-Oriented Software. Addison-Wesley Professional, 1998.

9
