VitomirDragan/TemperatureManagement-IOT-/Diagrame/Arhitectura sistemului.png

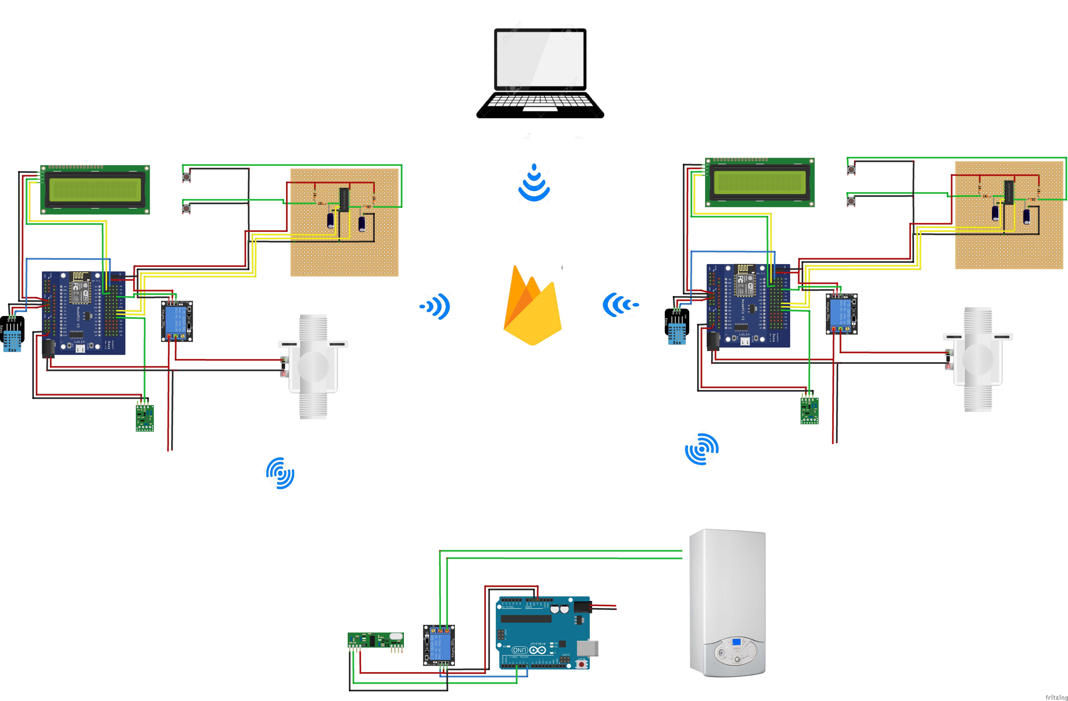
Diagrame/Arhitectura sistemului.png
