VitomirDragan/TemperatureManagement-IOT-/Diagrame/Arhitectura sistemului_complet.png

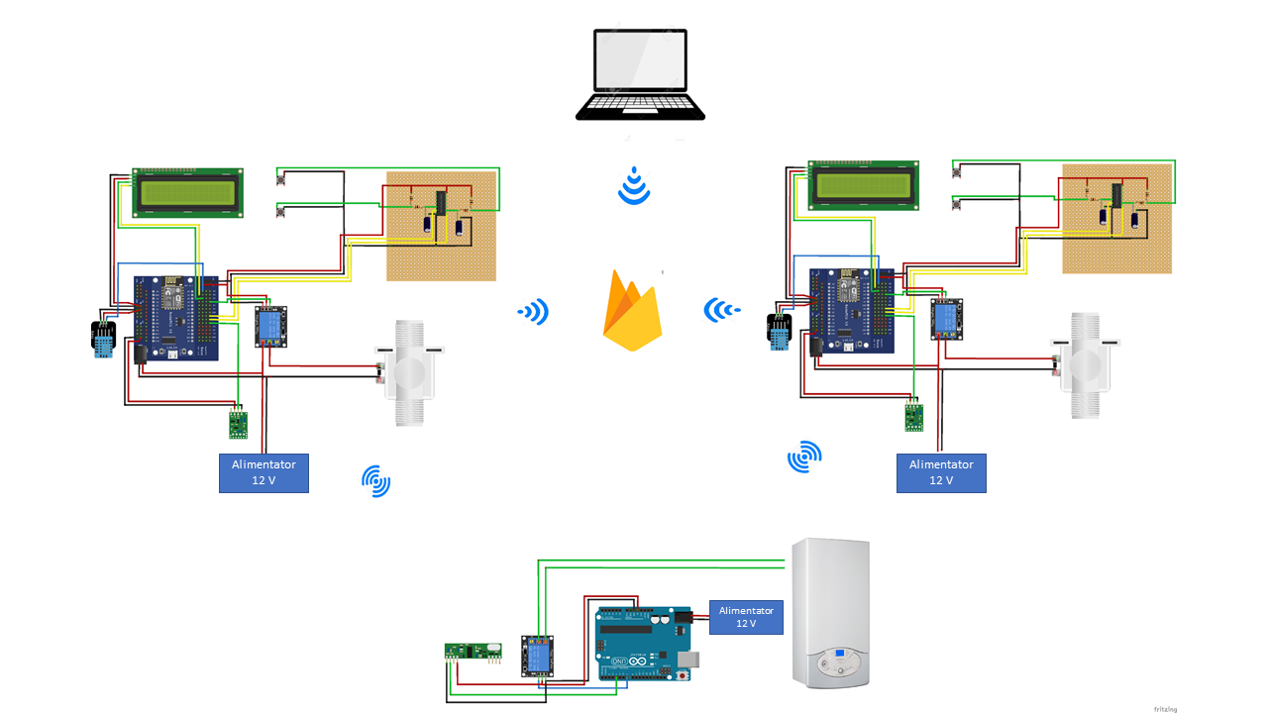
Diagrame/Arhitectura sistemului_complet.png
