VitomirDragan/TemperatureManagement-IOT-/Diagrame/Arhitectura sistemuluiREC_bb.jpg

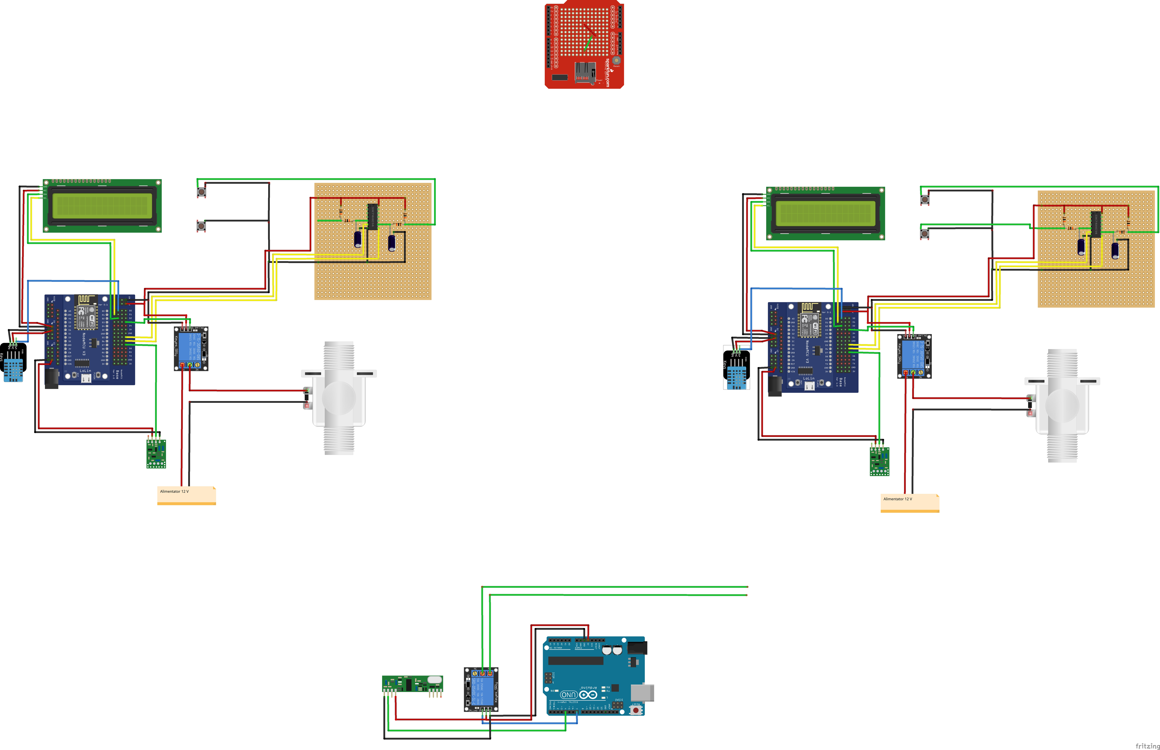
Diagrame/Arhitectura sistemuluiREC_bb.jpg
