VitomirDragan/TemperatureManagement-IOT-/Diagrame/Arhitectura sistemuluiREC_bb.png

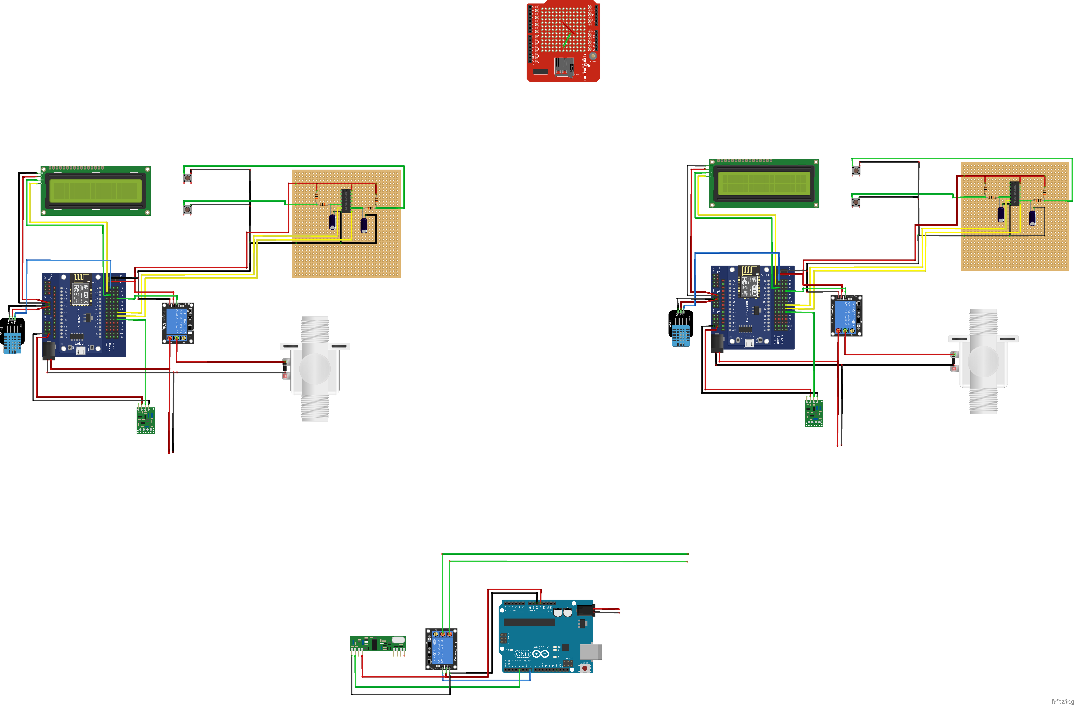
Diagrame/Arhitectura sistemuluiREC_bb.png
