VitomirDragan/TemperatureManagement-IOT-/Diagrame/Arhitectura sistemuluiREC_bb_complet.jpg

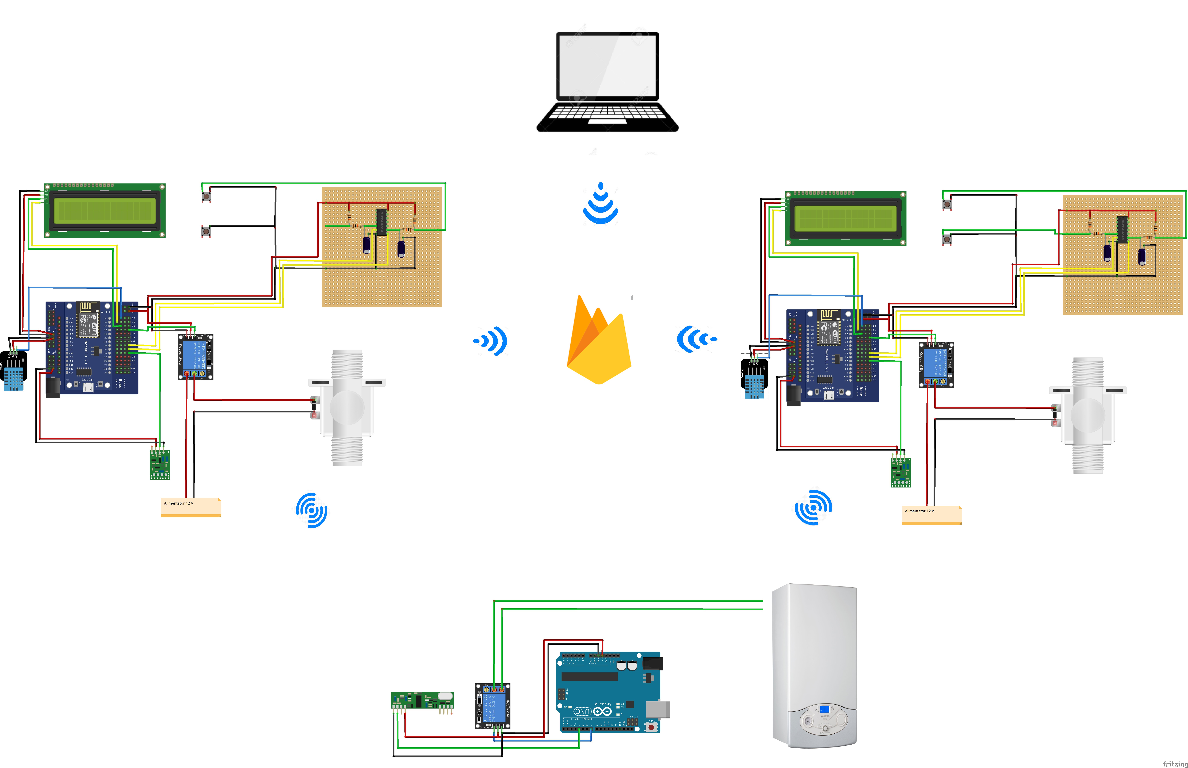
Diagrame/Arhitectura sistemuluiREC_bb_complet.jpg
