VitomirDragan/TemperatureManagement-IOT-/Diagrame/centrala.webp

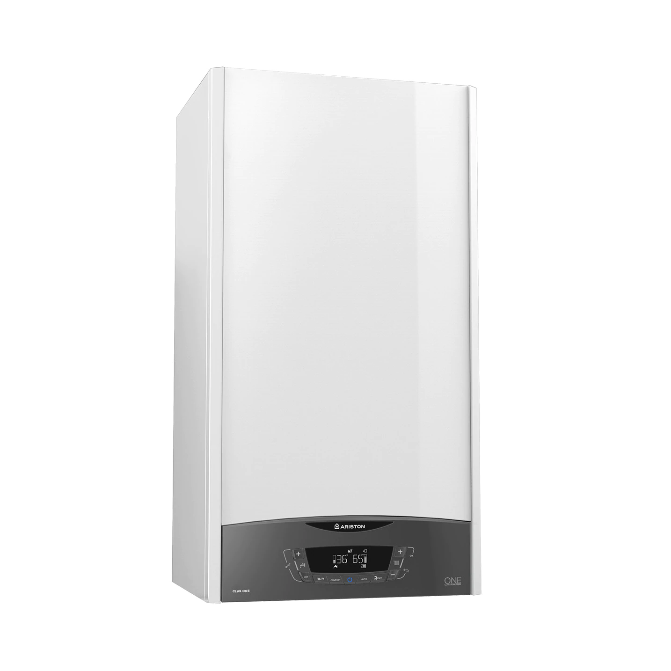
Diagrame/centrala.webp
