VitomirDragan/TemperatureManagement-IOT-/Diagrame/ModulSenzor.png

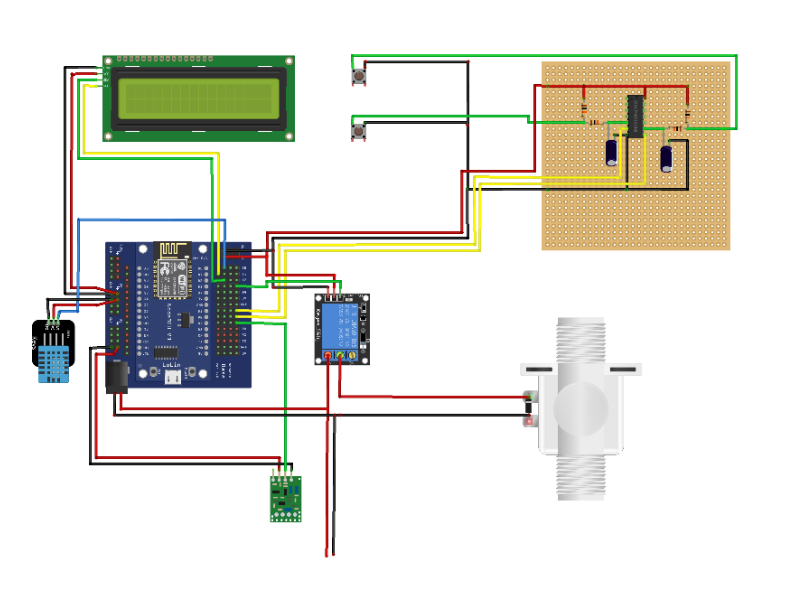
Diagrame/ModulSenzor.png
