VitomirDragan/TemperatureManagement-IOT-/Diagrame/rf.png

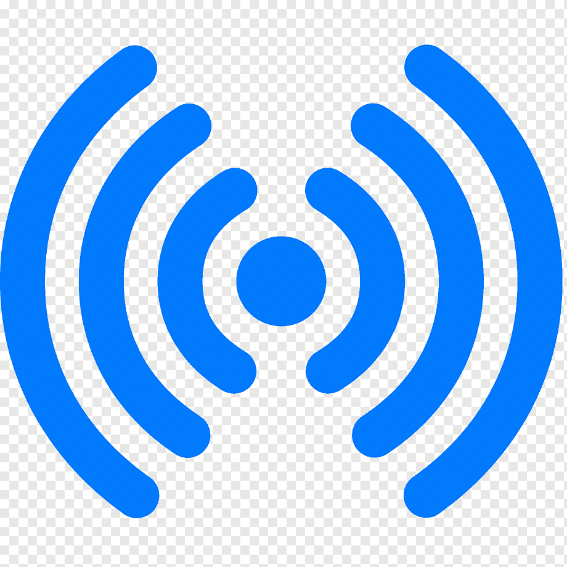
Diagrame/rf.png
