VitomirDragan/TemperatureManagement-IOT-/Documentatie/DiplomaProject/fig/ModulSenzor.PNG

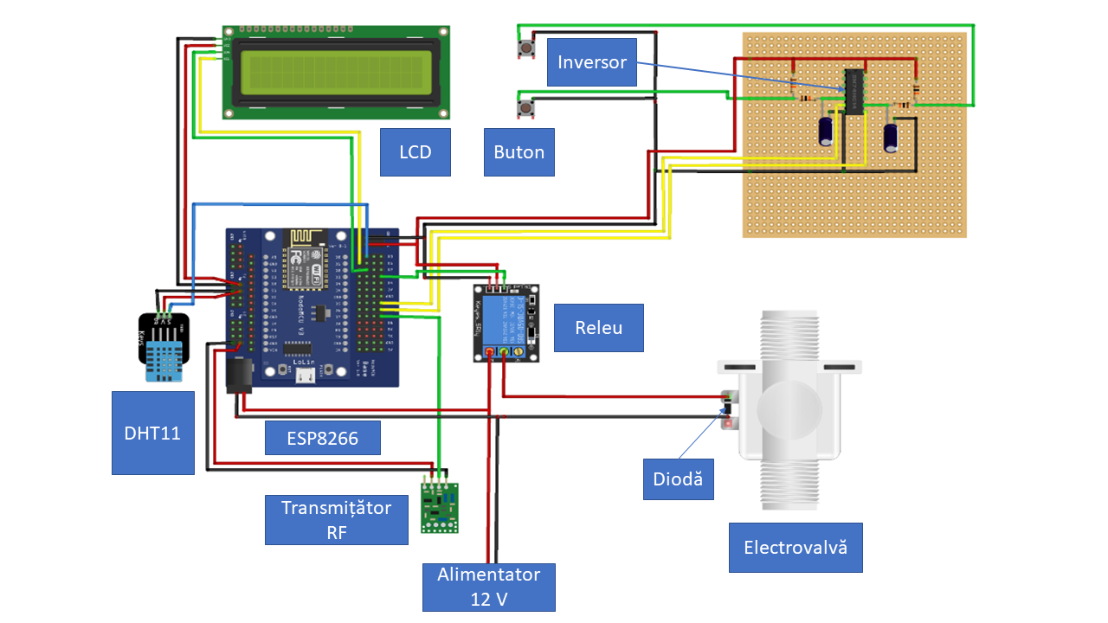
Documentatie/DiplomaProject/fig/ModulSenzor.PNG
