VitomirDragan/TemperatureManagement-IOT-/Prezentare/Intervale.PNG

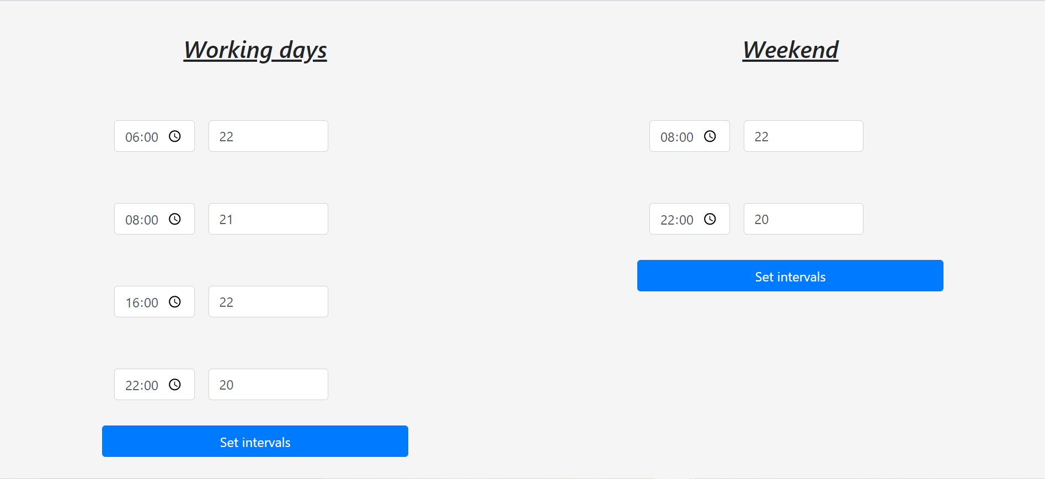
Prezentare/Intervale.PNG
