VitomirDragan/TemperatureManagement-IOT-/Prezentare/Zapier.png

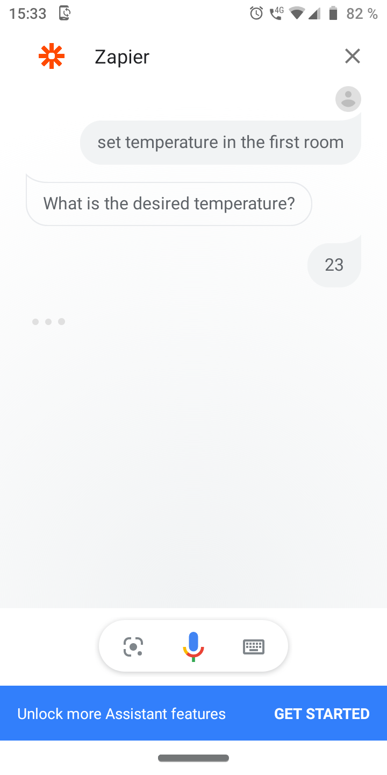
Prezentare/Zapier.png
