VitomirDragan/TemperatureManagement-IOT-/Diagrame/Calibrare DHT11.xlsx

DHT11-1 | Hygrometru | DHT11-1 | Termometru
64 | 60 | 20 | 20
52 | 45 | 24 | 25 | 20 | 21.5
DHT11-2 | Hygrometru | DHT11-2 | Termometru
63 | 60 | 21 | 20
54 | 45 | 24 | 25 | 21 | 21.5
