VitomirDragan/TemperatureManagement-IOT-/Diagrame/Calibrare DHT11 - Copy.xlsx

DHT11-1 | Hygrometru | DHT11-1 | Termometru
64 | 60 | 20 | 20
52 | 45 | 20 | 21.5 | 20 | 21.5
 |  | 24 | 25
DHT11-2 | Hygrometru | DHT11-2 | Termometru
63 | 60 | 21 | 20
54 | 45 | 21 | 21.5 | 21 | 21.5
 |  | 24 | 25
