VitomirDragan/TemperatureManagement-IOT-/(list of files, drawings)

Other design files:
Diagrame/Arhitectura sistemuluiREC.fzz
