VitomirDragan/TemperatureManagement-IOT-/(commit log)

2020-08-03 Implemented the communication between Arduino and Firebase
2020-08-09 Added prototype for web application
2020-08-17 Added relays
2021-02-25 Added listener for temperature
2021-02-26 Arduino listeners
2021-03-27 Modified bibfile
    [Arhitectura sistemului.fzz, Arhitectura sistemuluiREC.fzz]
2021-04-01 Start ch4
    [Arhitectura sistemuluiREC.fzz]
2021-04-29 Mici modificari + adaugare calcule
    [Arhitectura sistemului.fzz, Arhitectura sistemuluiREC.fzz]
2021-05-01 Inainte de calibrare DHT11
    [Calibrare DHT11.xlsx]
2021-05-03 Rezolvat bug oprire de siguranta
    [Calibrare DHT11 - Copy.xlsx, Calibrare DHT11.xlsx]
2021-05-10 Diagrame de secventa
2021-05-12 Proiectare detaliată - diagrame de clasa si de secvente
2021-05-18 Modificat schema de la arhitectura sistemului
2021-06-02 Am modificat caract la state of the art
2021-06-07 Modificare structura
    [Arhitectura sistemuluiREC.fzz, Calibrare DHT11 - Copy.xlsx, Calibrare DHT11.xlsx]
2021-06-12 Modificari power point
